EpicQuestBio/MR1/renders/nanopore_scale_showcase.gif

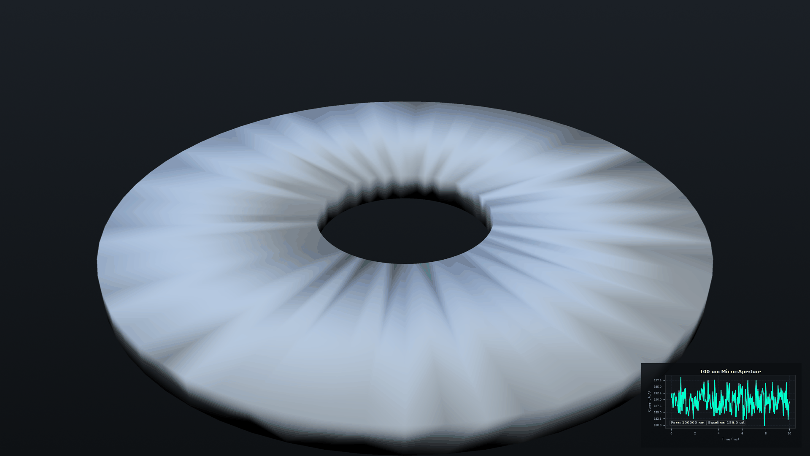
renders/nanopore_scale_showcase.gif
