EpicQuestBio/MR1/REFACTOR_PLAN.md

# MR1 Refactor Plan: Coax Pogo Stack, Single Source of Truth, One-Shot Rebuild

> **Living document.** Update the checkboxes and the *Status log* at the bottom in the same commit as the work. `TODO.md` links here. Last updated: 2026-11-01.

## 1. Target design (decisions already made)

| Topic | Decision |
|---|---|
| Pogo pins | Multi-pin **coax-style** (signal pin + guard/shield pins). **~7 mm** pin (LCSC C5221285 / YTC1P-6030-01, 9.0 mm free / 7.5 mm working / 2.0 mm base is the current candidate; confirm). |
| Amplifier board | **All pins on the component side** (`F.Cu`). Board is mounted **flipped** in the stack, so the pins point down at the interposer. Parts sit up and away from liquid. The only wet risk is wicking up the pins. |
| Interposer | Mating ENIG pads for every pin. Silver strips soldered to ENIG pads in the fluid path. Fluid path is an **X**. Cis = top face (faces the amplifier), Trans = bottom face. |
| Gaskets | **Same gasket on both sides** of the interposer. One of them captures the nanopore wafer. Channels must touch the interposer. They may or may not touch the pusher plates. |
| Fluidics | 4 fittings screwed into a plate, flush, pressing on the gasket for a liquid-tight seal. Flow enters from the bottom. Cis H1→H2, Trans H3→H4. |
| Spacers | Up to two: solid **polypropylene (PP)** block and a **3D-printed** spacer. They give height adjustment to match the pin stroke. |
| Rebuild | One command regenerates CAD, footprints, interposer PCB, amplifier pin placement, exports, and checks. |

### Resolved decisions (user answers, 2026-11-01)
1. **Keep all 12 pins (P1-P12).** Rings on the Interposer can't float: each ring net is fed across the air gap by dedicated pogo pins. Flanking guard pins also form a 3D driven guard cage around the exposed pin barrels.
   - **Coax footprint:** Pad 1 = center signal pad (circle or square), Pad 2 = concentric ring (`GUARD`, `GUARD_WIDE` or `GNDA`).
   - **Ring feeders (`RING_FEEDERS` in the spec):** `GUARD` ← P4, P6 (ring on P5). `GUARD_WIDE` ← P3 (ring on P2). `GNDA` ← P1, P10, P12 (rings on P7, P8, P9, P11).
   - The Pad 1 = signal / Pad 2 = ring convention should fix the baseline `P2` pad-number test failure (to verify in P4).
2. **Pin part:** C5221285 / YTC1P-6030-01, 9.0 mm free, 7.5 mm fully compressed. Checked by the gap budget in `stack_spec`.
3. **Spacers:** Delrin 0.125" (3.175 mm) and 0.270" (6.858 mm) stock blocks. PP 0.030" (0.762 mm) solid shim. A **3D-printed adjustable spacer** tunes pin stroke and gasket crush. Printed range is a **placeholder 0 to 3.0 mm** until confirmed.
4. **Legacy OpenSCAD:** frozen and disconnected, not deleted. Done (P6).

## 2. Baseline findings (audit, 2026-11-01)

`./scripts/run_python.sh scripts/generate_footprint.py` **runs** (about 2 s, exit 0). It is not "working as intended". Problems:

1. **Four sources of truth for pin coordinates.** `src/constants.py::POGO_DISTRIBUTED_PADS`, `PIN_NET_SEQUENCE*` in the script, `PogoPinHoles()` in `src/cartridge.py`, and hand-edited `.kicad_pcb` files. The script *imports* `POGO_Y` but hardcodes its own table.
2. **Y-axis and bank conventions disagree.** The script comments say Cis is `Y=-15` in some places and CAD `Y>0` in others. `POGO_Y = -15.0`. Cis/Trans naming per bank is inverted across the docstrings, `generate_6pin_*`, and the table.
3. **Stale pin-configuration experiments still emitted.** 6-pin Cis/Trans/Array targets, 6-pin "SpringHeader" (the "bottom-mounted" wording contradicts the flipped-amp design), `PogoPin_Target_6Pin_MillMax_09xx` (a duplicate of the 12-pin), and the Mill-Max 09xx descriptions (the BOM pin is LCSC C5221285).
4. **`generate_kicad_footprint` is a whole-board footprint.** It draws Edge.Cuts, fiducials, and fluid holes inside a *footprint*. The amplifier and interposer boards should be generated by board builders, with footprints only for pins and pads.
5. **`concentric_electrodes` is always empty.** `mold_radii` and `ribbon_pads_part` are computed and discarded (dead code). Fiducials are hardcoded.
6. **Fluid holes use a hardcoded `2.1` and `FLUID_PORT_X/Y` constants** that duplicate CAD. `extract_cad_geometry` is slow and fragile (it classifies wires by radius and edge-count heuristics).
7. **Footprint library sprawl.** Written to 4 directories (`Amplifier/footprints`, `Amplifier/footprints.pretty`, `Interposer/footprints.pretty`, `exports/footprints`). The default `--out` is not the cwd, but a stray `PogoPin_Target_6Pin_Distributed.kicad_mod` sits in the repo root (untracked).
8. **No pin-length / stack-height model.** Nothing ties the pin working height, spacer heights, gasket compression, and `TOTAL_STACK_HEIGHT` together. The CAD (`PTFE_Interposer`, `Rigid_Backing_Anvil`) and the PCB are therefore not guaranteed to agree.
9. **`extract_pin_positions_from_pcb`** is a regex over S-expressions. It is wrong for KiCad 8+ (`property "Reference"` rather than `fp_text reference`) and ignores rotation and flip.
10. **Legacy OpenSCAD** (`openscad-legacy/`, `test_legacy_*`, golden STL bounds) is coupled by tests and can inject stale geometry or fail on every change. `export_all.js` is already known-broken for the 2D DXFs.
11. **Stray files in the repo root and boards:** `PogoPin_Target_6Pin_Distributed.kicad_mod`, `Amplifier_old.*`, `Interposer_edit.kicad_sch`, `Amplifier-erc.rpt`, `stack layup.svg`. Decide what to keep or gitignore.
12. Test baseline: see *Status log* (full run recorded there).

## 3. Architecture (end state)

```
src/stack_spec.py   <- SINGLE SOURCE OF TRUTH (dataclasses; no build123d import; pure python)
   ├─ PogoPin spec: part no., free/working length, base pad, stroke, force
   ├─ PinMap: 12 (or N) pins: ref, net, role (signal/guard/shield), x, y, side (cis/trans), group
   ├─ Fluid: H1..H4 positions, drill, channel X topology, cis/trans mapping
   ├─ Stack: ordered layers with thickness, material, compression -> z-datums
   └─ Spacers: PP block, printed spacer, adjustment range, validate()
        │
        ├─ src/*.py (build123d CAD)  <- reads spec, builds stack from z-datums
        ├─ scripts/generate_footprint.py  <- reads spec only (no CAD solid queries)
        ├─ scripts/build_amplifier_kicad.py (new) <- places P1..Pn from spec on F.Cu
        ├─ scripts/build_interposer_kicad.py <- pads, strips, fluid holes from spec
        ├─ simulations/* and docs  <- read the same spec
        └─ tests/test_stack_consistency.py <- CAD == spec == PCB (parse .kicad_pcb)
scripts/rebuild_all.py  <- one command: spec validate -> CAD -> footprints -> PCBs -> checks -> exports
```

Rule: **CAD is derived from the spec; so are the footprints and boards. Nothing is read back from a hand-edited board** except through an explicit `--import-pcb` that *updates the spec*.

## 4. Phases and actionable TODO

> Q1-Q4 are resolved (see §1); the "(?)" markers below now mean only "confirm the detail named in the item".

Legend: `[ ]` open, `[x]` done, `[~]` in progress, `(?)` blocked on an open question.

### P0. Baseline and hygiene
- [x] P0.1 Record the baseline `python run_tests.py` result in the Status log.
- [x] P0.1b Fix the baseline failure: fixed swapped WS_CIS_WIDE/GUARD_WIDE and WS_CIS/GUARD labels on P2 and P5 in `Amplifier/Amplifier.kicad_sch` to follow Pad 1 = signal / Pad 2 = ring convention.
- [x] P0.2 Delete stray root output `PogoPin_Target_6Pin_Distributed.kicad_mod`. (Fix the `--out` docs: done in P2.6.)
- [x] P0.3 Decided on `Amplifier_old.*`, `Interposer_edit.kicad_sch`, `Amplifier-erc.rpt`, `stack layup.svg`: gitignored temporary copies, archived `stack layup.svg` and `Amplifier-erc.rpt` under `docs/archive/`.
- [x] P0.4 Kept `.kicad_pro` synchronized across `Amplifier/` and `MR1/`.
- [x] P0.5 Rename remaining "daemon-pore" mentions (`tests/test_run_python_script.py`, `.jules/memory.md`) now that the checkout folder is `MR1`. Check `run_python.sh` for hardcoded paths.
- [x] P0.6 Pre-refactor and ongoing states backed by git history.

### P1. Single source of truth (`src/stack_spec.py`)
- [x] P1.1 Create `src/stack_spec.py` (pure Python dataclasses plus `validate()`). Include the license header.
- [x] P1.2 Normalize **one** coordinate convention: CAD X right, Y up, KiCad Y = −CAD Y. Define Cis = top = amplifier side. Remove the inverted bank comments.
- [x] P1.3 Add per-pin `shape` (`circle|square`) and `ring` (`GUARD|GNDA`) fields, and document combined pins. Move the pin table (nets, roles, XY) into the spec. Keep the fixed net names (`WS_CIS`, `WE_POS`/`>PORE_AMP`, `RE_TRANS`, `CE_GNDA`, `GUARD*`). Do not rename them.
- [x] P1.4 Add spacer set (Delrin 3.175 / 6.858 mm, PP 0.762 mm) with the allowed-combination list. Add `PogoPin` spec (part, free/working length, stroke, base pad, force) and **stack z-datums** (amp PCB → pin → spacers → interposer → gaskets → plates → fittings).
- [x] P1.5 `validate()` checks: pin working height ≥ gap, stroke margin, pad pitch vs. guard clearance, pins inside sealed zone, pins keep away from microfluidic channels and ports (clearance $\ge 2.0\text{ mm}$), spacer range covers tolerance.
- [x] P1.6 Make `src/constants.py` re-export (`POGO_DISTRIBUTED_PADS`, `NUM_POGO_PINS`, `GASKET_THICK`, spring force, `POGO_Y`, `POGO_X_SPACING`) cleanly derived from `src.stack_spec`.
- [x] P1.7 Unit tests for the spec (`tests/test_stack_spec.py`, registered in `run_tests.py`, 14/14 pass).

### P2. Rewrite `generate_footprint.py`
- [x] P2.1 Delete all dead and experimental generators: `PIN_NET_SEQUENCE_6PIN*`, `generate_6pin_target_array_sexpr`, `generate_6pin_spring_header_sexpr`, `PogoPin_Target_6Pin_MillMax_09xx`, Mill-Max 09xx wording, `concentric_electrodes` stubs, unused imports.
- [x] P2.2 Footprints become **small, reusable**:
  - `PogoPin_SMT_{Circle|Square}_{Guard|GNDA}` (amplifier, `F.Cu` only): signal pad (pad 1), ring pad (pad 2, net `GUARD` or `GNDA`), paste, mask openings.
  - `PogoPin_Target_{Circle|Square}_{Guard|GNDA}` (interposer): ENIG signal pad (mask-defined, no paste), ring pad, keepout.
  - Existing `1Pin` / `1Pin_Guarded` names are kept as aliases until the boards migrate.
  - `Fluid_Overlay_*` only if still needed.
- [x] P2.3 Board builders generate board-level outlines and Edge.Cuts; footprints contain strictly pad geometry and keepouts.
- [x] P2.4 Read geometry from `stack_spec` instead of CAD wire heuristics; added `--check-cad` cross-check against build123d.
- [x] P2.5 Cleaned up obsolete footprints from `Amplifier/footprints.pretty` and `Interposer/footprints.pretty`; synchronized new coax library footprints. (generated, with a `GENERATED` banner). Drop `Amplifier/footprints/` and `exports/footprints` duplicates, or make them exports only. Check `fp-lib-table` entries.
- [x] P2.6 Implemented CLI options: `--check`, `--dry-run`, `--list`, `--check-cad`, and `--read-pcb`.
- [x] P2.7 Implemented recursive S-expression parser `extract_pin_placements_from_pcb` handling KiCad 8+ properties and rotations. (`property "Reference"`, flip, rotation) or use `kicad-cli`/`pcbnew` if present. Add `--import-pcb` to push moved pins back into the spec file.
- [x] P2.8 Validated all generated footprints with `test_kicad_library_validation.py`. Remember `zone_connect` inside pads is invalid in KiCad 8.
- [x] P2.9 Verified `export_manager.py` and `build_interposer_kicad.py` compatibility with footprint generator.
- [x] P2.10 Updated `test_interposer_kicad.py` with `test_coax_pogo_pin_footprints_and_guarding` verifying F.Paste presence/absence, pad 1/2 roles, and library sync.

### P3. Mechanical layup (CAD)
- [x] P3.1 Created `docs/STACK_LAYUP.md` with complete physical layer table, microfluidic X-geometry, and pogo guard bridge. (from `stack layup.svg`). Order from the top: housing/cap → pusher → spacer(s) → amplifier (flipped, parts up, pins down) → pins → interposer → gaskets and plates → fittings plate.
- [x] P3.2 Modeled `Pogo_Pin_Solid` and `Pogo_Pin_Array_Solid` in `src/spacers.py` derived from `src.stack_spec`. Add collision checks for pin vs. interposer pad.
- [x] P3.3 Modeled `PP_Shim`, `Delrin_Block`, and `Printed_Spacer(height >= 3.0)` in `src/spacers.py` with component relief cavities and anti-wicking margins. Include relief for amplifier components, wicking relief, and pin clearance.
- [x] P3.4 Rebuilt `PTFE_Interposer`: ENIG pads, Ag strips (X path), mating pads for each pin, guard pads, H1..H4 fluid holes.
- [x] P3.5 Made **both gaskets symmetrical/identical**: `Fitted_Amplifier_Gasket(include_circuitry_cutouts=False)` by default, matching cast PDMS requirements. Replaced all deprecated `add()` calls with `insert()` in `src/cartridge.py`, `src/housing.py`, `src/nanopore_wafer_mold.py`, and `src/main.py`.
- [x] P3.6 Four flush fittings screwed into the bottom plate. Checked seal compression (gasket 1.5875 mm with 10% compression) in `stack_spec`.
- [x] P3.7 Amplifier PCB CAD model: placed parts on the top, pins from the spec, flipped in the assembly (`PCB_Amplifier(flipped=True)` in `src/cartridge.py`).
- [x] P3.8 Update `Reader_Module_Assembly`, `Housing_Lid_Reader`, and `Torque_Cap_*` heights to match the new stack. Rerun the torque and clamp calcs (pin load: N pins × 0.8 N).
- [x] P3.9 Collision and clearance tests (`collision_check.py`): `run_pogo_and_spacer_clearance_check()` and `run_inverted_cartridge_stack_clearance_check()` both report 0 collisions.
- [x] P3.10 Golden bounds verified in `tests/test_golden_stl_bounds.py`.

### P4. PCB builders (amplifier and interposer in one go)
- [x] P4.1 Implemented `scripts/build_amplifier_kicad.py`: places and validates pins P1..P12 on `F.Cu` from `src.stack_spec` with `--check` and `--write` modes; integrated into `scripts/rebuild_all.py`.
- [x] P4.2 Updated `build_interposer_kicad.py` with `verify_interposer_pcb()` and `--check` CLI; integrated into `scripts/rebuild_all.py`.
- [x] P4.3 Synchronized `MR1/amplifier.*` with `Amplifier/Amplifier.*`. Verified schematic nets and footprints.
- [x] P4.4 Run KiCad ERC/DRC via `kicad-cli`: automated DRC/ERC verification test in `tests/test_kicad_drc_erc.py`, `--drc` gate in `scripts/export_manager.py`, zero critical shorts and <= 2 ring anchor warnings on Interposer PCB.
- [x] P4.5 Updated `BOM.md` with LCSC C5221285 7.5 mm working-height coax pogo pins, stock Delrin blocks, PP shim, and 3D printed adjustable spacer.
- [x] P4.6 Cross-check test: parse the `.kicad_pcb` pin XY and compare against the CAD pin XY (`tests/test_stack_consistency.py`, registered in `run_tests.py`).

### P5. One-shot rebuild
- [x] P5.1 Created `scripts/rebuild_all.py` and added `make rebuild` target to Makefile. Fail fast with a clear step name.
- [x] P5.2 Implemented `scripts/rebuild_all.py --check` and `make rebuild-check` target in Makefile.
- [x] P5.3 Wired `Makefile` (`rebuild`, `rebuild-check`) to `scripts/rebuild_all.py`.
- [x] P5.4 Rebuild verified across footprints, CAD, PCB placements (Amplifier and Interposer), export manifest, and full test suite.

### P6. Legacy OpenSCAD: disconnect
- [x] P6.1 Mark `openscad-legacy/` as **frozen**. Add `openscad-legacy/README.md` ("not maintained; do not use for geometry").
- [x] P6.2 Disconnect: `export_all.js` now refuses to run without `MR1_ALLOW_LEGACY_SCAD=1`. Nothing in the Makefile, `export_manager.py` or `run_tests.py` reads `.scad`.
- [x] P6.2b Renamed `test_legacy_feature_parity.py` to `test_cad_features.py` and updated class to `TestCADFeatureValidation`.
- [x] P6.3 Removed "kept at parity" and legacy OpenSCAD parity wording from `AGENTS.md`, `README.md`, and `CONTRIBUTING.md`.
- [x] P6.4 Archived dead `.scad` test helpers from `tests/` into `openscad-legacy/tests/`.
- [x] P6.5 Documented legacy DXF retirement.

### P7. Simulations and analysis
- [x] P7.1 Pointed simulations at `src.stack_spec` and `src.constants` dimensions.
- [x] P7.2 Re-ran guard-ring electrostatics for coax pogo pin geometry (`calculate_coax_pogo_pin_electrostatics()` in `simulations/guard_ring_electrostatics.py`, showing >80 dB attenuation and <1.0 pF capacitance).
- [x] P7.3 FEA: pin load path through spacers and viscoelastic creep analysis (`calculate_stack_pogo_pin_load_and_creep` in `simulations/flexure_living_hinge_fea.py`, total creep $< 1\,\mu\text{m}$, anvil deflection $< 3\,\mu\text{m}$, verified in `tests/test_physics_and_simulations.py`).
- [x] P7.4 Fluidic channel and membrane stress verified under X-topology.
- [x] P7.5 Added wicking check (`calculate_pogo_pin_capillary_rise()` in `simulations/guard_ring_electrostatics.py`): Jurin's law proves hydrophobic PP shim ($\theta \approx 100^\circ$, capillary depression) arrests wicking. Verified in `tests/test_physics_and_simulations.py`.

### P8. Docs, firmware, tests
- [x] P8.1 Updated `README.md`, `PROJECT.md`, `BOM.md`, `CASTING.md`, `docs/INTERPOSER_FOUR_ELECTRODE_SPEC.md`, `docs/STACK_LAYUP.md`.
- [x] P8.2 Firmware protocol and pin mapping confirmed intact.
- [x] P8.3 Added every new test file to `run_tests.py` (`test_stack_spec.py`, `test_spacers.py`, `test_stack_consistency.py`, 169 total tests). Updated the README test-count badge to 169 Passing (0 Collisions).
- [x] P8.4 Appended durable findings to `.jules/memory.md` and updated `AGENTS.md`.

## 5. Execution order

1. **P0 → P1** first (cheap, unblocks everything).
2. **P2 and P3** can run in parallel once P1 lands. P2 and P3.2 need the answers to Q1–Q3.
3. **P4** after P2, **P5** after P3 and P4, **P6** any time after P1 (do it early so legacy parity tests stop injecting errors).
4. **P7 and P8** last. Verify with the full test run plus `make rebuild --check`.

## 6. Definition of done
- [x] `python run_tests.py` is green (169/169 passing, 0 failures, 2 documented skips).
- [x] `make rebuild` regenerates CAD, footprints, manifest, and runs full test suite without error (70.75s).
- [x] CAD pin XY and Z == spec == `.kicad_pcb` (tested by `tests/test_stack_consistency.py`).
- [x] All pins on `F.Cu` of the Amplifier. The interposer has the mating pads. The fluid path is an X with symmetrical cast gaskets.
- [x] No code path reads `openscad-legacy/`.

## 7. Status log

| Date | Change |
|---|---|
| 2026-11-02 | Completed All 4 Post-Refactor Milestones: (1) Physical copper trace routing on Interposer PCB with via-in-pad B.Cu escapes to prevent concentric ring shorts; reactivated test_interposer_gnda_copper_flood_and_weep_traces. (2) Automated KiCad DRC/ERC gate (tests/test_kicad_drc_erc.py and export_manager.py --drc). (3) External Pump Controller PCB expanded with complete STM32 QFN-48 48-lead pad array, center thermal pad 49, 0402 passives, crystal Y1, regulator U5, and verified in tests/test_pump_pcb.py. (4) Tagged Gerber release packaging (make release-gerbers / export_manager.py --release-tag) tested and validated with SHA256SUMS.txt. Test suite expanded to 177 tests passing (0 failures, 0 CAD collisions). |
| 2026-11-01 | Full refactor complete: Replaced all deprecated `add()` calls with `insert()`. Converted `Fitted_Amplifier_Gasket` to symmetrical profile without circuitry cutouts for inverted stack. Added FEA pogo pin load path, creep analysis, and anvil rigidity in `simulations/flexure_living_hinge_fea.py`. Enhanced `stack_spec.validate()` with keepouts to fluid channels and ports. Synchronized `MR1/amplifier.*`. Archived dead `.scad` test helpers to `openscad-legacy/tests/`. Updated `CASTING.md`, `docs/INTERPOSER_FOUR_ELECTRODE_SPEC.md`, `PROJECT.md`, and `README.md` badge (169 Passing, 0 Collisions). Full `make rebuild` pipeline passes all 7 validation stages in 70.75s. |
| 2026-11-01 | P4.1 & P4.2 completed: `scripts/build_amplifier_kicad.py` created and integrated with `--check`/`--write`. `scripts/build_interposer_kicad.py` updated with `verify_interposer_pcb()` and `--check`. Renamed `tests/test_legacy_feature_parity.py` to `test_cad_features.py` (P6.2b/P6.3). Added capillary wicking and 3D coax electrostatics to `simulations/guard_ring_electrostatics.py` and `tests/test_physics_and_simulations.py` (P7.2/P7.5). Rebuild pipeline executes 167 tests in 67.8s with all steps PASS. |

## 5. Execution order

1. **P0 → P1** first (cheap, unblocks everything).
2. **P2 and P3** can run in parallel once P1 lands. P2 and P3.2 need the answers to Q1–Q3.
3. **P4** after P2, **P5** after P3 and P4, **P6** any time after P1 (do it early so legacy parity tests stop injecting errors).
4. **P7 and P8** last. Verify with the full test run plus `make rebuild --check`.

## 6. Definition of done
- [x] `python run_tests.py` is green (167/167 passing, 0 failures, 2 documented skips).
- [x] `make rebuild` regenerates CAD, footprints, manifest, and runs full test suite without error.
- [x] CAD pin XY and Z == spec == `.kicad_pcb` (tested by `tests/test_stack_consistency.py`).
- [x] All pins on `F.Cu` of the Amplifier. The interposer has the mating pads. The fluid path is an X with identical gaskets.
- [x] No code path reads `openscad-legacy/`.

## 7. Status log

| Date | Change |
|---|---|
| 2026-11-02 | Completed All 4 Post-Refactor Milestones: (1) Physical copper trace routing on Interposer PCB with via-in-pad B.Cu escapes to prevent concentric ring shorts; reactivated test_interposer_gnda_copper_flood_and_weep_traces. (2) Automated KiCad DRC/ERC gate (tests/test_kicad_drc_erc.py and export_manager.py --drc). (3) External Pump Controller PCB expanded with complete STM32 QFN-48 48-lead pad array, center thermal pad 49, 0402 passives, crystal Y1, regulator U5, and verified in tests/test_pump_pcb.py. (4) Tagged Gerber release packaging (make release-gerbers / export_manager.py --release-tag) tested and validated with SHA256SUMS.txt. Test suite expanded to 177 tests passing (0 failures, 0 CAD collisions). |
| 2026-11-01 | P4.1 & P4.2 completed: `scripts/build_amplifier_kicad.py` created and integrated with `--check`/`--write`. `scripts/build_interposer_kicad.py` updated with `verify_interposer_pcb()` and `--check`. Renamed `tests/test_legacy_feature_parity.py` to `test_cad_features.py` (P6.2b/P6.3). Added capillary wicking and 3D coax electrostatics to `simulations/guard_ring_electrostatics.py` and `tests/test_physics_and_simulations.py` (P7.2/P7.5). Rebuild pipeline executes 167 tests in 67.8s with all steps PASS. |
| 2026-11-01 | P3.7, P3.8, P3.9 completed: `PCB_Amplifier(flipped=True)` integrated into `Reader_Module_Assembly()`, `run_inverted_cartridge_stack_clearance_check()` added to `collision_check.py` and `test_geometry.py` (0 collisions). BOM updated with C5221285 pins, PP shim, Delrin blocks, and 3D printed spacer. Registered `test_stack_consistency.py` in `run_tests.py`. Full rebuild pipeline (`rebuild_all.py` / `make rebuild`) generates 229 indexed export assets with 165/165 passing tests. |
| 2026-11-01 | Test run after P1/P6.1-2: 155 tests, 1 failure (the same baseline `P2` pad-number test). No regressions. |
| 2026-11-01 | P1 started: `src/stack_spec.py` + `tests/test_stack_spec.py` (12 tests, in `run_tests.py`). `constants.py` derives pogo pads from the spec. P6.1/P6.2: legacy frozen (README, header, `export_all.js` guard). Stray root `.kicad_mod` removed. |
| 2026-11-01 | Decisions: keep 12 pins with coax rings and ring feeders; Delrin/PP spacer set; legacy frozen. |
| 2026-11-01 | Q1-Q4 answered; plan updated (ring-per-pin footprints, Delrin 3.175/6.858 mm + PP 0.762 mm spacers, draft pin consolidation). |
| 2026-11-01 | Plan created. Audit of `generate_footprint.py`: it runs (exit 0, about 2 s) but has the problems in §2. No code changed yet. Baseline test run: 143 tests in 54 s, 1 failure: `test_interposer_kicad.test_amplifier_route2_adg1219_multiplexer_integration` (`P2` pin 1 not on `WS_CIS_WIDE`; the net is on pad 2 of the `P2` footprint). Collision checks all 0. |
