EpicQuestBio/MR1/renders/nanopore_reverse_explosion.gif

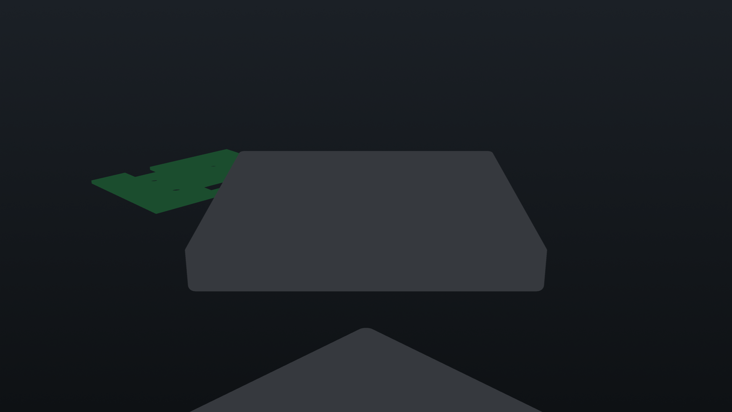
renders/nanopore_reverse_explosion.gif
