EpicQuestBio/MR1/renders/nanopore_wafer_zoom.gif

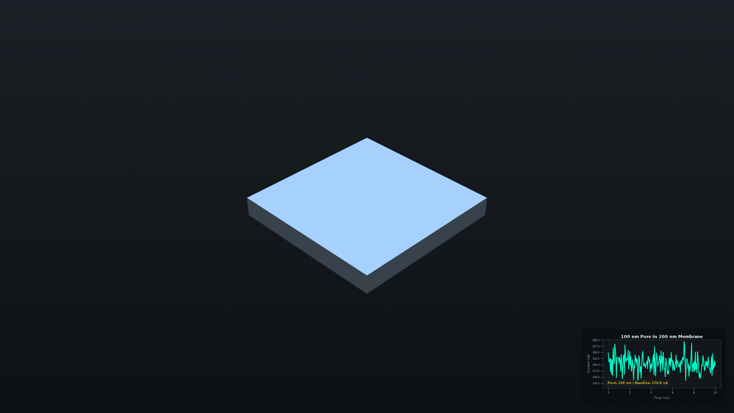
renders/nanopore_wafer_zoom.gif
