EpicQuestBio/MR1/datasheets/LJX39-PP0.stp

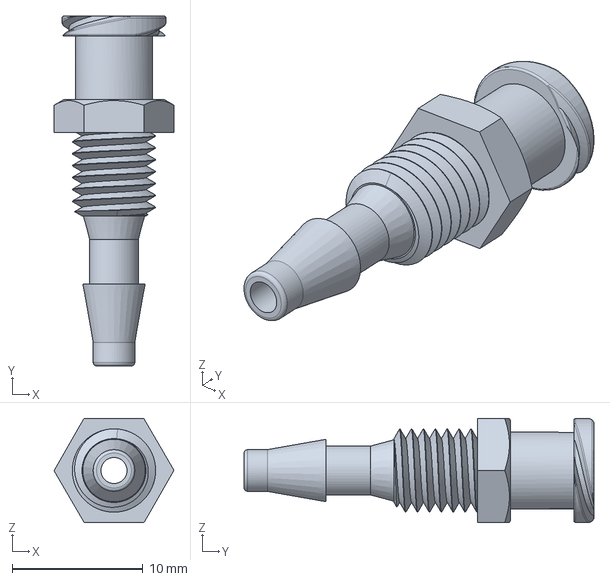
[picture p4: CAD file, 2026-03-28]
datasheets/LJX39-PP0.stp
9.19 x 26.8 x 7.98 mm
