EpicQuestBio/MR1/sentinel_nanopore_reader.scad

// ==============================================================================
// SENTINEL NANOPORE READER - REV 12 (Modular Split)
// Features: Torque-Lock Cap + Round Stack + Bottom Integration + Internal Layout
// ==============================================================================

include <constants.scad>
include <modules/common.scad>
include <modules/cartridge.scad>
include <modules/housing_pump.scad>
include <modules/torque_cap.scad>
include <modules/housing_reader.scad>
include <nanopore_wafer_mold.scad>
include <modules/elbow_adapter.scad>
include <modules/threaded_adapter.scad>


// ==============================================================================
// MAIN RENDER LOGIC
// ==============================================================================

if (Output_Mode == "Assembly") {

    difference() {
        union() {
            // Bottom Unit: Pump Module
            Pump_Module_Assembly();

            // Top Unit: Reader Module
            // Sits on top of Pump Module (Height pump_h + pump_lid_thick)
            translate([0,0, pump_h + pump_lid_thick + Explode_Factor]) {
                Reader_Module_Assembly();
            }

            // Optional 2-Part Silicone Mold Assemblies and Gaskets
            if (Show_Mold) {
                translate([-130, 0, 0]) {
                    Multi_Mold_Visualizer();
                }
            }

            // External Tubing Loops (Visual)
            // Connecting Pump Module Side Ports -> Reader Module Side Ports
            if(!Cross_Section) {
                color("DeepSkyBlue") {
                    // Pump Out (Right Side) -> Reader In (Right Side)
                    // Visual loop on the side

                    // Coordinates
                    p0 = [base_w/2 + 10, 20, pump_h/2]; // Pump Out (Right)
                    p1 = [base_w/2 + 30, 20, pump_h/2]; // Out Clearance
                    p2 = [base_w/2 + 30, 20, pump_h + wall + reader_h - 5]; // Up Z
                    p3 = [base_w/2 + 10, 20, pump_h + wall + reader_h - 5]; // Reader In (Right)

                    hull() { translate(p0) sphere(d=4); translate(p1) sphere(d=4); }
                    hull() { translate(p1) sphere(d=4); translate(p2) sphere(d=4); }
                    hull() { translate(p2) sphere(d=4); translate(p3) sphere(d=4); }
                }
            }
        }

        if(Cross_Section) {
            translate([0, -100, -10]) cube([200, 200, 300]);
        }
    }

    // Labels
    if (Explode_Factor > 0) {
        color("Black") {
            translate([0, -base_l/2 - 20, 0]) text("Rev 12: Modular Split", halign="center");
            translate([150, 0, pump_h + reader_h + neck_h + Explode_Factor*3.5 + 30]) text("Torque-Lock Cap", halign="center");
        }
    }

// --- DXF / STL EXPORTS ---
} else if (Output_Mode == "Plate_1_Base_DXF") {
    Plate_1_Base_Hex();
} else if (Output_Mode == "Plate_2_Channel_DXF") {
    // Legacy name for Carrier Frame
    Carrier_Frame_Hex();
} else if (Output_Mode == "Plate_3_Top_DXF") {
    Plate_3_Top_Hex_2D();
} else if (Output_Mode == "Gasket_Main_DXF") {
    Gasket_Low_Dead_Volume(type="top");
} else if (Output_Mode == "Gasket_Top_DXF") {
    Gasket_Low_Dead_Volume(type="top");
} else if (Output_Mode == "Gasket_Bottom_DXF") {
    Gasket_Low_Dead_Volume(type="bottom");
} else if (Output_Mode == "Gasket_Mold_Top_STL") {
    if (Use_Nanopore_Wafer_Gasket) {
        translate([0, 0, mold_t/2]) rotate([0, 90, 0])
        Nanopore_Wafer_Mold_Right(type="top", is_nanopore=true);
    } else {
        Gasket_Mold_3D(type="top");
    }
} else if (Output_Mode == "Gasket_Mold_Bottom_STL") {
    if (Use_Nanopore_Wafer_Gasket) {
        translate([0, 0, mold_t/2]) rotate([0, -90, 0])
        Nanopore_Wafer_Mold_Left(type="top", is_nanopore=true);
    } else {
        Gasket_Mold_3D(type="bottom");
    }
} else if (Output_Mode == "Amplifier_Gasket_Mold_Left_STL") {
    translate([0, 0, mold_t/2]) rotate([0, -90, 0])
    Nanopore_Wafer_Mold_Left(type="bottom", is_nanopore=false);
} else if (Output_Mode == "Amplifier_Gasket_Mold_Right_STL") {
    translate([0, 0, mold_t/2]) rotate([0, 90, 0])
    Nanopore_Wafer_Mold_Right(type="bottom", is_nanopore=false);
} else if (Output_Mode == "Housing_Pump_Case_STL") {
    Housing_Pump_Case();
} else if (Output_Mode == "Housing_Pump_Lid_STL") {
    Housing_Pump_Lid();
} else if (Output_Mode == "Housing_Reader_Case_STL") {
    Housing_Case_Reader();
} else if (Output_Mode == "Housing_Reader_Lid_STL") {
    Housing_Lid_Reader();
} else if (Output_Mode == "Torque_Cap_Outer_STL") {
    Torque_Cap_Outer();
} else if (Output_Mode == "Torque_Cap_Inner_STL") {
    Torque_Cap_Inner();
} else if (Output_Mode == "Pressure_Puck_STL") {
    Pressure_Puck_3D();
} else if (Output_Mode == "Bottom_Pusher_Plate_STL") {
    Bottom_Pusher_Plate(show_orings=false);
} else if (Output_Mode == "PCB_DXF") {
    // Mapped to Main Reader PCB as per instruction
    PCB_Main_Reader_2D();
} else if (Output_Mode == "PCB_Main_Reader_DXF") {
    PCB_Main_Reader_2D();
} else if (Output_Mode == "PCB_Amplifier_DXF") {
    PCB_Amplifier_2D();
} else if (Output_Mode == "PCB_Nanopore_Carrier_DXF") {
    PCB_Nanopore_Carrier_2D();
}
