EpicQuestBio/MR1/tests/repro_colors.scad

include <../constants.scad>
include <../modules/cartridge.scad>

Cartridge_Stack_3D();
