EpicQuestBio/MR1/(list of files, cad)

Other CAD files:
test_handle.scad
test_render.scad
test_verify.scad
datasheets/LJX39-PP0.stl
openscad-legacy/constants.scad
openscad-legacy/modules/cartridge.scad
openscad-legacy/modules/common.scad
openscad-legacy/modules/housing_pump.scad
openscad-legacy/modules/housing_reader.scad
openscad-legacy/mr1_nanopore_reader.scad
openscad-legacy/nanopore_wafer_mold.scad
openscad-legacy/test_handle.scad
openscad-legacy/test_render.scad
openscad-legacy/test_verify.scad
