EpicQuestBio/MR1/MR1/PDF/MR1.pdf

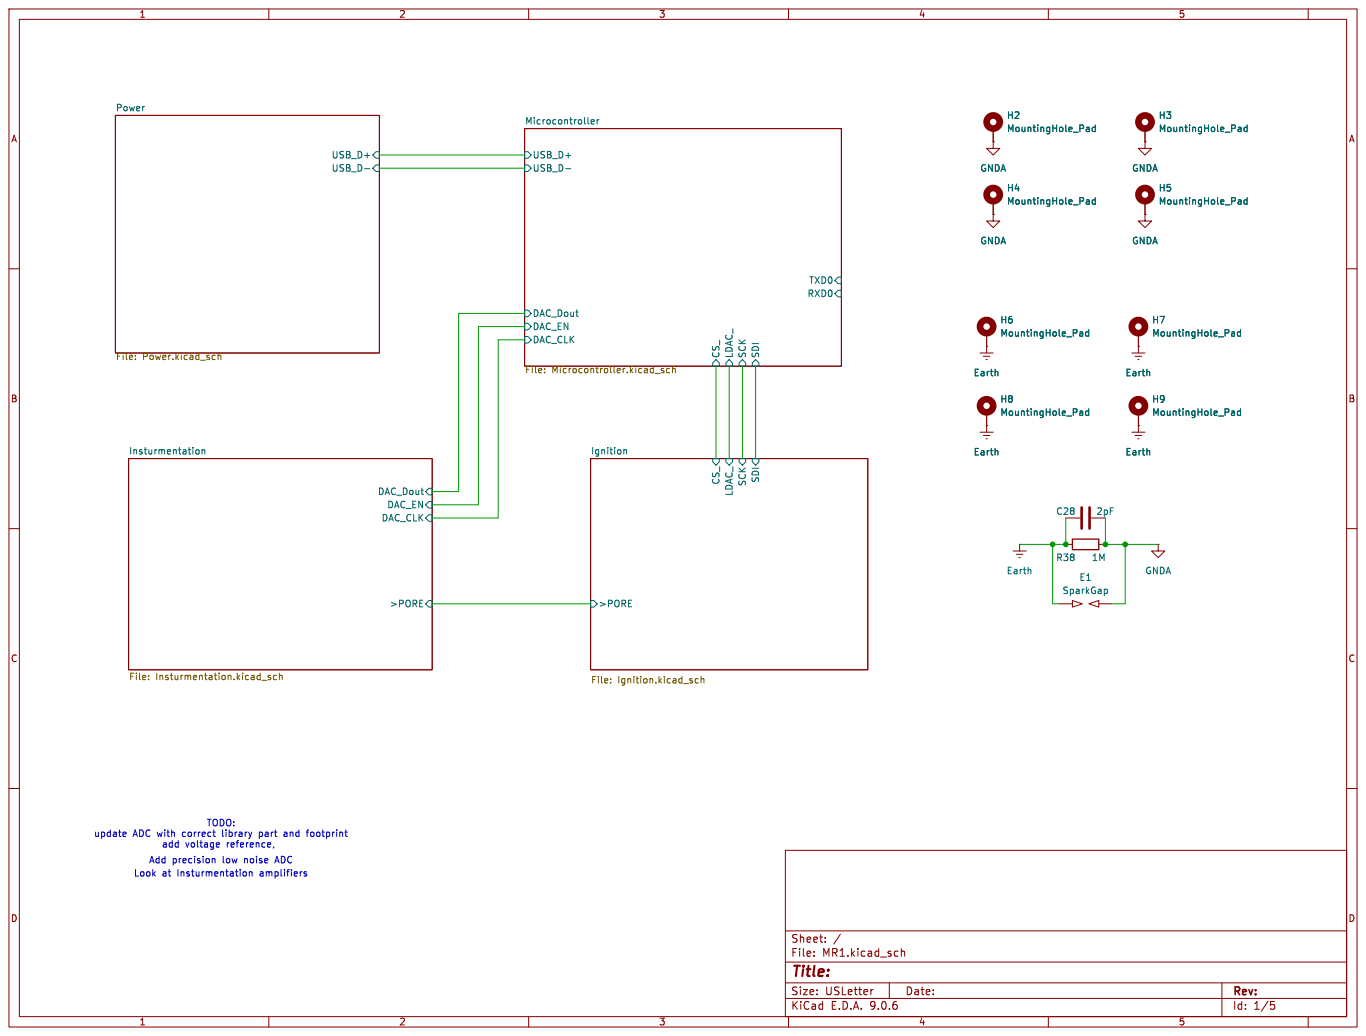
[picture p5: page 1]

Id: 1/5 Title: File: MR1.kicad_sch Sheet: /

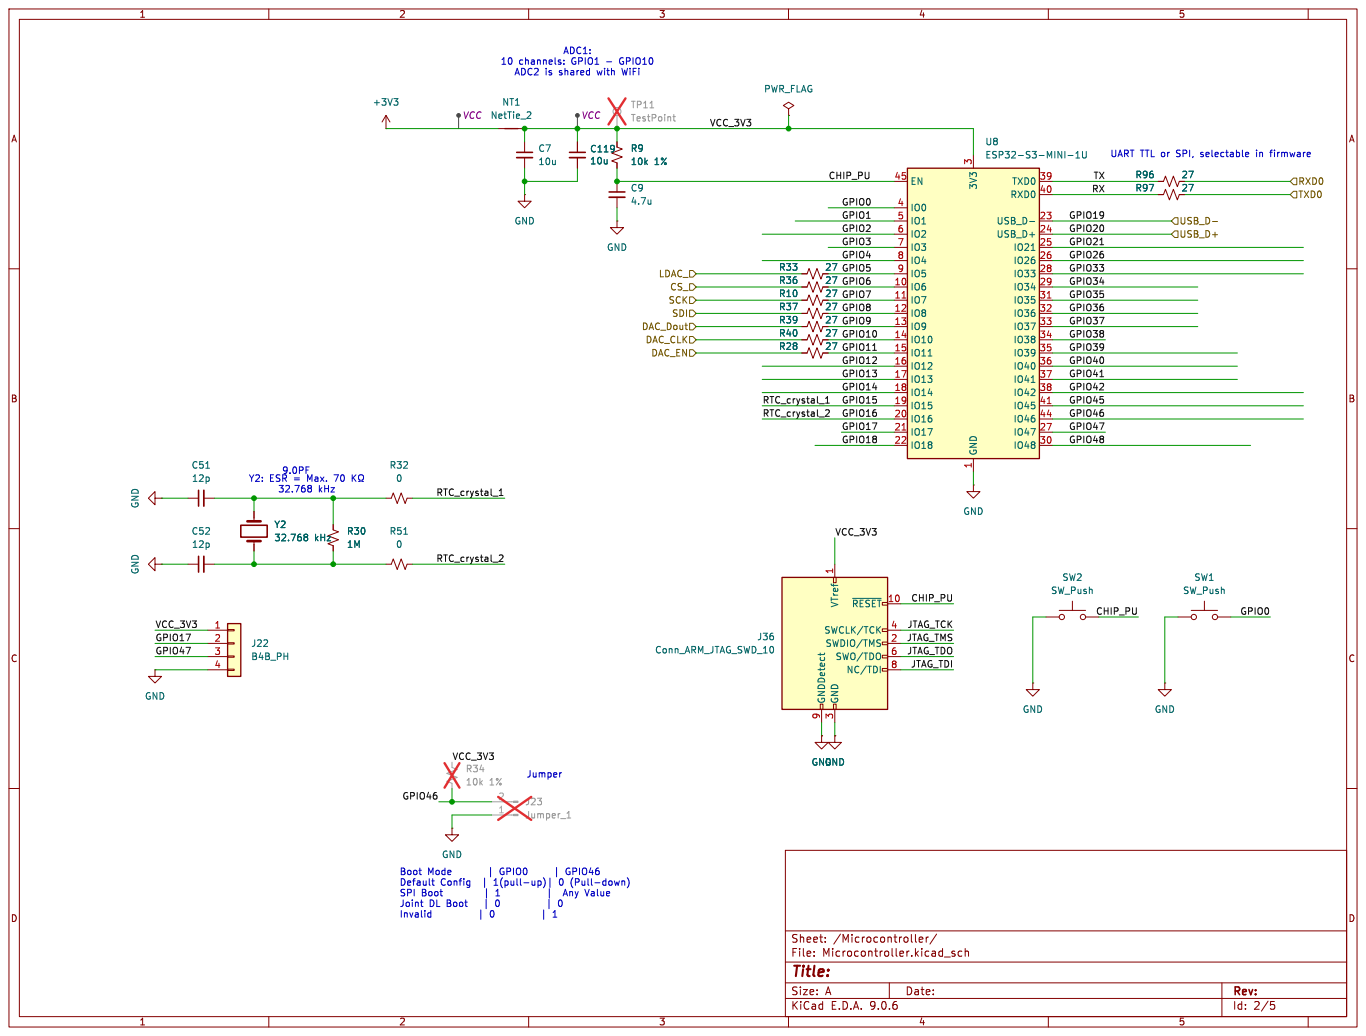
[picture p6: page 2]

Id: 2/5 Title: File: Microcontroller.kicad_sch Sheet: /Microcontroller/ Y2

3 ~{RESET}10 SWCLK/TCK 4 SWDIO/TMS 2 SWO/TDO 6 NC/TDI 8

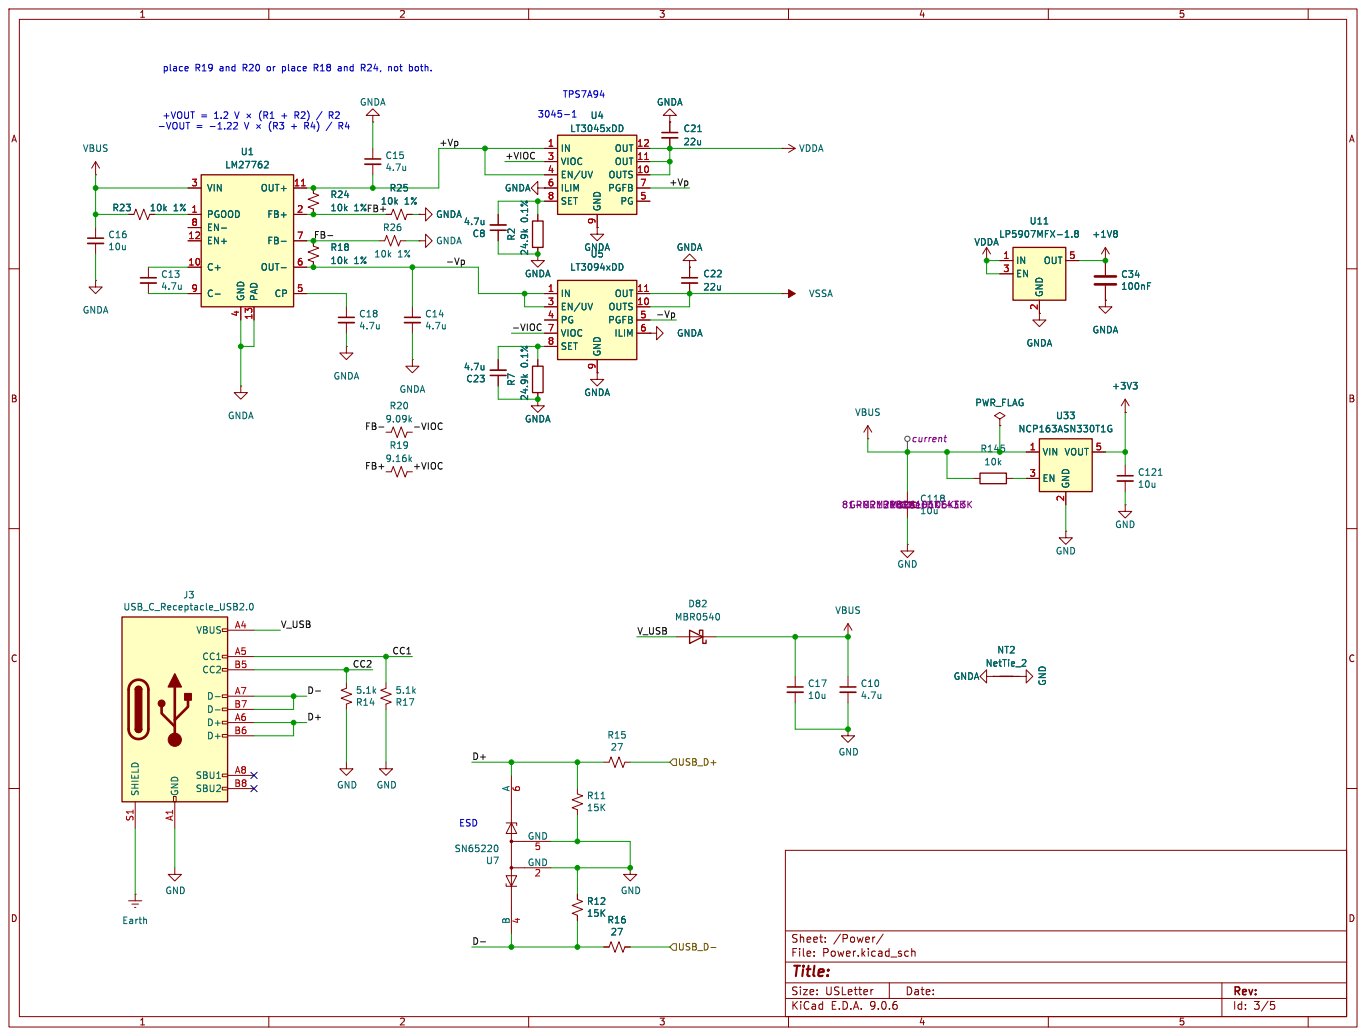
[picture p7: page 3]

9 OUT 12 OUT 11 OUTS 10 PGFB 7 PG 5 U4
LT3045xDD

9 OUT 12 OUT 11 OUTS 10 PGFB 7 PG 5 GNDA GNDA U5
+VIOC

4 PAD 13 OUT+ 11 FB+ 2 FB- 7 OUT- 6 CP 5 U1

4 PAD 13 OUT+ 11 FB+ 2 FB- 7 OUT- 6 CP 5 GNDA GNDA

Id: 3/5 Title: File: Power.kicad_sch Sheet: /Power/

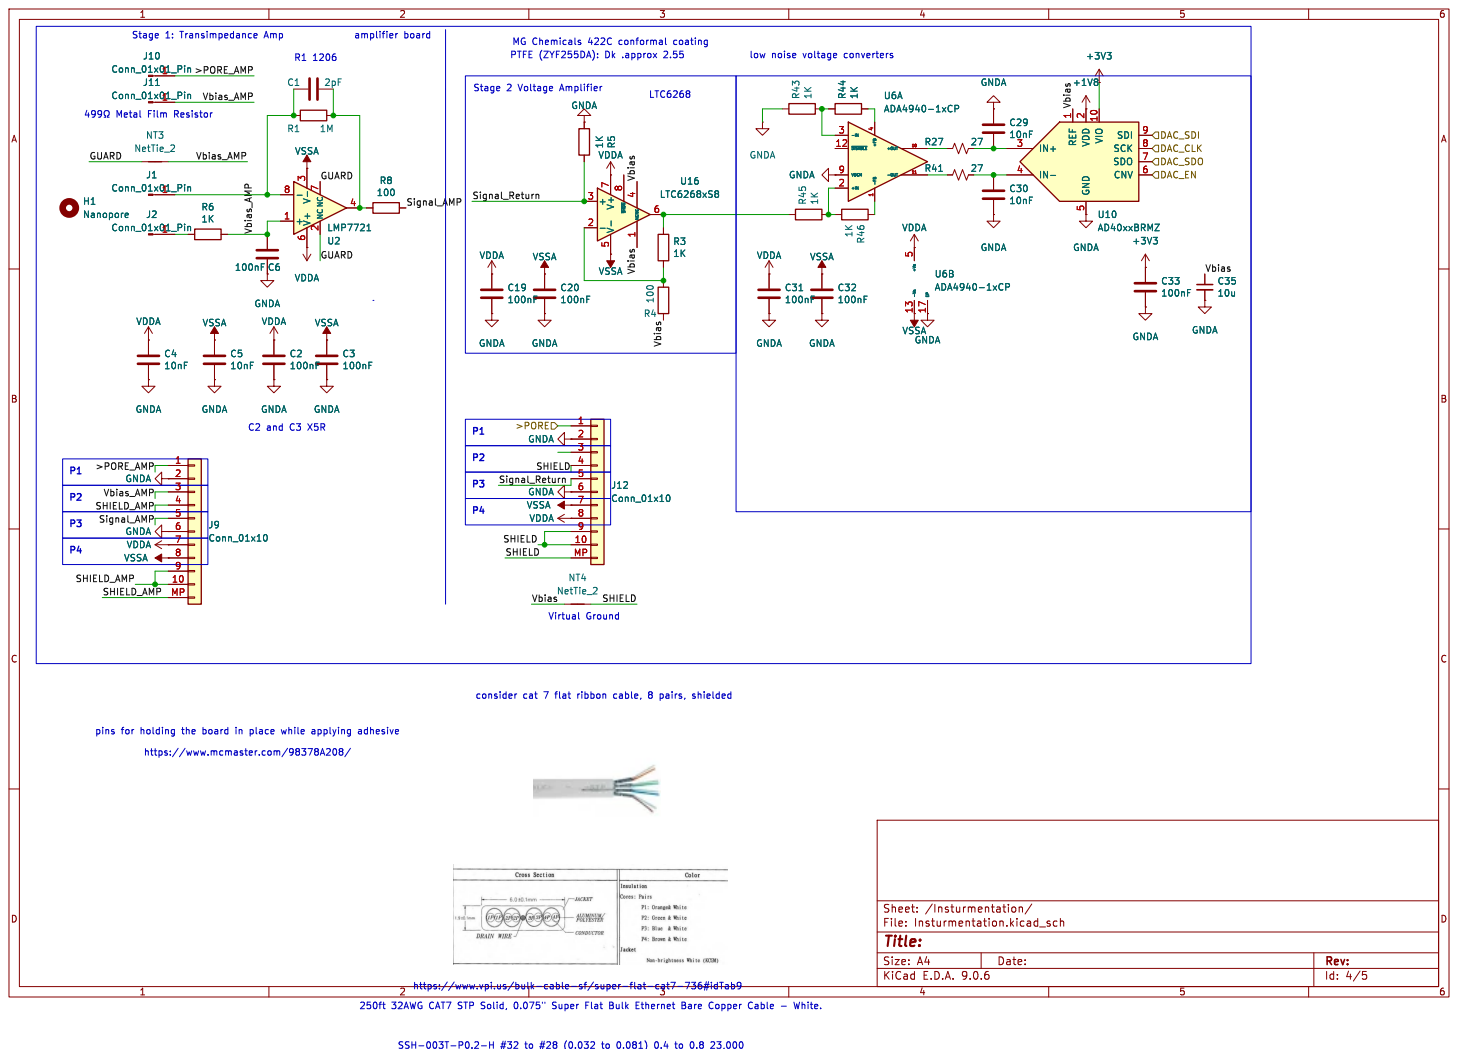
[picture p8: page 4]

low noise voltage converters P1

5 VIO 10 SDI 9 SCK 8 SDO 7 CNV 6 U10 AD40xxBRMZ GNDA C1 2pF C29

5 VIO 10 SDI 9 SCK 8 SDO 7 CNV 6 C30

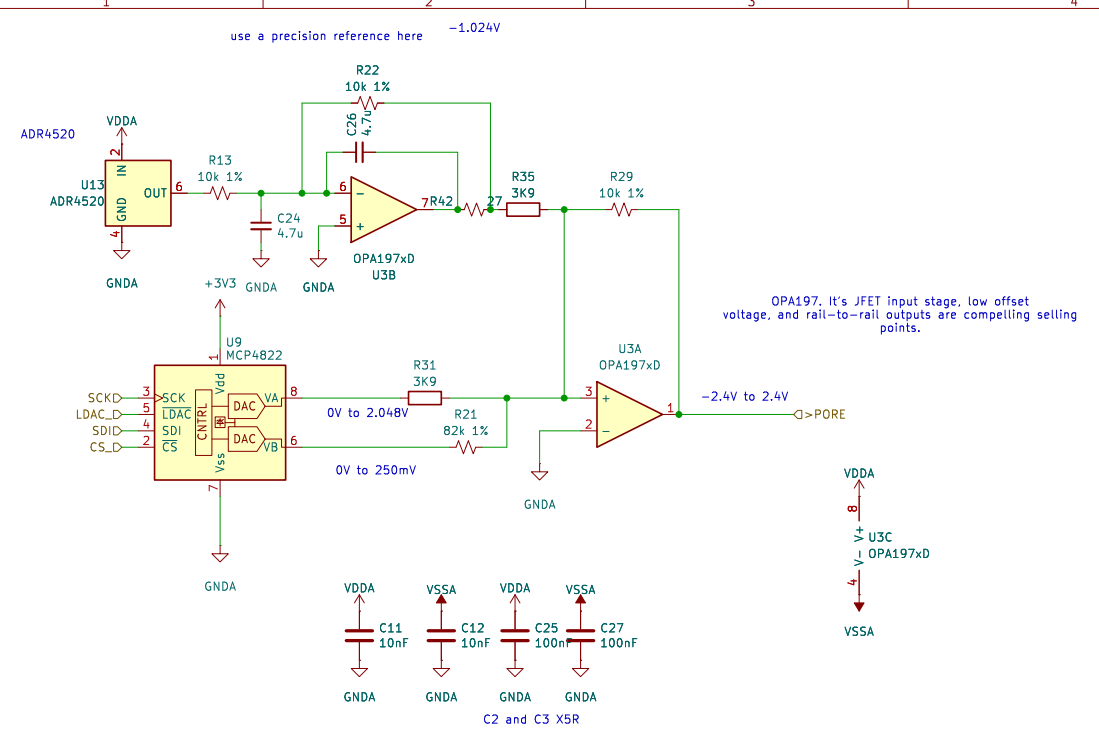
[picture p9: page 5]

1 Vss 7 VA 8 VB 6 U9 MCP4822 GNDA

Id: 5/5 Title: File: Ignition.kicad_sch Sheet: /Ignition/ VSSA
