EpicQuestBio/MR1/Amplifier/Amplifier.kicad_pcb

## KiCad design Amplifier/Amplifier.kicad_pcb (2026-11-03)

Schematic: Amplifier.kicad_sch

Parts:
C1: 2pF; C_0402_1005Metric; LCSC C161316
C3: 15pF; C_0402_1005Metric; LCSC C33148
C6, C9, C14, C20: 100nF; C_0402_1005Metric; LCSC C49678
C7, C8: 10nF; C_0402_1005Metric; LCSC C1525
C10, C12, C19, C31, C32, C33, C34, C39: 100nF; C_0402_1005Metric; LCSC C15255
C11: 4.7u; C_0402_1005Metric; Manufacturer_Part_Number JMK107C6475KA-T; LCSC C19702
C29, C30: 10pF; C_0402_1005Metric; LCSC C1548
C35: 10u; C_0402_1005Metric; MPN GRM21BR61H106KE43K; LCSC C1713
C40, C42: 100nF; C_0402_1005Metric; Mouser PN 710-885012205037; LCSC C15255
C41: 1nF; C_0402_1005Metric; LCSC C1523
D82: MBR0540; D_SOD-123; MPN MBR0540L-TP; LCSC C5204747
FB1, FB2: HZ0402A152R-10; L_0402_1005Metric; LCSC C442654
J7: Conn_01x14_MountingPin; Amphenol_F32R-1A7x1-11014_1x14-1MP_P0.5mm_Horizontal; LCSC C2856818
NT3, NT4, NT5, NT6, NT7, NT8: NetTie_2; NetTie-2_SMD_Pad0.5mm
P1, P3, P4, P6, P7, P8, P9, P10, P11, P12: PogoPin_MillMax_SMT_1Pin
P2, P5: PogoPin_MillMax_SMT_1Pin_Guarded; PogoPin_SMT_Circle_Guard_Notched
Q3: 2N7002; SOT-23; LCSC C8545
R1: 1G; R_0402_1005Metric; LCSC HVC0805T1007JET
R3, R5: 1K; R_0402_1005Metric; LCSC C17513
R4: 100; R_0402_1005Metric; LCSC C25097
R6, R9: 1K; R_0402_1005Metric; LCSC C25149
R8: 100; R_0402_1005Metric; LCSC C17408
R10, R14, R15: 100k; R_0402_1005Metric; LCSC C60491
R16: 1M; R_0402_1005Metric; LCSC C25488
R27, R41: 27; R_0402_1005Metric; MPN RC0402JR-0727RL; LCSC C25078
R28, R29, R30, R31, R32, R33: 49.9; R_0402_1005Metric; MPN RC0402JR-0727RL; LCSC C4074199
R43, R44, R45, R46: 499 (0.1%); R_0402_1005Metric; LCSC C25132
SYM1: SYM_Arrow45_Large; Fluid_Overlay_SILKSCREEN_ONLY
U2: LMP7721; SOIC-8_3.9x4.9mm_P1.27mm; Mouser PN 926-LMP7721MA/NOPB
U5: OPA2192IDR; SOIC-8_3.9x4.9mm_P1.27mm; MPN OPA2192IDR; LCSC C110074
U6: ADA4940-1xCP; LFCSP-16-1EP_3x3mm_P0.5mm_EP1.3x1.3mm_ThermalVias; MPN ADA4940-1ACPZ-RL; LCSC C529241
U13: AD40xxBRMZ; MSOP-10_3x3mm_P0.5mm; MPN AD4011BCPZ-RL7; LCSC C539308
U14: LP5907MFX-1.8; SOT-23-5; MPN LP5907MFX-1.8/NOPB; LCSC C92498
U16: LTC6268xS8; SO-8_3.9x4.9mm_P1.27mm; MPN LTC6268IS8#TRPBF; LCSC C689169
U17: ADG1219BRMZ; MSOP-8_3x3mm_P0.65mm; MPN ADG1219BRMZ; LCSC C206796

Connections:
+1V8: C11.1, U13.2 (VDD), U14.5 (OUT)
+3.3VA: C33.1, FB1.2, FB2.1, R14.1, U13.10 (VIO)
+3V3: FB1.1, J7.1, U17.1 (EN)
/>PORE_AMP: J7.14, P9.1 (PIN_1)
/CE_GNDA: NT8.1, P7.1 (PIN_1)
/GDAC_CLK: R31.1, U13.8 (SCK)
/GDAC_EN: R29.1, U13.6 (CNV)
/GDAC_SDI: R30.1, U13.9 (SDI)
/GDAC_SDO: R28.1, U13.7 (SDO)
/GNDA_SHLD: P1.1 (PIN_1)
/GUARD: NT3.1, NT5.2, P4.1 (PIN_1), P5.2 (GUARD), P6.1 (PIN_1), U2.2 (NC), U2.7 (NC)
/GUARD_WIDE: NT5.1, P2.2 (GUARD), P3.1 (PIN_1), U5.6 (-), U5.7
/RE_TRANS: P8.1 (PIN_1), R6.2, R9.2
/ROUTE_SEL: R33.1, U17.8 (IN)
/R_WEEP_GATE: D82.1 (K), R15.2, R16.1
/R_WEEP_LIM: P11.1 (PIN_1), R15.1
/R_WEEP_PULL: Q3.3 (D), R14.2, U14.3 (EN)
/Route1_OUT: C9.1, R3.1, U16.6, U17.7 (SA)
/Route2_OUT: R32.2, U17.5 (SB)
/SHIELD: NT7.2
/SHIELD_AMP: J7.MP (MountPin), NT4.2
/Signal_Return: R45.1, U17.6 (D)
/Vbias: C6.1, C14.1, C35.1, NT3.2, R4.1, R6.1, R9.1, U2.1 (+), U5.3 (+), U5.5 (+), U13.1 (REF), U16.1 (NC), U16.4 (NC)
/Virtual_Ground: C9.2, R3.2, R4.2, U16.2 (-)
/WS_CIS: C1.2, P5.1 (SIG), R1.2, U2.8 (-)
/WS_CIS_WIDE: C3.2, P2.1 (SIG), R10.2, U5.2 (-)
GND: J7.2, J7.8
unnamed: C1.1, R1.1, R8.2, U2.4
unnamed: C39.1, NT7.1
unnamed: J7.3, R31.2
unnamed: J7.4, R33.2
unnamed: J7.5, R28.2
unnamed: J7.6, R29.2
unnamed: J7.7, R30.2
unnamed: Q3.1 (G), R16.2
unnamed: C3.1, R10.1, R32.1, U5.1
unnamed: R44.2, U6.4 (+FB)
unnamed: R45.2, R46.2, U6.2 (+IN)
unnamed: R27.1, U6.10 (+OUT)
unnamed: R46.1, U6.1 (-FB)
unnamed: R43.2, R44.1, U6.3 (-IN)
unnamed: R41.1, U6.11 (-OUT)
unnamed: C29.2, C41.1, R27.2, U13.3 (IN+)
unnamed: C30.1, C41.2, R41.2, U13.4 (IN-)
unnamed: C34.1, FB2.2, U14.1 (IN)
unnamed: R5.1, R8.1, U16.3 (+)
VDDA: C7.1, C10.1, C19.1, C31.1, C40.1, J7.10, U2.6 (V+), U5.8 (V+), U6.5 (+Vs), U6.6 (+Vs), U6.7 (+Vs), U6.8 (+Vs), U16.7 (V+), U17.2 (VDD)
VSSA: C8.1, C12.1, C20.1, C32.1, C42.1, J7.12, U2.3 (V-), U5.4 (V-), U6.13 (-Vs), U6.14 (-Vs), U6.15 (-Vs), U6.16 (-Vs), U16.5 (V-), U17.4 (VSS)

Notes on the sheet:
SM10B-SRSS-TB
3. Selecting the Precision ADC To capture <1µV signals, you need a 24-bit or 32-bit Delta-Sigma ADC. The standard 12-bit or 16-bit SAR ADCs used in microcontrollers will not see the signal floor you have created. Top Recommendations: TI ADS1261 (24-bit / 32-bit mode): Why: It has a built-in PGA (Pr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
Ceramic capacitors are piezoelectric – mechanical vibrations and noises will create charge across the capacitor. Be careful when using ceramic caps in the input, integration, feedback or biasing networks.
LTC6268
consider cat 7 flat ribbon cable, 8 pairs, shielded
low noise voltage converters
Stage 2 Voltage Amplifier
R1 1206
Stage 1: Transimpedance Amp
Stability in ultra-low noise regulators is dictated by the **Output Capacitance ()** and the **Noise Reduction Capacitance ()**. If these ratios are wrong, the LDO will oscillate, turning your "clean" power supply into a radio transmitter. ### 1. The LDO Component Values (The Critical Stage) These 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
https://www.vpi.us/bulk-cable-sf/super-flat-cat7-736#idTab9
R_DAMP
MG Chemicals 422C conformal coating
amplifier board
RF-damping capacitor
For high-speed nanopore sensing, the answer is definitive: **Do NOT tie them together.** You should use **Separate Voltage References** (or at least strictly buffered separate paths) for your ADC and your Bias Driver. Here is the engineering reality of why sharing a "Reference Rail" will introduce 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
No, the schematic recipe I provided above is **Fixed Gain (10x)**. It uses a standard resistor, so the zoom level is locked. Since you are removing the MAX9939 (which *was* a variable gain amplifier), you likely want to keep that functionality—especially since Nanopores vary wildly in current. A 1 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
PTFE (ZYF255DA): Dk .approx 2.55
499Ω Metal Film Resistor
we need to play back a waveform
250ft 32AWG CAT7 STP Solid, 0.075" Super Flat Bulk Ethernet Bare Copper Cable - White.
Using an **Optically Isolated Current Source (LED + Photodiode)** is the "Ferrari" of dummy loads for nanopore amplifiers. While the resistor method (like in the EarlGrey PDF) is great for checking baseline noise, the LED/Photodiode method is superior for checking **bandwidth** and **step response*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
pins for holding the board in place while applying adhesive https://www.mcmaster.com/98378A208/
SSH-003T-P0.2-H #32 to #28 (0.032 to 0.081) 0.4 to 0.8 23,000
SHR-10V-S
C2 and C3 X5R

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
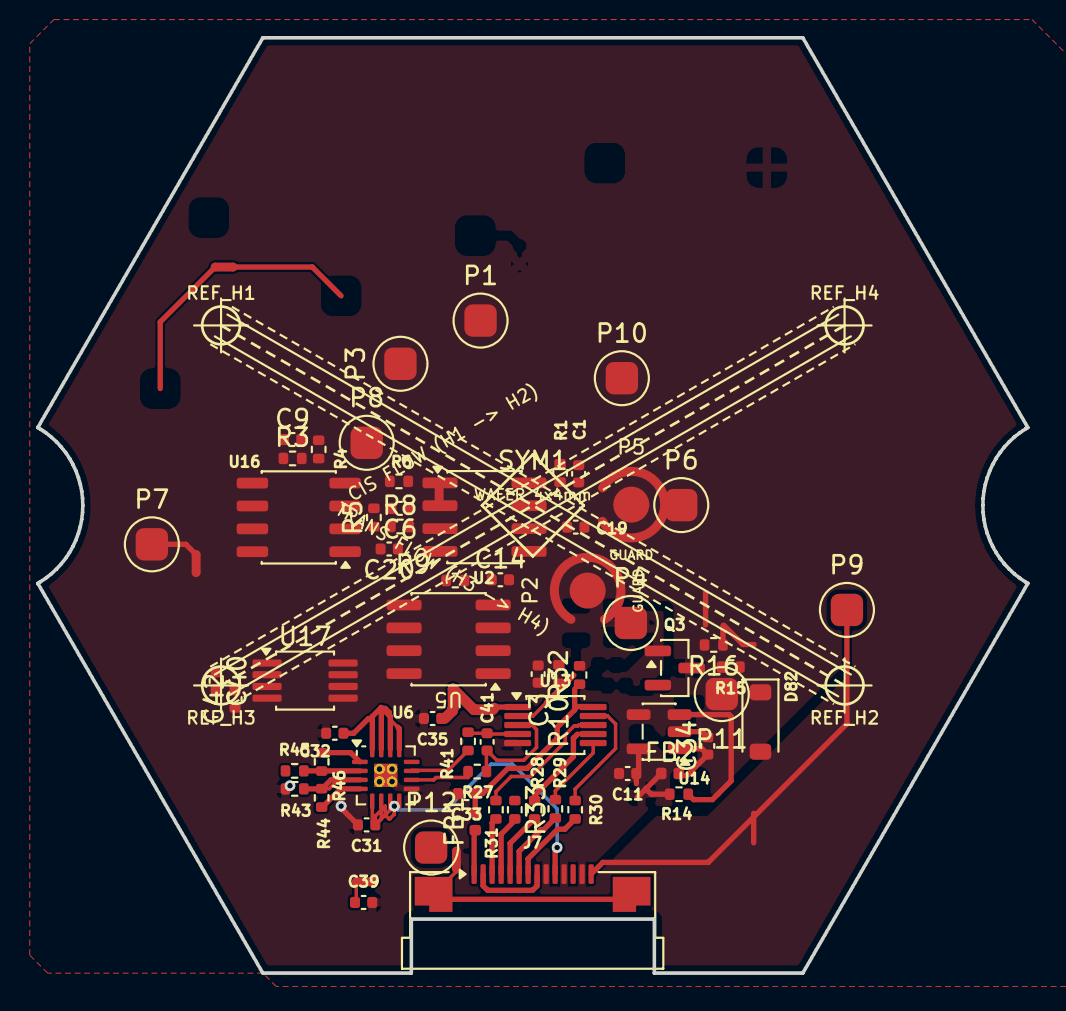
[picture p10: board Amplifier.kicad_pcb from above]

Board: 2 copper layers, 55.0 x 52.0 mm, 70 parts (0 on the bottom side), 47 nets.
