EpicQuestBio/MR1/MR1/MR1.kicad_pcb

## KiCad design MR1/MR1.kicad_pcb (2026-11-03)

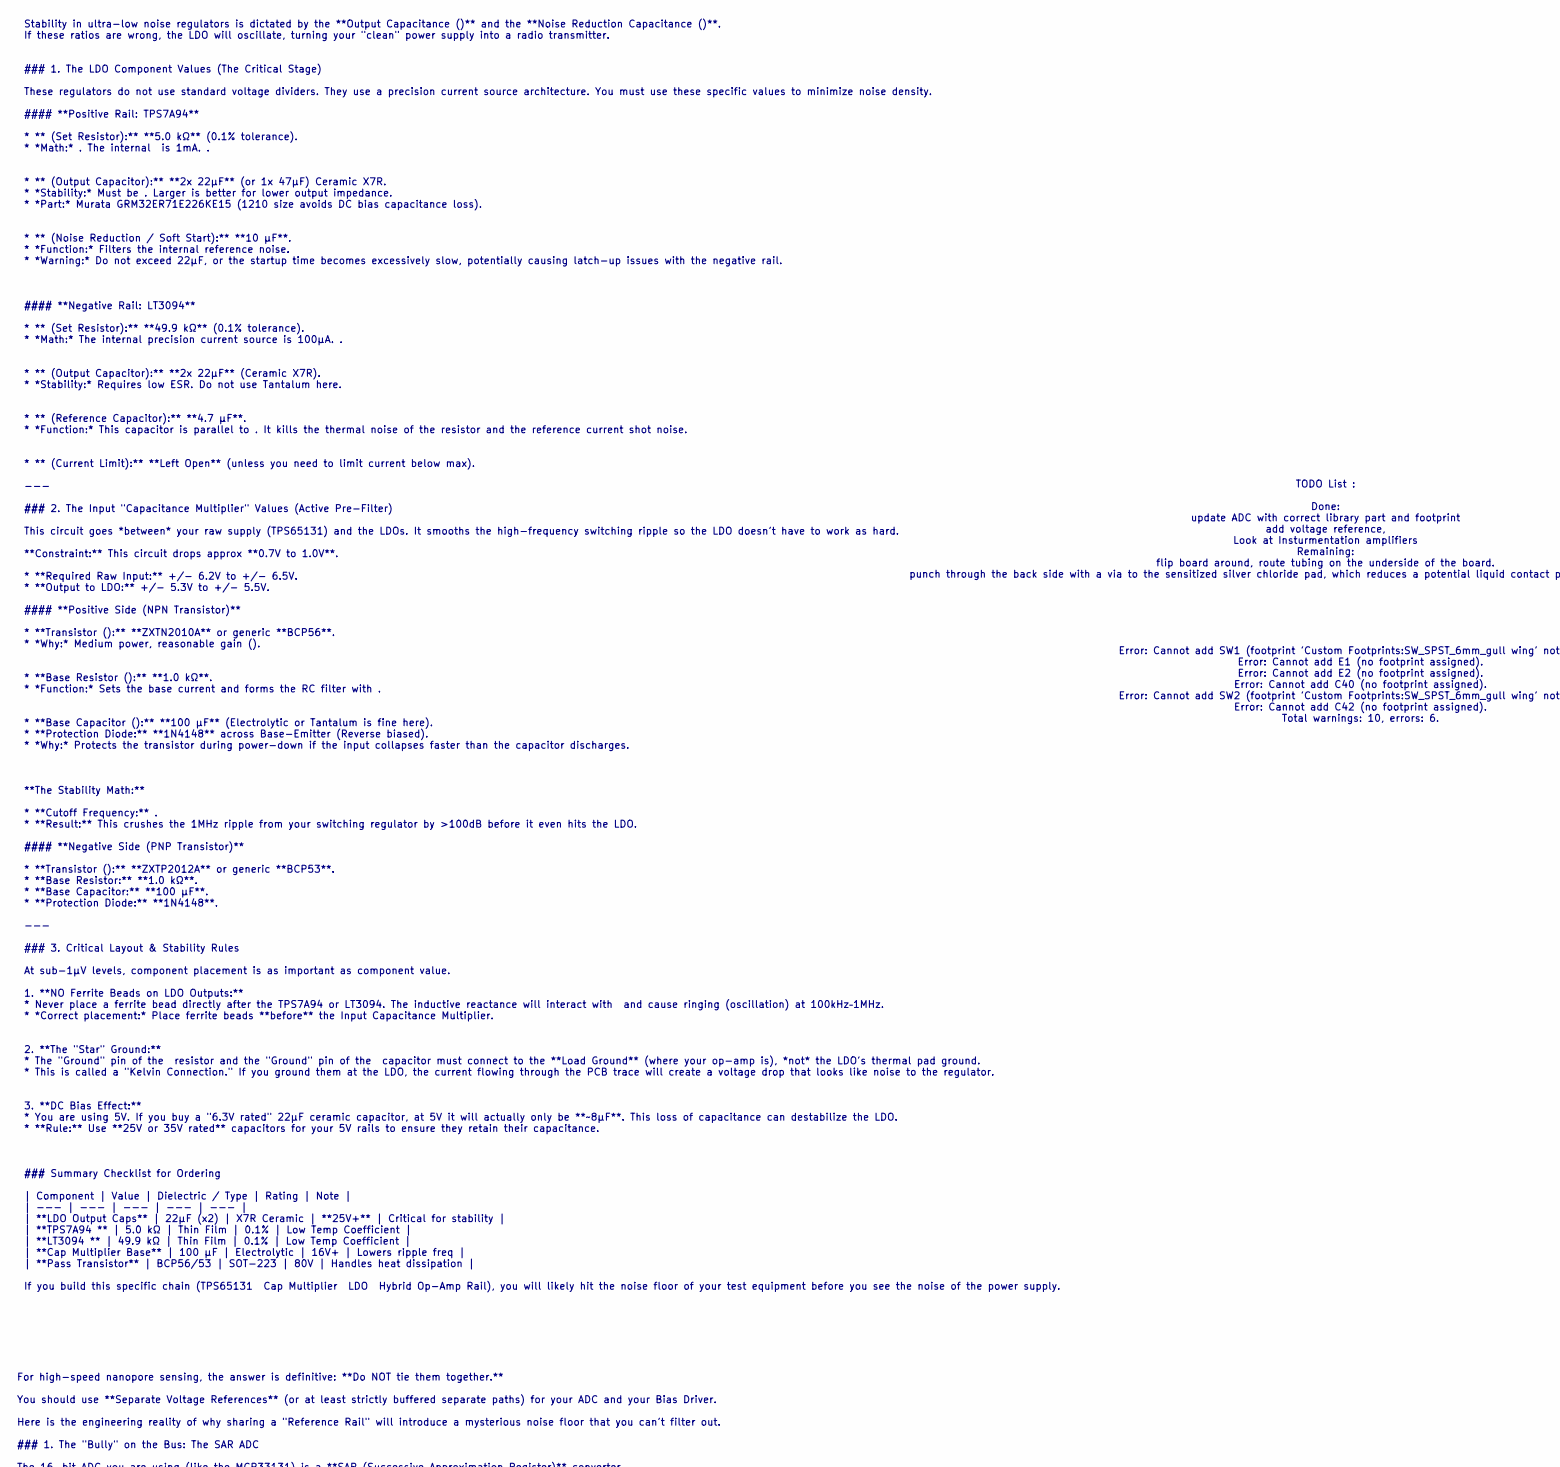
[picture p11: schematic MR1.kicad_sch, part in row 1, column 1]

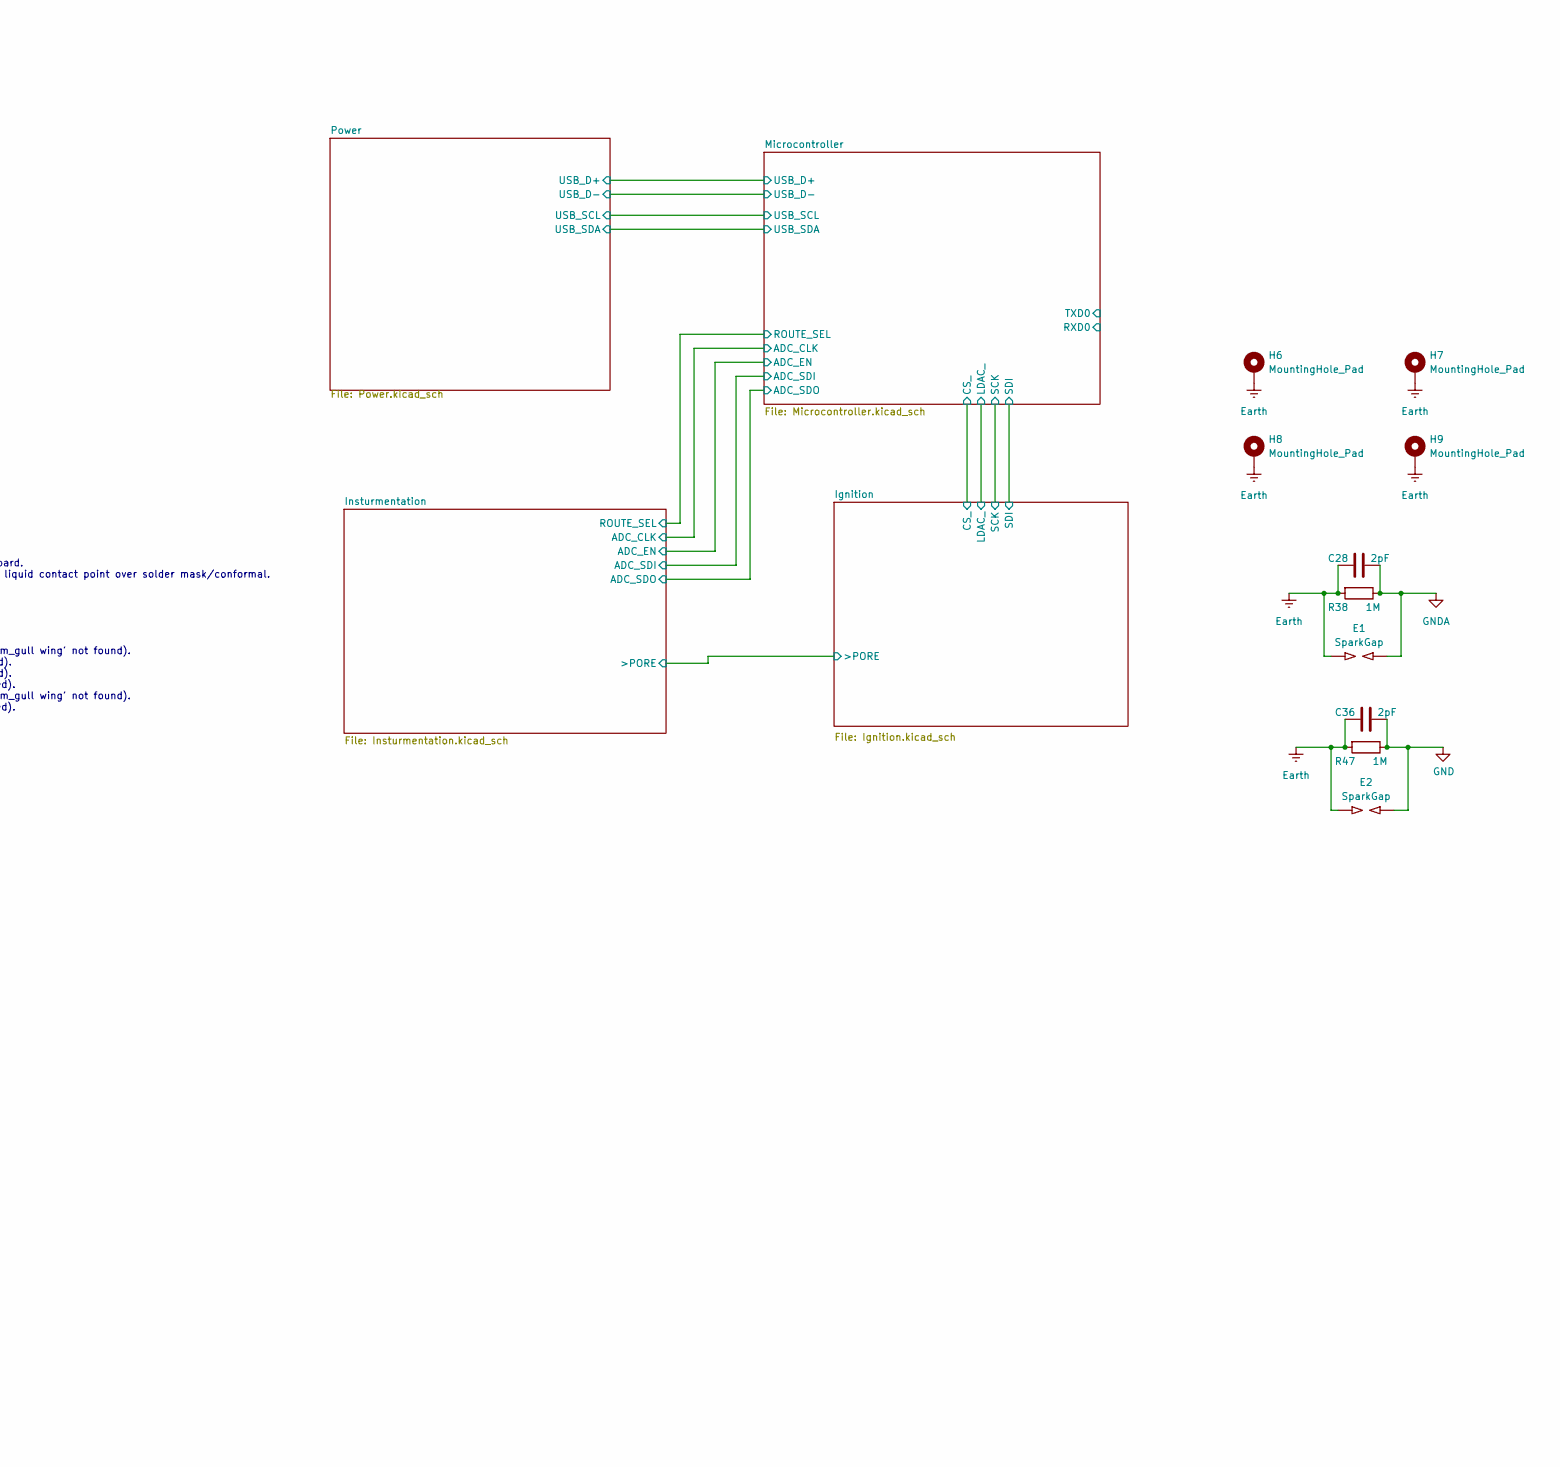
[picture p12: schematic MR1.kicad_sch, part in row 1, column 2]

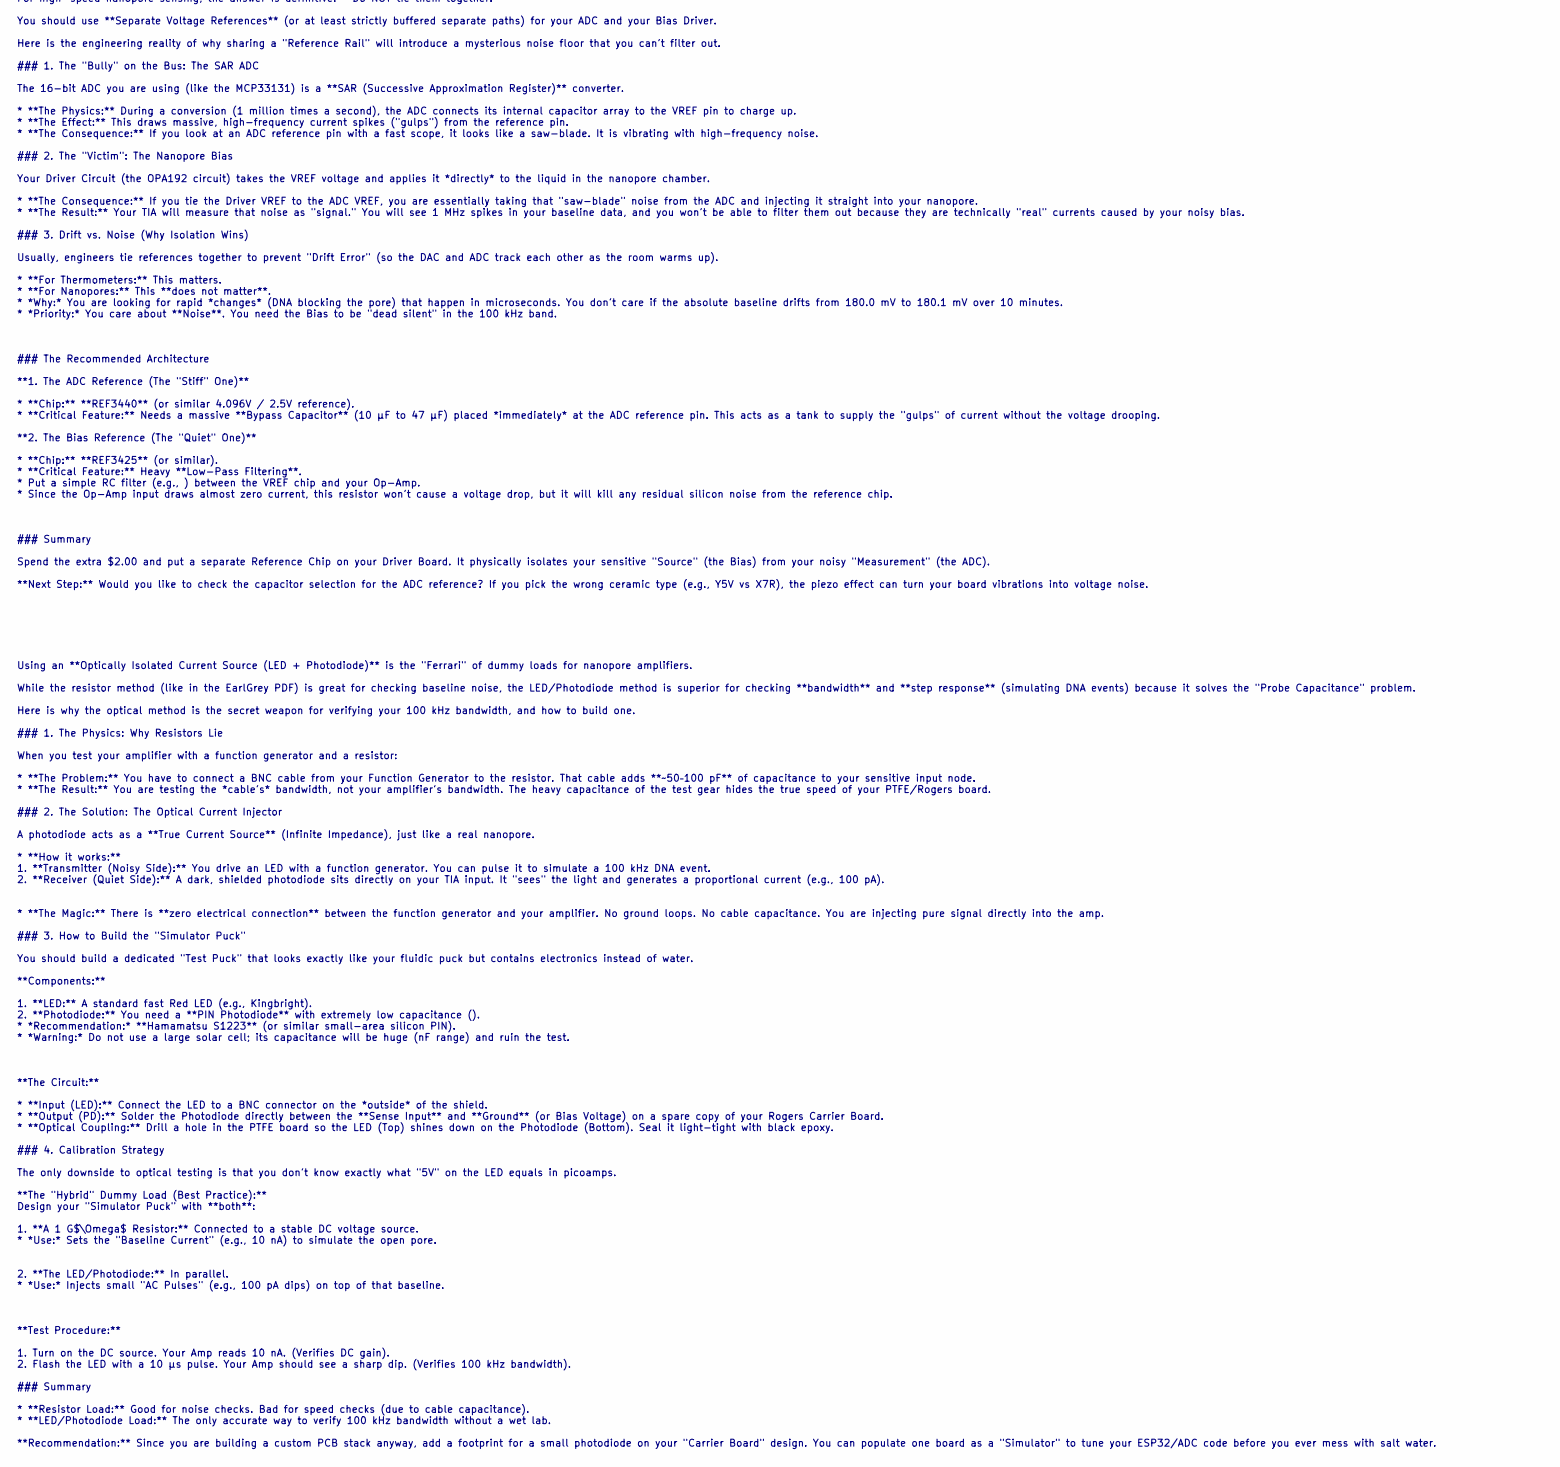
[picture p13: schematic MR1.kicad_sch, part in row 2, column 1]

Parts:
C28, C36: 2pF; C_0402_1005Metric; LCSC C161316
E1, E2: SparkGap; SolderJumper-2_P1.3mm_Open_TrianglePad1.0x1.5mm
H6, H7, H8, H9: MountingHole_Pad; MountingHole_3.2mm_M3_Pad_Via
R38, R47: 1M; R_0402_1005Metric; LCSC C25488

Connections:
Earth: C28.2, C36.2, E1.1, E2.1, H6.1 (1_1), H7.1 (1_1), H8.1 (1_1), H9.1 (1_1), R38.2, R47.2; also elsewhere on the board
GND: C36.1, E2.2, R47.1; also elsewhere on the board
GNDA: C28.1, E1.2, R38.1; also elsewhere on the board

Notes on the sheet:
Stability in ultra-low noise regulators is dictated by the **Output Capacitance ()** and the **Noise Reduction Capacitance ()**. If these ratios are wrong, the LDO will oscillate, turning your "clean" power supply into a radio transmitter. ### 1. The LDO Component Values (The Critical Stage) These 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
For high-speed nanopore sensing, the answer is definitive: **Do NOT tie them together.** You should use **Separate Voltage References** (or at least strictly buffered separate paths) for your ADC and your Bias Driver. Here is the engineering reality of why sharing a "Reference Rail" will introduce 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
TODO List : Done: update ADC with correct library part and footprint add voltage reference, Look at Insturmentation amplifiers Remaining: flip board around, route tubing on the underside of the board. punch through the back side with a via to the sensitized silver chloride pad, which reduces a pote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
Using an **Optically Isolated Current Source (LED + Photodiode)** is the "Ferrari" of dummy loads for nanopore amplifiers. While the resistor method (like in the EarlGrey PDF) is great for checking baseline noise, the LED/Photodiode method is superior for checking **bandwidth** and **step response*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
Error: Cannot add SW1 (footprint 'Custom Footprints:SW_SPST_6mm_gull wing' not found). Error: Cannot add E1 (no footprint assigned). Error: Cannot add E2 (no footprint assigned). Error: Cannot add C40 (no footprint assigned). Error: Cannot add SW2 (footprint 'Custom Footprints:SW_SPST_6mm_gull wing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

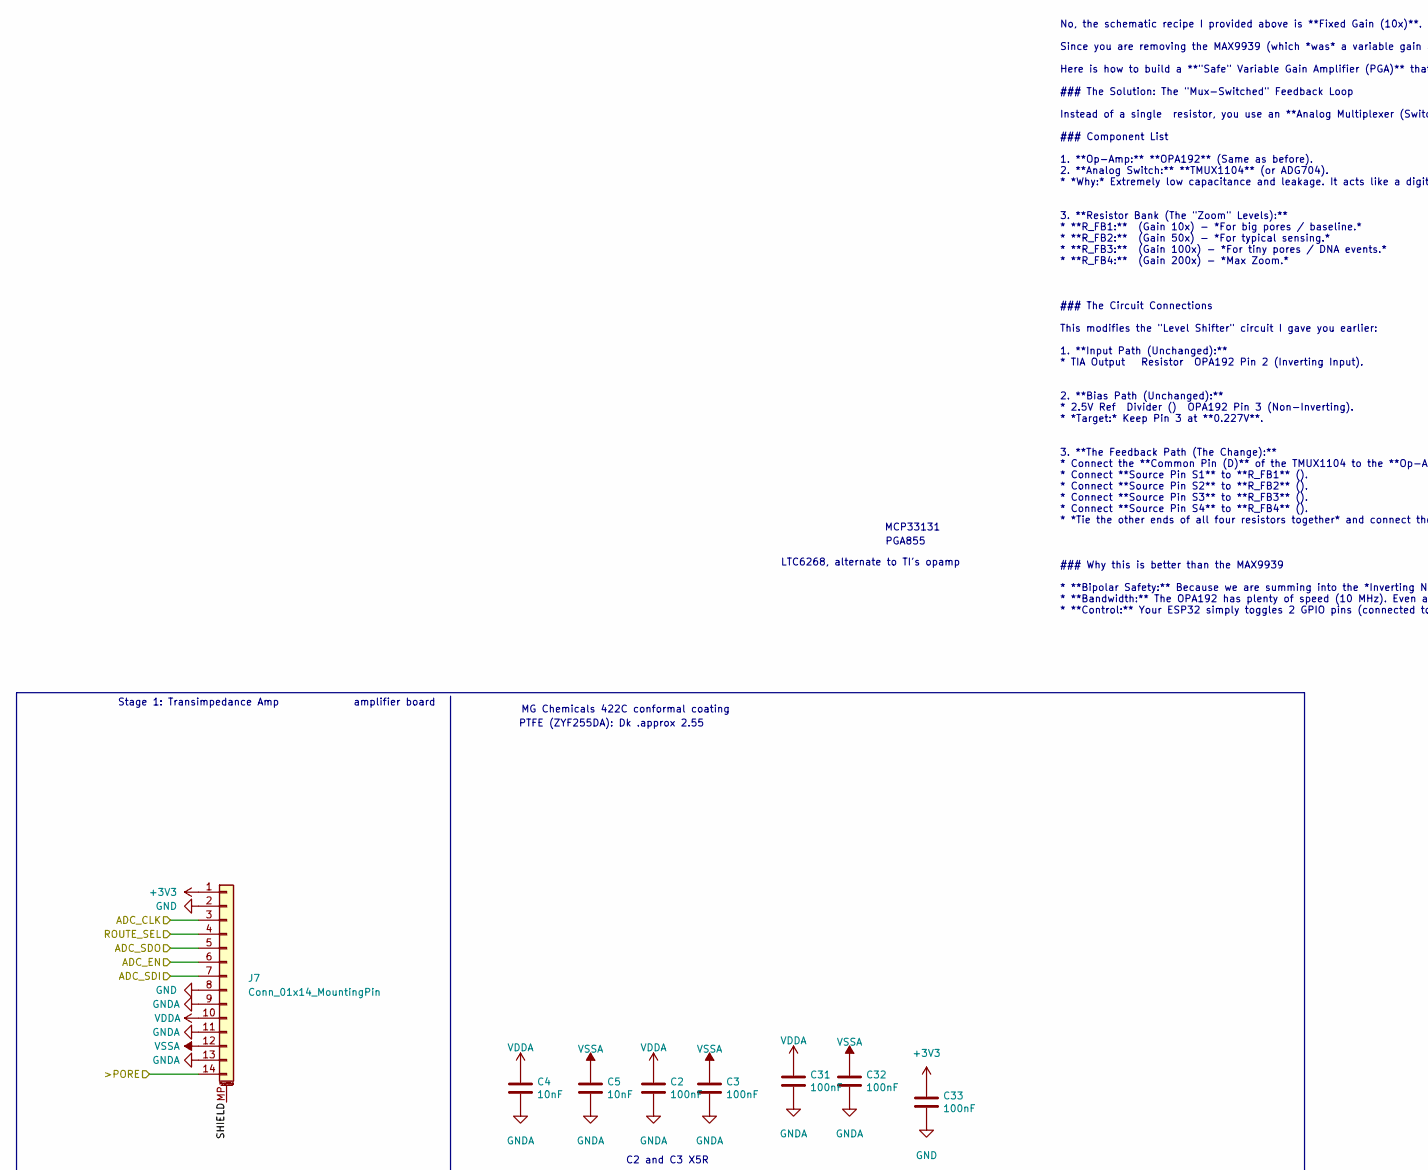
[picture p14: schematic Insturmentation.kicad_sch, part in row 1, column 1]

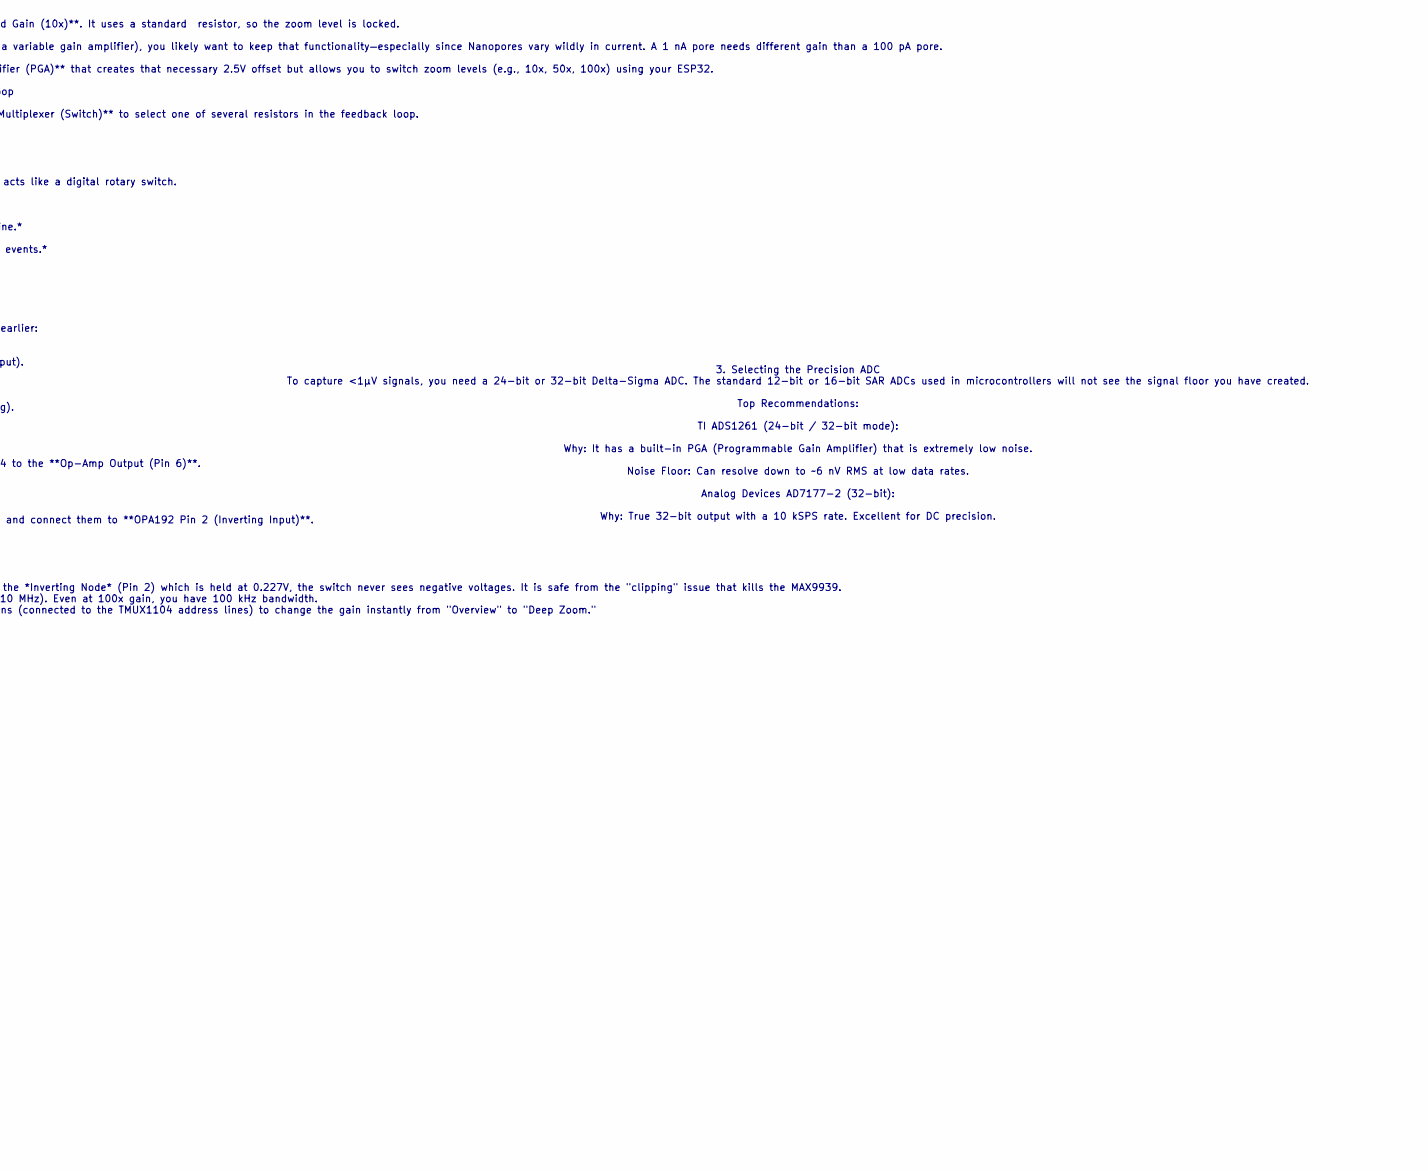
[picture p15: schematic Insturmentation.kicad_sch, part in row 1, column 2]

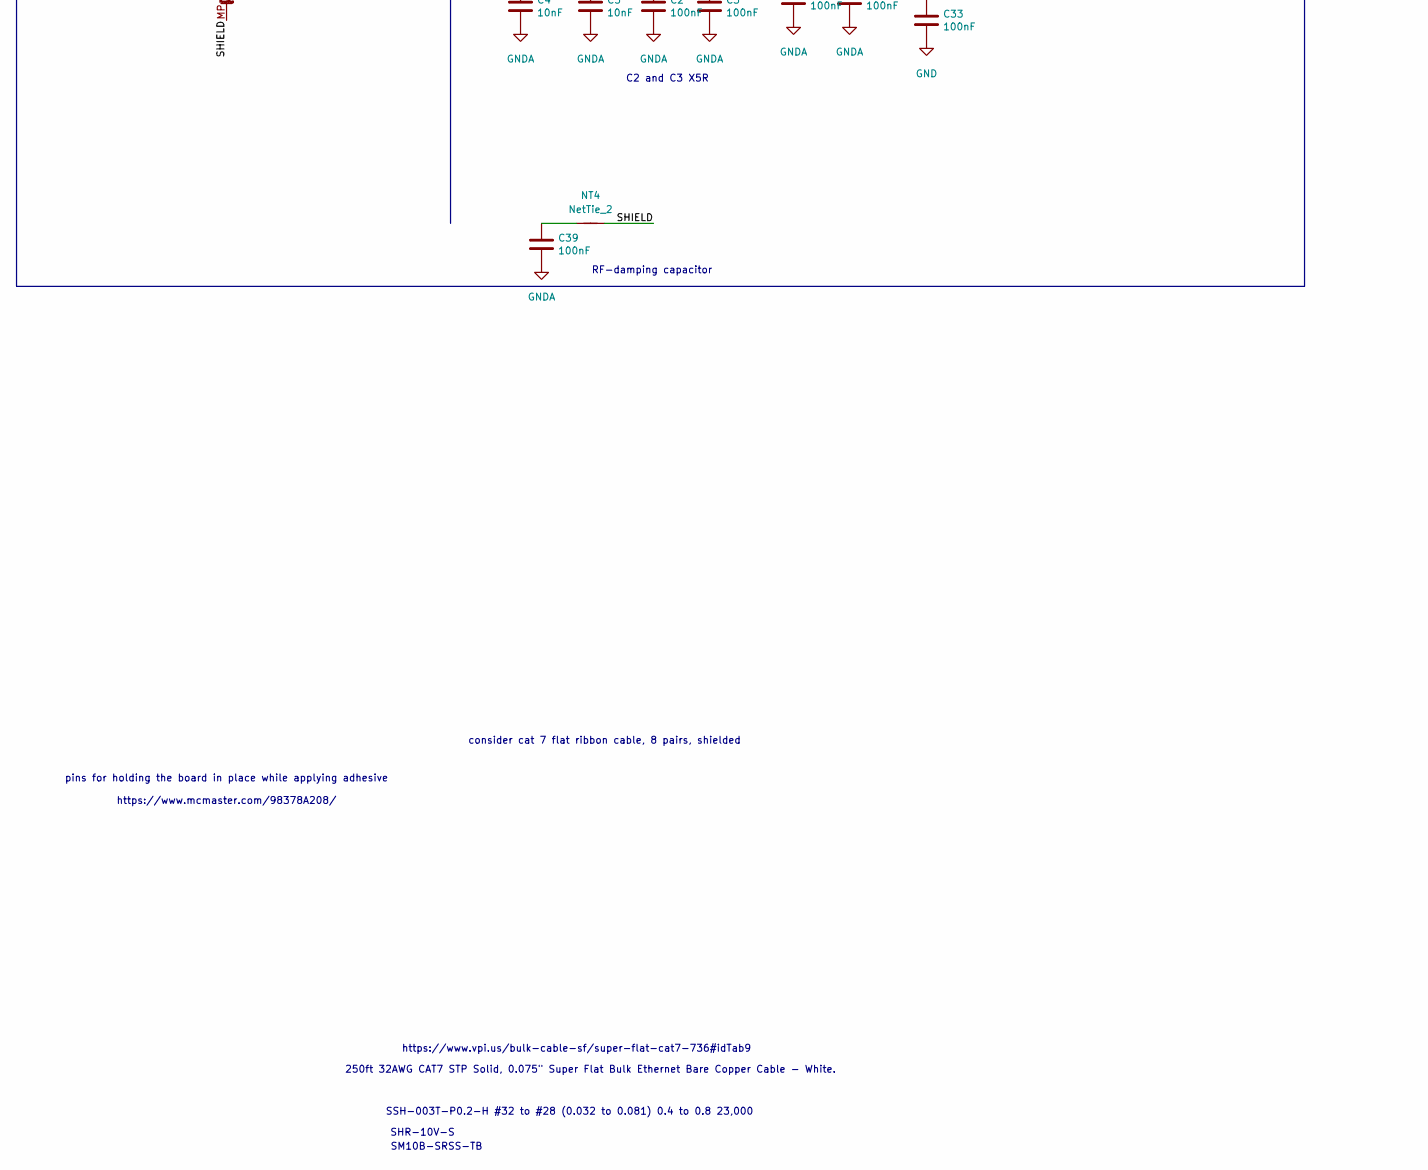
[picture p16: schematic Insturmentation.kicad_sch, part in row 2, column 1]

Parts:
C2, C3, C31, C32, C33, C39: 100nF; C_0402_1005Metric; LCSC C15255
C4, C5: 10nF; C_0402_1005Metric; LCSC C1525
J7: Conn_01x14_MountingPin; Amphenol_F32R-1A7x1-11014_1x14-1MP_P0.5mm_Horizontal; LCSC C2856818
NT4: NetTie_2; NetTie-2_SMD_Pad0.5mm

Connections:
+3V3: C33.1, J7.1; also elsewhere on the board
/Ignition/>PORE: J7.14; also elsewhere on the board
/Insturmentation/ADC_CLK: J7.3; also elsewhere on the board
/Insturmentation/ADC_EN: J7.6; also elsewhere on the board
/Insturmentation/ADC_SDI: J7.7; also elsewhere on the board
/Insturmentation/ADC_SDO: J7.5; also elsewhere on the board
/Insturmentation/ROUTE_SEL: J7.4; also elsewhere on the board
/Insturmentation/SHIELD: J7.MP (MountPin), NT4.2
GND: C33.2, J7.2, J7.8; also elsewhere on the board
GNDA: C2.2, C3.2, C4.2, C5.2, C31.2, C32.2, C39.2, J7.9, J7.11, J7.13; also elsewhere on the board
unnamed: C39.1, NT4.1
VDDA: C2.1, C4.1, C31.1, J7.10; also elsewhere on the board
VSSA: C3.1, C5.1, C32.1, J7.12; also elsewhere on the board

Notes on the sheet:
consider cat 7 flat ribbon cable, 8 pairs, shielded
pins for holding the board in place while applying adhesive https://www.mcmaster.com/98378A208/
C2 and C3 X5R
PGA855
https://www.vpi.us/bulk-cable-sf/super-flat-cat7-736#idTab9
SM10B-SRSS-TB
PTFE (ZYF255DA): Dk .approx 2.55
amplifier board
No, the schematic recipe I provided above is **Fixed Gain (10x)**. It uses a standard resistor, so the zoom level is locked. Since you are removing the MAX9939 (which *was* a variable gain amplifier), you likely want to keep that functionality—especially since Nanopores vary wildly in current. A 1 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
Stage 1: Transimpedance Amp
MCP33131
MG Chemicals 422C conformal coating
250ft 32AWG CAT7 STP Solid, 0.075" Super Flat Bulk Ethernet Bare Copper Cable - White.
SHR-10V-S
LTC6268, alternate to TI's opamp
RF-damping capacitor
SSH-003T-P0.2-H #32 to #28 (0.032 to 0.081) 0.4 to 0.8 23,000
3. Selecting the Precision ADC To capture <1µV signals, you need a 24-bit or 32-bit Delta-Sigma ADC. The standard 12-bit or 16-bit SAR ADCs used in microcontrollers will not see the signal floor you have created. Top Recommendations: TI ADS1261 (24-bit / 32-bit mode): Why: It has a built-in PGA (Pr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
