EpicQuestBio/MR1/MR1/MR1.kicad_pcb

## KiCad design MR1/MR1.kicad_pcb (continued)

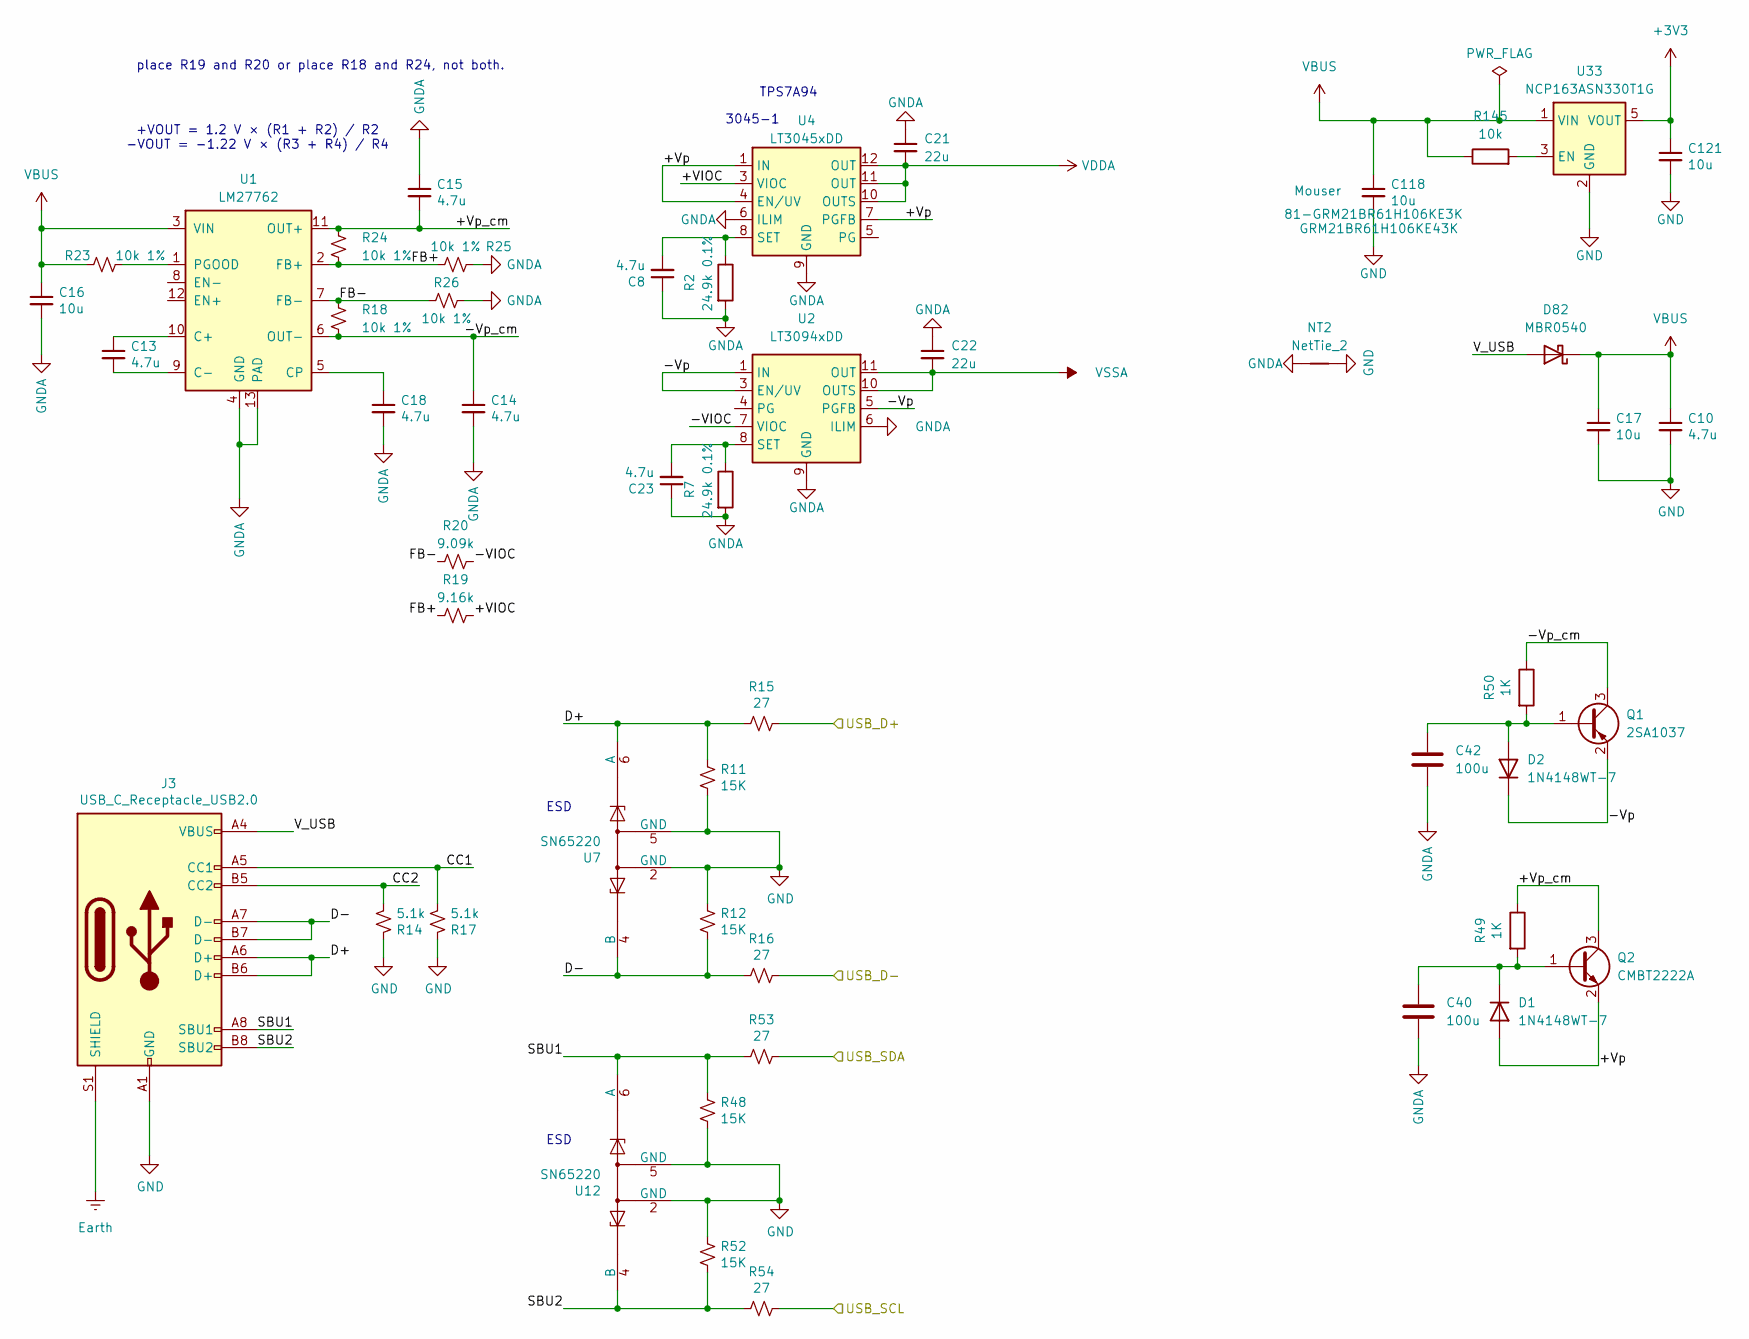
[picture p17: schematic Power.kicad_sch]

Parts:
C8, C10, C13, C14, C15, C18, C23: 4.7u; C_0402_1005Metric; Manufacturer_Part_Number JMK107C6475KA-T; LCSC C19702
C16, C17: 10u; C_0402_1005Metric; Manufacturer_Part_Number LMK212ABJ106MG-T; LCSC C1713
C21, C22: 22u; C_0402_1005Metric; MPN GRM21BR61H106KE43K; LCSC C23737
C40, C42: 100u; C_1206_3216Metric; LCSC C15008
C118, C121: 10u; C_0402_1005Metric; MPN GRM21BR61H106KE43K; LCSC C1713
D1, D2: 1N4148WT-7; D_SOD-523; LCSC C107849
D82: MBR0540; D_SOD-123; MPN MBR0540L-TP; LCSC C5204747
J3: USB_C_Receptacle_USB2.0; USB_C_Receptacle_HRO_TYPE-C-31-M-12; Manufacturer_Part_Number USB4105-GF-A; LCSC C165948
NT2: NetTie_2; NetTie-2_SMD_Pad0.5mm
Q1: 2SA1037; SOT-23; LCSC C14902
Q2: CMBT2222A; SOT-23; LCSC C2152
R2, R7: 24.9k 0.1%; R_0402_1005Metric; LCSC C25327
R11, R12, R48, R52: 15K; R_0402_1005Metric; Manufacturer_Part_Number RC0603FR-1315KL; LCSC C25275
R14, R17: 5.1k; R_0402_1005Metric; Manufacturer_Part_Number CR0603-FX-5101ELF; LCSC C25212
R15, R16, R53, R54: 27; R_0402_1005Metric; Manufacturer_Part_Number RK73B1JTTDD270J; LCSC C25078
R18, R23, R24, R25, R26: 10k 1%; R_0402_1005Metric; MPN RK73H1ETTPB1002F; LCSC C60490
R19: 9.16k; R_0402_1005Metric; MPN RK73H1ETTPB1002F; LCSC C25991
R20: 9.09k; R_0402_1005Metric; MPN RK73H1ETTPB1002F; LCSC C25879
R49, R50: 1K; R_0402_1005Metric; LCSC C25149
R145: 10k; R_0402_1005Metric; MPN RK73H1ETTPB1002F; LCSC C60490
U1: LM27762; WSON-12-1EP_3x2mm_P0.5mm_EP1x2.65_ThermalVias; MPN LM27762DSSR; LCSC C473398
U2: LT3094xDD; DFN-12-1EP_3x3mm_P0.45mm_EP1.65x2.38mm_ThermalVias; LCSC C670493
U4: LT3045xDD; DFN-12-1EP_3x3mm_P0.5mm_EP1.6x2.5mm; MPN LT3045EDD-1#TRPBF; LCSC C514420
U7, U12: SN65220; SOT-23-6; Manufacturer_Part_Number SN65220DBVT; LCSC C21787
U33: NCP163ASN330T1G; SOT-23-5; MPN NCP114ASN330T1G; LCSC C156285

Connections:
+3V3: C121.1, U33.5 (VOUT); also elsewhere on the board
/Microcontroller/GPIO19: R16.2; also elsewhere on the board
/Microcontroller/GPIO20: R15.2; also elsewhere on the board
/Microcontroller/GPIO21: R53.2; also elsewhere on the board
/Microcontroller/GPIO26: R54.2; also elsewhere on the board
/Power/+VIOC: R19.1, U4.3 (VIOC)
/Power/+Vp: D1.2 (A), Q2.2 (E), U4.1 (IN), U4.2 (IN), U4.4 (EN/UV), U4.7 (PGFB)
/Power/+Vp_cm: C15.2, Q2.3 (C), R24.2, R49.1, U1.11 (OUT+)
/Power/-VIOC: R20.1, U2.7 (VIOC)
/Power/-Vp: D2.1 (K), Q1.2 (E), U2.1 (IN), U2.2 (IN), U2.3 (EN/UV), U2.5 (PGFB), U2.13 (IN)
/Power/-Vp_cm: C14.1, Q1.3 (C), R18.1, R50.1, U1.6 (OUT-)
/Power/CC1: J3.A5 (CC1), R17.2
/Power/CC2: J3.B5 (CC2), R14.2
/Power/D+: J3.A6 (D+), J3.B6 (D+), R11.1, R15.1, U7.1, U7.6 (A)
/Power/D-: J3.A7 (D-), J3.B7 (D-), R12.2, R16.1, U7.3, U7.4 (B)
/Power/FB+: R19.2, R24.1, R25.2, U1.2 (FB+)
/Power/FB-: R18.2, R20.2, R26.1, U1.7 (FB-)
/Power/SBU1: J3.A8 (SBU1), R48.1, R53.1, U12.1, U12.6 (A)
/Power/SBU2: J3.B8 (SBU2), R52.2, R54.1, U12.3, U12.4 (B)
/Power/V_USB: D82.2 (A), J3.A4 (VBUS), J3.A9 (VBUS), J3.B4 (VBUS), J3.B9 (VBUS)
Earth: J3.S1 (SHIELD); also elsewhere on the board
GND: C10.2, C17.2, C118.2, C121.2, J3.A1 (GND), J3.A12 (GND), J3.B1 (GND), J3.B12 (GND), NT2.2, R11.2, R12.1, R14.1, R17.1, R48.2, R52.1, U7.2 (GND), U7.5 (GND), U12.2 (GND), U12.5 (GND), U33.2 (GND); also elsewhere on the board
GNDA: C8.1, C14.2, C15.1, C16.2, C18.2, C21.1, C22.1, C23.1, C40.2, C42.1, NT2.1, R2.2, R7.2, R25.1, R26.2, U1.4 (GND), U1.13 (PAD), U2.6 (ILIM), U2.9 (GND), U4.6 (ILIM), U4.9 (GND), U4.13 (GND); also elsewhere on the board
unnamed: C40.1, D1.1 (K), Q2.1 (B), R49.2
unnamed: C42.2, D2.2 (A), Q1.1 (B), R50.2
unnamed: C13.1, U1.10 (C+)
unnamed: C13.2, U1.9 (C-)
unnamed: C18.1, U1.5 (CP)
unnamed: R23.2, U1.1 (PGOOD)
unnamed: C23.2, R7.1, U2.8 (SET)
unnamed: C8.2, R2.1, U4.8 (SET)
unnamed: R145.2, U33.3 (EN)
VBUS: C10.1, C16.1, C17.1, C118.1, D82.1 (K), R23.1, R145.1, U1.3 (VIN), U33.1 (VIN)
VDDA: C21.2, U4.10 (OUTS), U4.11 (OUT), U4.12 (OUT); also elsewhere on the board
VSSA: C22.2, U2.10 (OUTS), U2.11 (OUT), U2.12 (OUT); also elsewhere on the board

Notes on the sheet:
ESD
+VOUT = 1.2 V × (R1 + R2) / R2 -VOUT = -1.22 V × (R3 + R4) / R4
3045-1
TPS7A94
place R19 and R20 or place R18 and R24, not both.

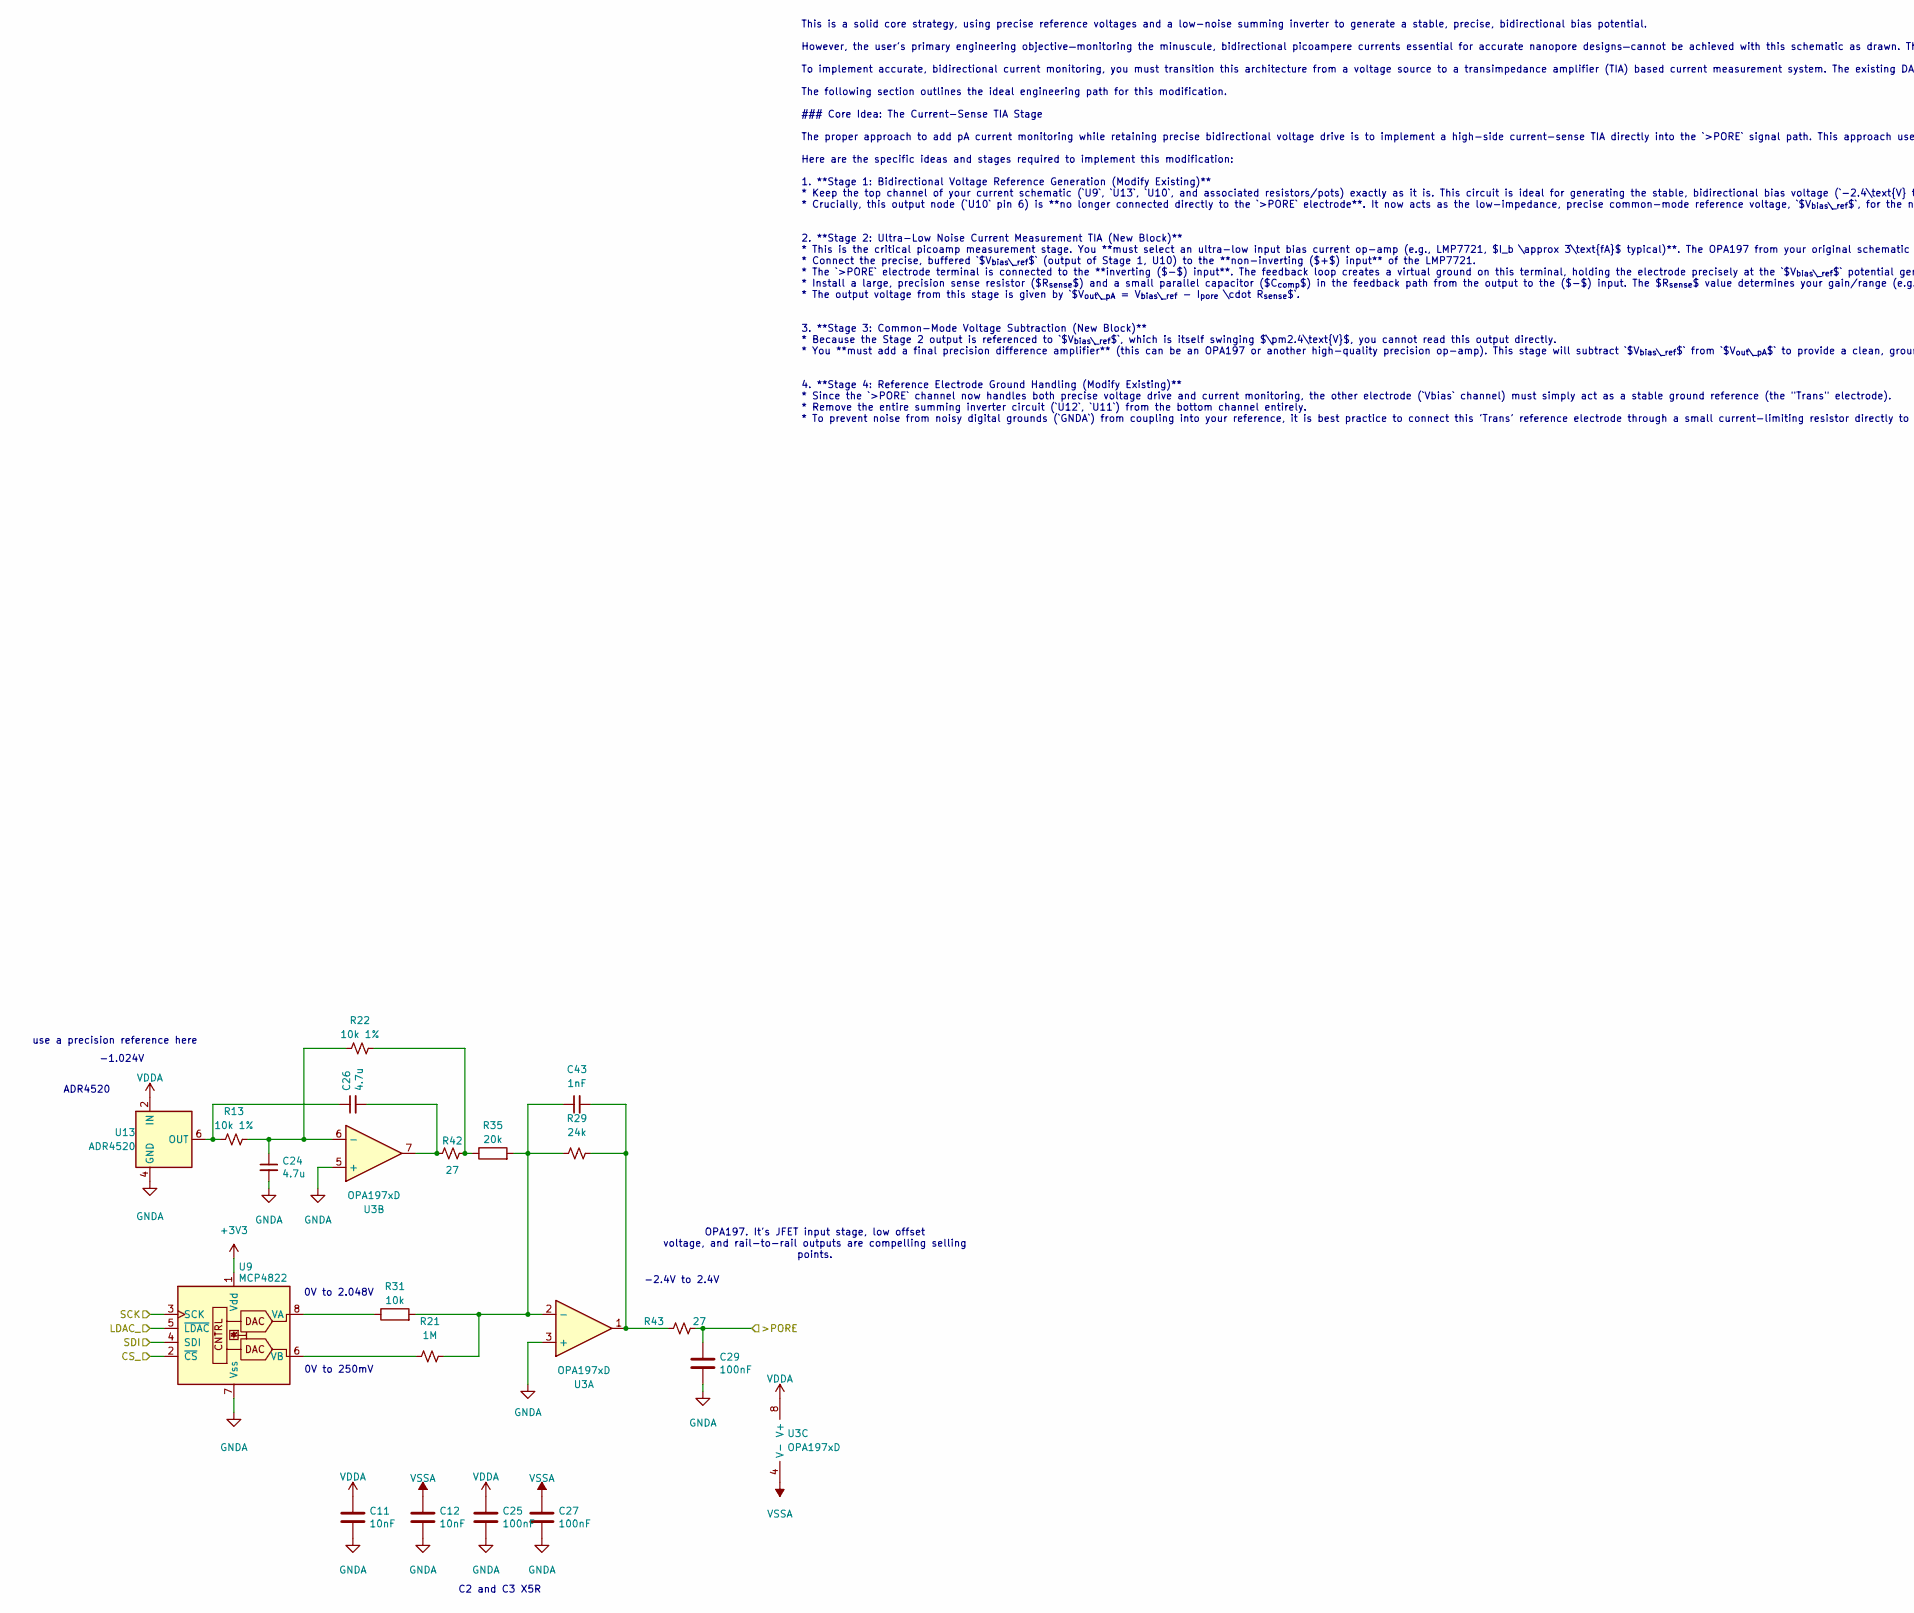
[picture p18: schematic Ignition.kicad_sch, part in row 1, column 1]

Parts:
C11, C12: 10nF; C_0402_1005Metric; LCSC C1525
C24, C26: 4.7u; C_0402_1005Metric; Manufacturer_Part_Number JMK107C6475KA-T; LCSC C19702
C25, C27, C29: 100nF; C_0402_1005Metric; LCSC C15255
C43: 1nF; C_0402_1005Metric; LCSC C1523
R13, R22: 10k 1%; R_0402_1005Metric; MPN RK73H1ETTPB1002F; LCSC C60490
R21: 1M; R_0402_1005Metric; MPN RK73H1ETTPB1002F; LCSC C25488
R29: 24k; R_0402_1005Metric; MPN RK73H1ETTPB1002F; LCSC C25324
R31: 10k; R_0402_1005Metric; LCSC C60490
R35: 20k; R_0402_1005Metric; LCSC C25310
R42, R43: 27; R_0402_1005Metric; MPN RC0402JR-0727RL; LCSC C25078
U3: OPA197xD; VSSOP-8_3x3mm_P0.65mm; MPN OPA197IDGKT; LCSC C133554
U9: MCP4822; SOIC-8-1EP_3.9x4.9mm_P1.27mm_EP2.29x3mm; MPN MCP4822T-E/SN; LCSC C16040
U13: ADR4520; SOIC-8_3.9x4.9mm_P1.27mm; MPN ADR4520ARZ-R7; LCSC C659578

Connections:
+3V3: U9.1 (Vdd); also elsewhere on the board
/Ignition/>PORE: C29.1, R43.2; also elsewhere on the board
/Ignition/CS_: U9.2 (~CS); also elsewhere on the board
/Ignition/LDAC_: U9.5 (~LDAC); also elsewhere on the board
/Ignition/SCK: U9.3 (SCK); also elsewhere on the board
/Ignition/SDI: U9.4 (SDI); also elsewhere on the board
GNDA: C11.2, C12.2, C24.2, C25.2, C27.2, C29.2, U3.3 (+), U3.5 (+), U9.7 (Vss), U13.4 (GND); also elsewhere on the board
unnamed: C26.2, R42.1, U3.7
unnamed: C43.2, R29.1, R43.1, U3.1
unnamed: R22.1, R35.1, R42.2
unnamed: C43.1, R21.1, R29.2, R31.2, R35.2, U3.2 (-)
unnamed: C24.1, R13.1, R22.2, U3.6 (-)
unnamed: R31.1, U9.8 (VA)
unnamed: R21.2, U9.6 (VB)
unnamed: C26.1, R13.2, U13.6 (OUT)
VDDA: C11.1, C25.1, U3.8 (V+), U13.2 (IN); also elsewhere on the board
VSSA: C12.1, C27.1, U3.4 (V-); also elsewhere on the board

Notes on the sheet:
use a precision reference here
This is a solid core strategy, using precise reference voltages and a low-noise summing inverter to generate a stable, precise, bidirectional bias potential. However, the user's primary engineering objective—monitoring the minuscule, bidirectional picoampere currents essential for accurate nanopore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
0V to 250mV
C2 and C3 X5R
-2.4V to 2.4V
OPA197. It's JFET input stage, low offset voltage, and rail-to-rail outputs are compelling selling points.
ADR4520
0V to 2.048V
-1.024V

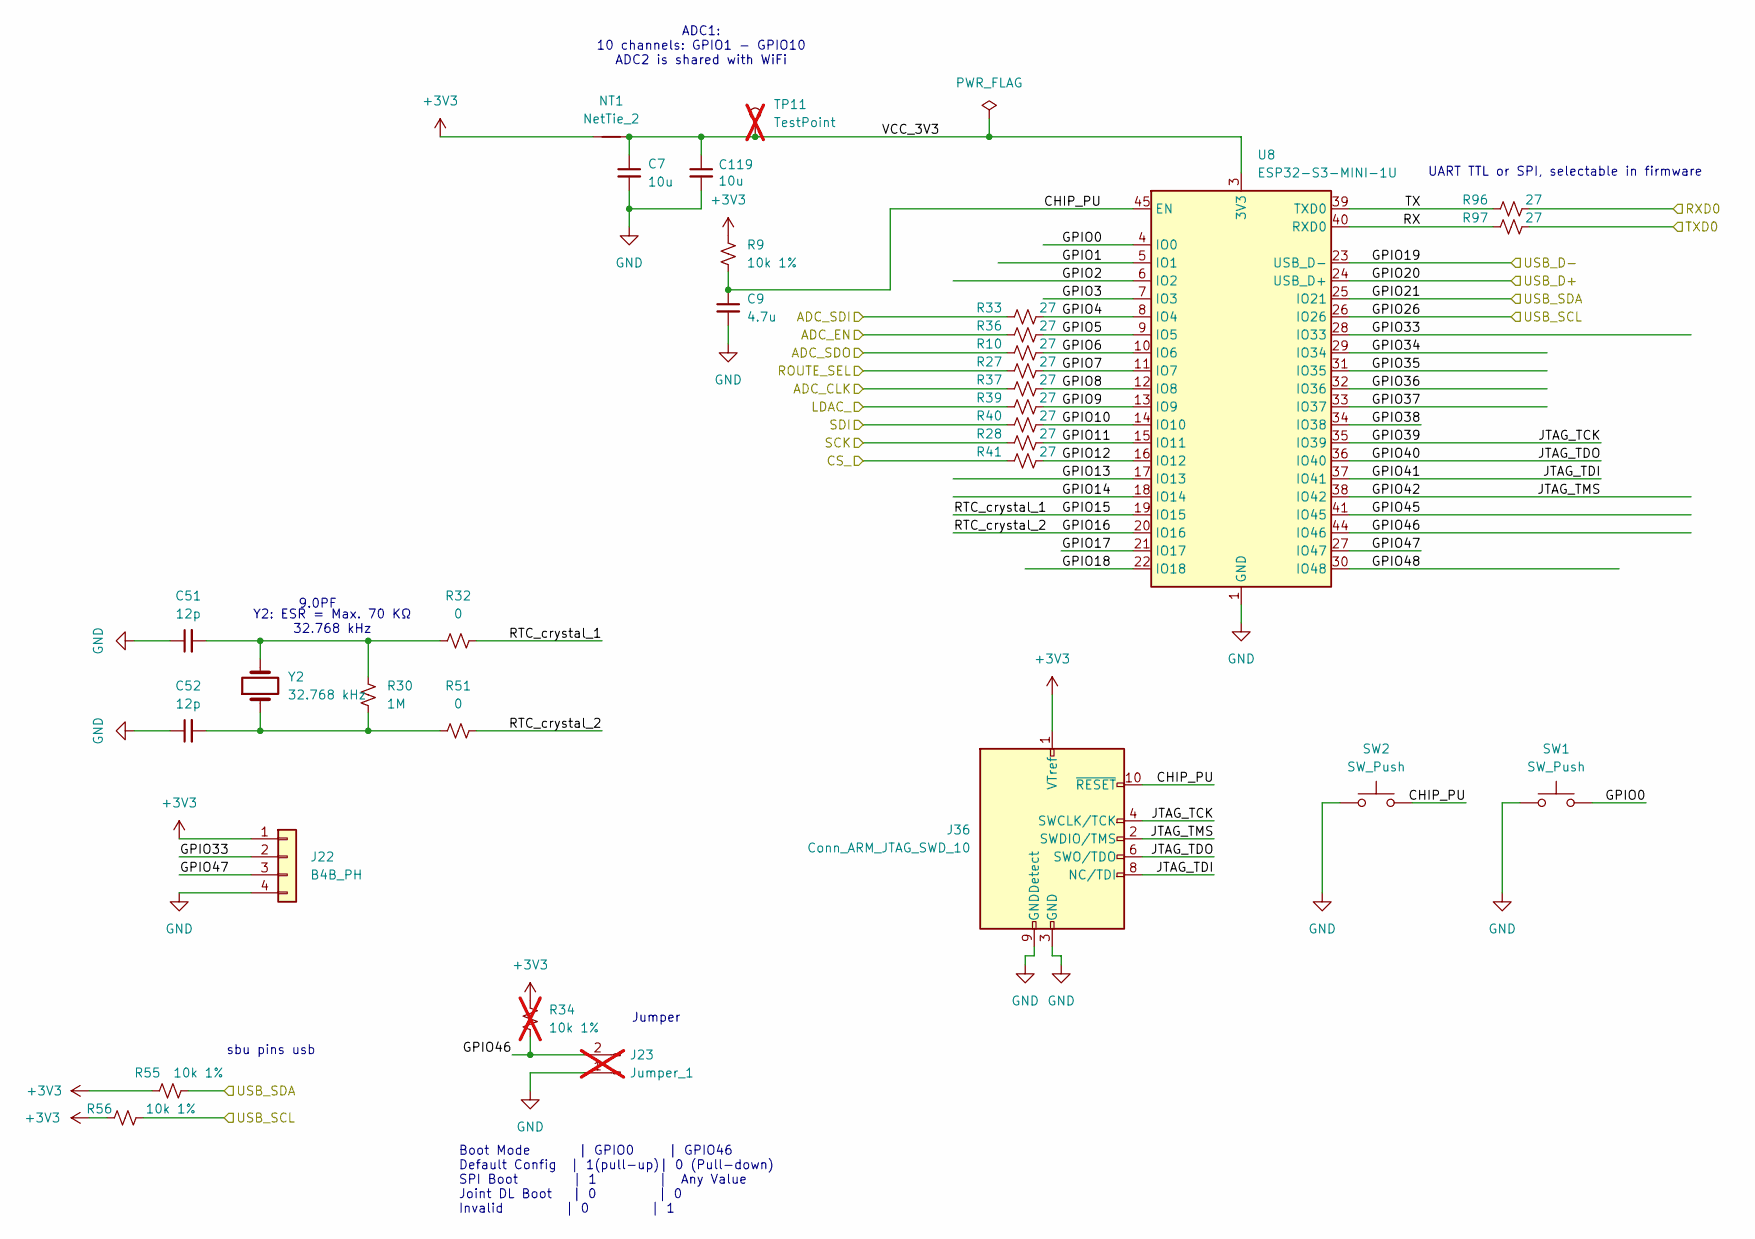
[picture p19: schematic Microcontroller.kicad_sch]

Parts:
C7, C119: 10u; C_0402_1005Metric; MPN GRM21BR61H106KE43K; LCSC C1713
C9: 4.7u; C_0402_1005Metric; MPN LMK107BJ475KA-T; LCSC C19702
C51, C52: 12p; C_0402_1005Metric; MPN 0402YA120JAT2A; LCSC C1550
J22: B4B_PH; JST_PH_B4B-PH-K_1x04_P2.00mm_Vertical; MPN B4B-PH-K-S; LCSC C131334
J23: Jumper_1; PinHeader_1x02_P2.54mm_Vertical; LCSC C492401; not fitted
J36: Conn_ARM_JTAG_SWD_10; PinHeader_2x05_P1.27mm_Vertical_SMD; MPN FTSH-105-01-F-DV-007-P-TR; LCSC C521634
NT1: NetTie_2; NetTie-2_SMD_Pad0.5mm
R9, R55, R56: 10k 1%; R_0402_1005Metric; MPN RK73H1ETTPB1002F; LCSC C60490
R10, R27, R28, R33, R36, R37, R39, R40, R41, R96, R97: 27; R_0402_1005Metric; MPN RC0402JR-0727RL; LCSC C25078
R30: 1M; R_0402_1005Metric; MPN CRCW04021M00DHEDP; LCSC C25488
R32, R51: 0; R_0402_1005Metric; MPN CRCW04020000Z0EDC; LCSC C25740
R34: 10k 1%; R_0402_1005Metric; MPN RK73H1ETTPB1002F; LCSC C60490; not fitted
SW1, SW2: SW_Push; SW_SPST_6mm_gull wing; MPN TS04-66-43-BK-160-SMT; LCSC C481177
TP11: TestPoint; TestPoint_Pad_D1.0mm; not fitted
U8: ESP32-S3-MINI-1U; ESP32-S2-MINI-1U; MPN ESP32-S3-MINI-1U-N8; LCSC C2980299
Y2: 32.768 kHz; Crystal_SMD_3215-2Pin_3.2x1.5mm; MPN FC3215AN 32.768K-90NN60KC5; LCSC C91275

Connections:
+3V3: J22.1, J36.1 (VTref), NT1.1, R9.1, R34.1, R55.1, R56.2; also elsewhere on the board
/Ignition/CS_: R41.1; also elsewhere on the board
/Ignition/LDAC_: R39.1; also elsewhere on the board
/Ignition/SCK: R28.1; also elsewhere on the board
/Ignition/SDI: R40.1; also elsewhere on the board
/Insturmentation/ADC_CLK: R37.1; also elsewhere on the board
/Insturmentation/ADC_EN: R36.1; also elsewhere on the board
/Insturmentation/ADC_SDI: R33.1; also elsewhere on the board
/Insturmentation/ADC_SDO: R10.1; also elsewhere on the board
/Insturmentation/ROUTE_SEL: R27.1; also elsewhere on the board
/Microcontroller/CHIP_PU: C9.1, J36.10 (~RESET), R9.2, SW2.2, U8.45 (EN)
/Microcontroller/GPIO0: SW1.2, U8.4 (IO0)
/Microcontroller/GPIO1: U8.5 (IO1)
/Microcontroller/GPIO2: U8.6 (IO2)
/Microcontroller/GPIO3: U8.7 (IO3)
/Microcontroller/GPIO4: R33.2, U8.8 (IO4)
/Microcontroller/GPIO5: R36.2, U8.9 (IO5)
/Microcontroller/GPIO6: R10.2, U8.10 (IO6)
/Microcontroller/GPIO7: R27.2, U8.11 (IO7)
/Microcontroller/GPIO8: R37.2, U8.12 (IO8)
/Microcontroller/GPIO9: R39.2, U8.13 (IO9)
/Microcontroller/GPIO10: R40.2, U8.14 (IO10)
/Microcontroller/GPIO11: R28.2, U8.15 (IO11)
/Microcontroller/GPIO12: R41.2, U8.16 (IO12)
/Microcontroller/GPIO13: U8.17 (IO13)
/Microcontroller/GPIO14: U8.18 (IO14)
/Microcontroller/GPIO15: R32.2, U8.19 (IO15)
/Microcontroller/GPIO16: R51.1, U8.20 (IO16)
/Microcontroller/GPIO17: U8.21 (IO17)
/Microcontroller/GPIO18: U8.22 (IO18)
/Microcontroller/GPIO19: U8.23 (USB_D-); also elsewhere on the board
/Microcontroller/GPIO20: U8.24 (USB_D+); also elsewhere on the board
/Microcontroller/GPIO21: R55.2, U8.25 (IO21); also elsewhere on the board
/Microcontroller/GPIO26: R56.1, U8.26 (IO26); also elsewhere on the board
/Microcontroller/GPIO33: J22.2, U8.28 (IO33)
/Microcontroller/GPIO34: U8.29 (IO34)
/Microcontroller/GPIO35: U8.31 (IO35)
/Microcontroller/GPIO36: U8.32 (IO36)
/Microcontroller/GPIO37: U8.33 (IO37)
/Microcontroller/GPIO38: U8.34 (IO38)
/Microcontroller/GPIO39: J36.4 (SWCLK/TCK), U8.35 (IO39)
/Microcontroller/GPIO40: J36.6 (SWO/TDO), U8.36 (IO40)
/Microcontroller/GPIO41: J36.8 (NC/TDI), U8.37 (IO41)
/Microcontroller/GPIO42: J36.2 (SWDIO/TMS), U8.38 (IO42)
/Microcontroller/GPIO45: U8.41 (IO45)
/Microcontroller/GPIO46: J23.2, R34.2, U8.44 (IO46)
/Microcontroller/GPIO47: J22.3, U8.27 (IO47)
/Microcontroller/GPIO48: U8.30 (IO48)
/Microcontroller/RX: R97.1, U8.40 (RXD0)
/Microcontroller/RXD0: R96.2
/Microcontroller/TX: R96.1, U8.39 (TXD0)
/Microcontroller/TXD0: R97.2
/Microcontroller/VCC_3V3: C7.1, C119.1, NT1.2, TP11.1 (1_1), U8.3 (3V3)
GND: C7.2, C9.2, C51.1, C52.1, C119.2, J22.4, J23.1, J36.3 (GND), J36.5 (GND), J36.9 (GNDDetect), SW1.1, SW2.1, U8.1 (GND), U8.2 (GND), U8.42 (GND), U8.43 (GND), U8.46 (GND), U8.47 (GND), U8.48 (GND), U8.49 (GND), U8.50 (GND), U8.51 (GND), U8.52 (GND), U8.53 (GND), U8.54 (GND), U8.55 (GND), U8.56 (GND), U8.57 (GND), U8.58 (GND), U8.59 (GND), U8.60 (GND), U8.61 (GND), U8.62 (GND), U8.63 (GND), U8.64 (GND), U8.65 (GND); also elsewhere on the board
unnamed: C51.2, R30.1, R32.1, Y2.2
unnamed: C52.2, R30.2, R51.2, Y2.1

Notes on the sheet:
Jumper
9.0PF
UART TTL or SPI, selectable in firmware
Boot Mode | GPIO0 | GPIO46 Default Config | 1(pull-up)| 0 (Pull-down) SPI Boot | 1 | Any Value Joint DL Boot | 0 | 0 Invalid | 0 | 1
Y2: ESR = Max. 70 KΩ 32.768 kHz
sbu pins usb
ADC1: 10 channels: GPIO1 - GPIO10 ADC2 is shared with WiFi

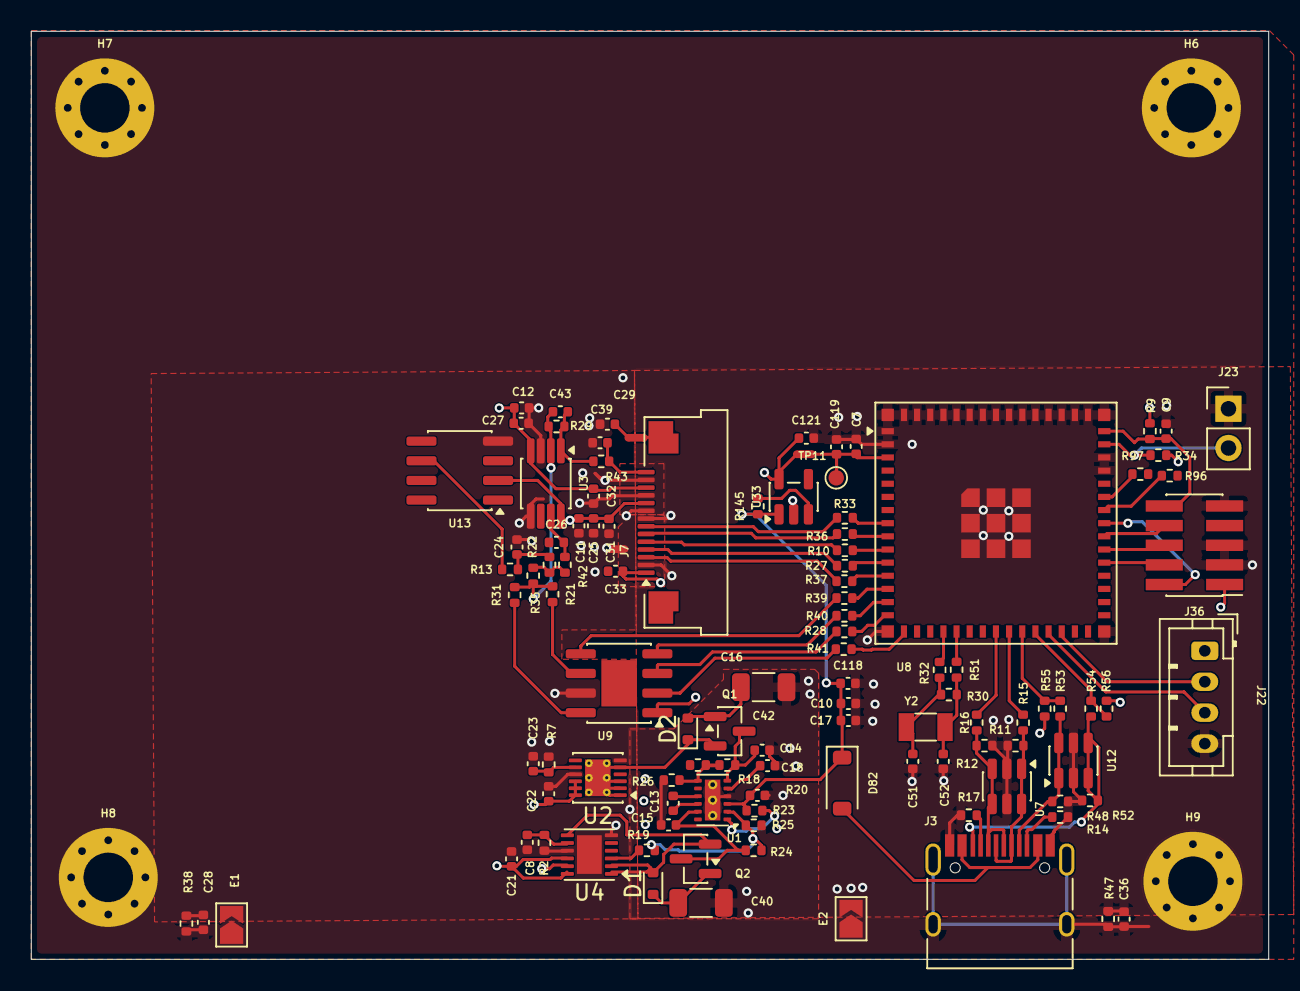
[picture p20: board MR1.kicad_pcb from above]

Board: 4 copper layers, 80.0 x 60.0 mm, 113 parts (0 on the bottom side), 79 nets.
