EpicQuestBio/MR1/Pump/Pump.kicad_pcb

## KiCad design Pump/Pump.kicad_pcb (2026-11-02)

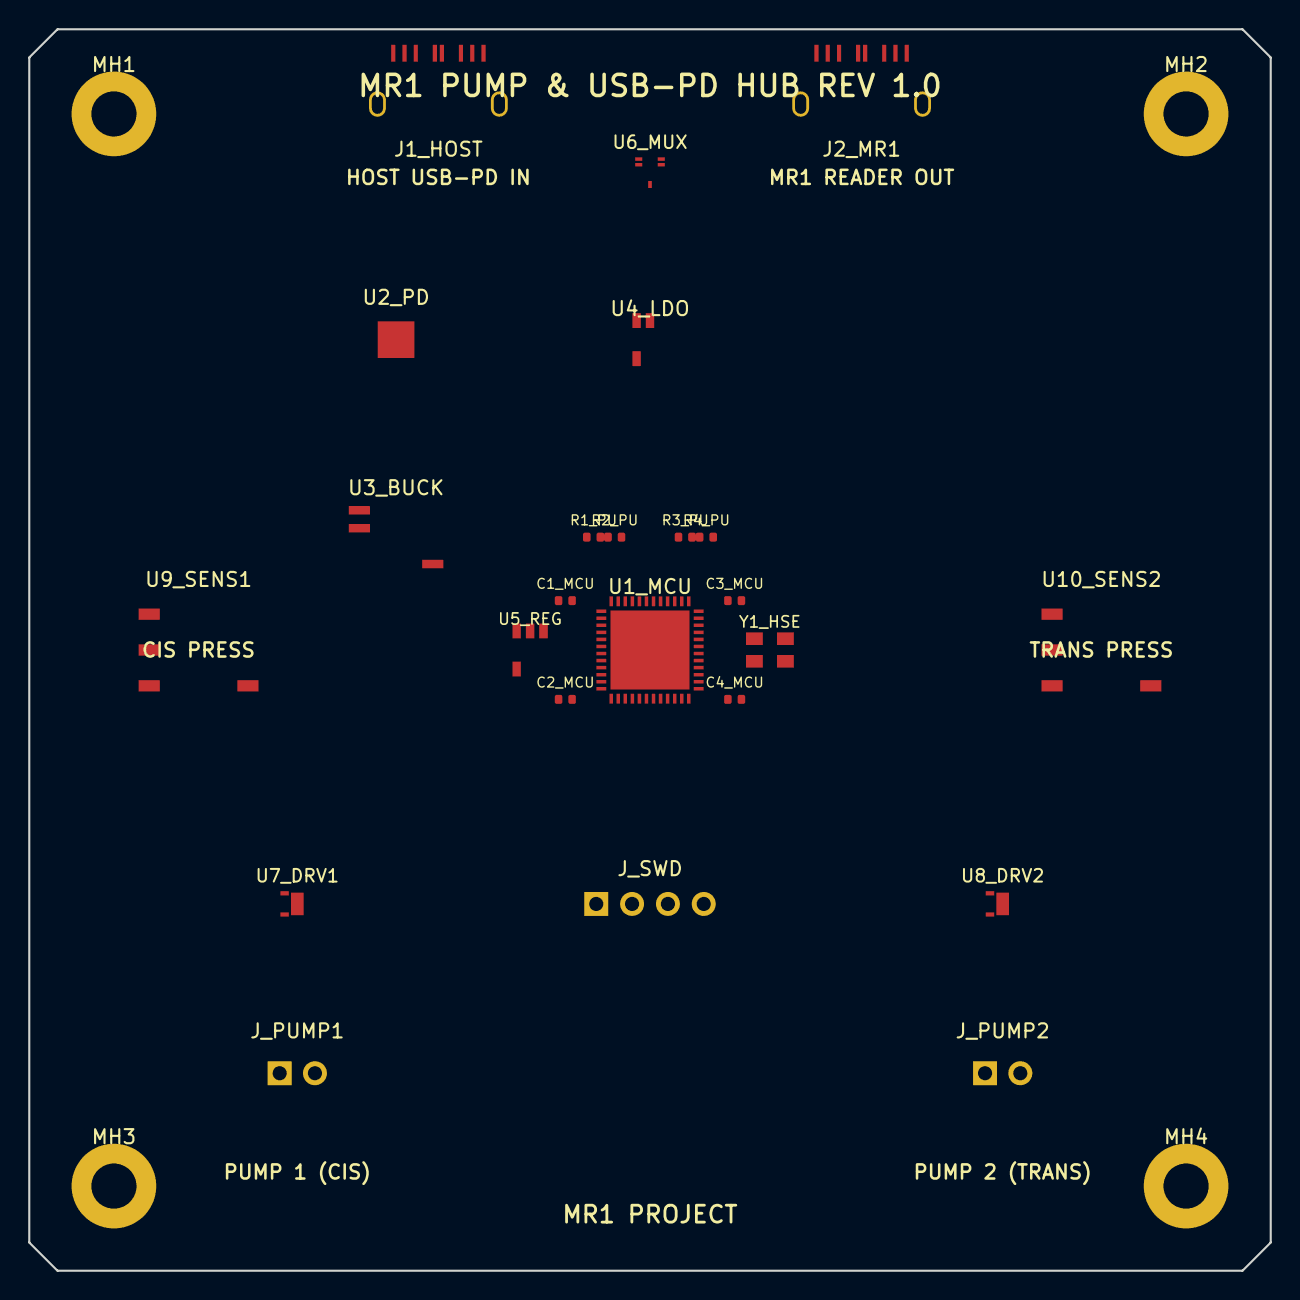
[picture p21: board Pump.kicad_pcb from above]

Board: 4 copper layers, 88.0 x 88.0 mm, 28 parts (0 on the bottom side), 13 nets, no tracks yet.

Parts:
C1_MCU, C2_MCU, C3_MCU, C4_MCU: 100nF; C_0402_1005Metric
J1_HOST: USB_C_HOST; USB_C_Receptacle_GCT_USB4085
J2_MR1: USB_C_MR1_OUT; USB_C_Receptacle_GCT_USB4085
J_PUMP1, J_PUMP2: PUMP_MOTOR; JST_XH_B2B-XH-A_1x02_P2.50mm_Vertical
J_SWD: PinHeader_1x04_P2.54mm_Vertical
MH1, MH2, MH3, MH4: MountingHole_3.2mm_M3_Pad
R1_PU, R2_PU, R3_PU, R4_PU: 4.7k; R_0402_1005Metric
U1_MCU: STM32G431CBU6; QFN-48-1EP_7x7mm_P0.5mm_EP5.6x5.6mm
U2_PD: STUSB4500; QFN-24-1EP_4x4mm_P0.5mm_EP2.6x2.6mm
U3_BUCK: TPS54302; SOIC-8_3.9x4.9mm_P1.27mm
U4_LDO: LD39050_3V3; SOT-23-5
U5_REG: TLV70233_3V3_ANA; SOT-23-5
U6_MUX: TS3USB221; QFN-10_1.5x2mm_P0.4mm
U7_DRV1, U8_DRV2: DRV8837C; WSON-8-1EP_2x2mm_P0.5mm_EP0.9x1.6mm
U9_SENS1: ABP2_015PG_CIS; Honeywell_ABP_SMD
U10_SENS2: ABP2_005PG_TRANS; Honeywell_ABP_SMD
Y1_HSE: 8.000MHz; Crystal_SMD_3225-4Pin_3.2x2.5mm

Connections:
+3V3: C1_MCU.1, C2_MCU.1, C3_MCU.1, C4_MCU.1, J_SWD.1, R1_PU.1, R2_PU.1, R3_PU.1, R4_PU.1, U1_MCU.9, U1_MCU.24, U1_MCU.36, U1_MCU.48, U4_LDO.5, U5_REG.5, U9_SENS1.2, U10_SENS2.2
+5V_MR1_CLEAN: J2_MR1.A4, J2_MR1.A9, U3_BUCK.5, U4_LDO.1, U5_REG.1, U5_REG.3
+VBUS_PD: J1_HOST.A4, J1_HOST.A9, U3_BUCK.2
GND: C1_MCU.2, C2_MCU.2, C3_MCU.2, C4_MCU.2, J1_HOST.A1, J1_HOST.A12, J1_HOST.SH1, J1_HOST.SH2, J2_MR1.A1, J2_MR1.A12, J2_MR1.SH1, J2_MR1.SH2, J_SWD.4, MH1.1, MH2.1, MH3.1, MH4.1, U1_MCU.8, U1_MCU.23, U1_MCU.35, U1_MCU.47, U1_MCU.49, U2_PD.25, U3_BUCK.1, U4_LDO.2, U5_REG.2, U6_MUX.10, U7_DRV1.4, U7_DRV1.9, U8_DRV2.4, U8_DRV2.9, U9_SENS1.1, U10_SENS2.1, Y1_HSE.2, Y1_HSE.4
HOST_D+: J1_HOST.A6, U6_MUX.1
HOST_D-: J1_HOST.A7, U6_MUX.2
MR1_D+: J2_MR1.A6, U6_MUX.5
MR1_D-: J2_MR1.A7, U6_MUX.6
PRESS_I2C_SCL: R1_PU.2, U9_SENS1.4, U10_SENS2.4
PRESS_I2C_SDA: R2_PU.2, U9_SENS1.3, U10_SENS2.3
SBU1_HOST: J1_HOST.A8, R3_PU.2
SBU2_HOST: J1_HOST.B8, R4_PU.2
VMOTOR: U7_DRV1.1, U8_DRV2.1
