EpicQuestBio/MR1/wiring/reader_wiring.yaml

metadata:
  title: MR1 Reader - Electrical Wiring Harness
  description: Internal DC power, digital USB-C, peristaltic motor, and shielded analog pogo-pin interconnect
  author: OpenAuto-CFD / MR1 Team
  version: 1.0.0

options:
  fontname: Arial
  bgcolor: "#0b0f1a"
  bgcolor_connector: "#1e293b"
  bgcolor_cable: "#0f172a"
  color_mode: SHORT

connectors:
  J_USBC:
    type: USB-C Receptacle (24-Pin)
    subtype: female
    manufacturer: Molex
    mpn: 105450-0101
    notes: Enclosure rear panel power and data input
    pinlabels: [GND, VBUS, CC1, DP, DN, SBU1, CC2, SBU2]

  J_MR1_PWR:
    type: JST-GH (1.25mm Pitch)
    subtype: female
    manufacturer: JST
    mpn: GHR-04V-S
    notes: MR1 Motherboard Power Input
    pinlabels: [GND, VBUS, CC_SENSE, 3V3_DIGITAL]

  J_MR1_MOTOR:
    type: Molex PicoBlade (1.25mm Pitch)
    subtype: female
    manufacturer: Molex
    mpn: 51021-0200
    notes: MR1 Motherboard H-Bridge Motor Driver Output
    pinlabels: [MOT_A, MOT_B]

  M_PUMP:
    type: DC Geared Coreless Motor
    subtype: male
    manufacturer: Pololu
    mpn: 2364
    notes: Peristaltic Pump Drive Motor (3V-6V DC, 600mA stall)
    pinlabels: [M_PLUS, M_MINUS]

  J_POGO_ARRAY:
    type: Spring Loaded Pogo Pin Block (4-Pin)
    subtype: male
    manufacturer: Mill-Max
    mpn: 824-22-004-00-001000
    notes: Reader Lid to Amplifier PCB interface (Gold-plated, 0.8N contact force)
    pinlabels: [VCC_3V3_A, AGND, TIA_VOUT, V_BIAS_REF]

  TP_AMP_PCB:
    type: Gold Target Test Pads (1.5mm Dia)
    subtype: female
    notes: Amplifier PCB Analog Front-End Interface (LMP7721)
    pinlabels: [PAD_3V3, PAD_AGND, PAD_SIG_OUT, PAD_BIAS_REF]

  J_AMP_POGO_12PIN:
    type: Coaxial Pogo Pin Array (12 discrete SMT pins on F.Cu)
    subtype: male
    manufacturer: LCSC
    mpn: C5221285 / YTC1P-6030-01
    notes: Inverted Amplifier PCB to PTFE Interposer (7.5mm working height, 0.8N/pin)
    pinlabels: [P1_GNDA, P2_WS_CIS_WIDE, P3_GUARD_WIDE, P4_GUARD, P5_WS_CIS, P6_GUARD, P7_CE_GNDA, P8_RE_TRANS, P9_PORE_AMP, P10_GNDA, P11_WEEP_SENSE, P12_GNDA]

  J_INTERPOSER_PADS:
    type: ENIG Target Landing Array (12 Coax Sites with Driven Guard Rings)
    subtype: female
    notes: PTFE Interposer top landing pads (Pad 1 = signal pad, Pad 2 = outer guard/ground ring)
    pinlabels: [PAD1_GNDA, PAD2_WS_WIDE, PAD3_GRD_WIDE, PAD4_GRD_A, PAD5_WS_CIS, PAD6_GRD_B, PAD7_CE_GNDA, PAD8_RE_TRANS, PAD9_PORE_AMP, PAD10_GNDA, PAD11_WEEP, PAD12_GNDA]

cables:
  W_USB:
    gauge: 28 AWG
    length: 0.08 m
    shield: true
    colors: [BK, RD, BU, GN, WH, YE, OG, GY]
    notes: High-speed USB-C internal routing harness

  W_MOTOR:
    gauge: 24 AWG
    length: 0.12 m
    colors: [RD, BK]
    notes: Twisted pair motor drive power (shielded against EMI)

  W_POGO_ANALOG:
    gauge: 30 AWG
    length: 0.09 m
    shield: true
    colors: [RD, BK, GN, WH]
    notes: Ultra-low-noise analog signal harness from Lid Pogo array to MR1 ADC

  W_COAX_POGO:
    gauge: 30 AWG
    length: 0.008 m
    shield: true
    colors: [BK, BU, GN, YE, RD, YE, BK, WH, OG, BK, VT, BK]
    notes: 7.5mm vertical coax pogo pin bridge across PP/printed spacer cavity

connections:
  -
    - J_USBC: [1, 2, 3, 4]
    - W_USB: [1, 2, 3, 4]
    - J_MR1_PWR: [1, 2, 3, 4]
  -
    - J_MR1_MOTOR: [1, 2]
    - W_MOTOR: [1, 2]
    - M_PUMP: [1, 2]
  -
    - J_POGO_ARRAY: [1, 2, 3, 4]
    - W_POGO_ANALOG: [1, 2, 3, 4]
    - TP_AMP_PCB: [1, 2, 3, 4]
  -
    - J_AMP_POGO_12PIN: [1, 2, 3, 4, 5, 6, 7, 8, 9, 10, 11, 12]
    - W_COAX_POGO: [1, 2, 3, 4, 5, 6, 7, 8, 9, 10, 11, 12]
    - J_INTERPOSER_PADS: [1, 2, 3, 4, 5, 6, 7, 8, 9, 10, 11, 12]
