EpicQuestBio/MR1/MR1_firmware/src/hal/adc_ad40xx.h

/*
 * Created by Lawrence R. Kincheloe III / Molecular Reality Corp (2026).
 * Dedicated to the public domain under CC0 1.0 Universal (CC0-1.0).
 * SPDX-License-Identifier: CC0-1.0
 */

/**
 * @file adc_ad40xx.h
 * @brief High-Speed AD40xx Differential SAR ADC Driver (100 kHz Sampling Engine)
 */

#pragma once

#include <Arduino.h>
#include <SPI.h>
#include "pinout.h"
#include "config.h"
#include "protocol.h"

class AdcAD40xx {
public:
    AdcAD40xx();

    /**
     * @brief Initialize SPI peripheral, GPIOs, and DMA buffers
     */
    void begin();

    /**
     * @brief Start continuous hardware-timed sampling at specified frequency
     * @param sample_rate_hz Target rate (up to 100000 Hz)
     */
    bool start_sampling(uint32_t sample_rate_hz = DEFAULT_SAMPLE_RATE_HZ);

    /**
     * @brief Stop continuous sampling
     */
    void stop_sampling();

    /**
     * @brief Single-shot software read of differential sample
     * @return 16-bit signed differential code
     */
    int16_t read_single();

    /**
     * @brief Fetch the next completed StreamFrame from the ring buffer
     * @param out_frame Destination frame pointer
     * @return true if a frame was dequeued, false if buffer empty
     */
    bool get_next_frame(StreamFrame* out_frame);

    /**
     * @brief Fetch latest decimated sample for Web Portal visualization (1 kHz)
     */
    int16_t get_latest_decimated_sample() const { return _latest_decimated; }

    /**
     * @brief Total number of frames captured since start
     */
    uint32_t get_total_frames() const { return _frame_sequence; }

    /**
     * @brief Total number of dropped frames due to ring buffer overflow
     */
    uint32_t get_dropped_frames() const { return _dropped_frames; }

    /**
     * @brief Configure active readout route (1 or 2)
     * @param route 1 = Route 1 (Sub-5nm, LMP7721, ROUTE_SEL=LOW), 2 = Route 2 (Wideband/Micropore, OPA2192, ROUTE_SEL=HIGH)
     */
    void set_route(uint8_t route);

    /**
     * @brief Fetch current readout route (1 or 2)
     */
    uint8_t get_route() const { return _active_route; }

    /**
     * @brief Core ISR handler called by hardware timer
     */
    void IRAM_ATTR on_timer_tick();

    bool is_sampling() const { return _sampling_active; }

private:
    SPIClass*   _spi;
    bool        _sampling_active;
    uint8_t     _active_route;
    uint32_t    _sample_rate_hz;
    uint32_t    _frame_sequence;
    uint32_t    _dropped_frames;

    // Ping-pong double buffers
    StreamFrame _frames[RING_BUFFER_FRAME_COUNT];
    volatile uint8_t  _write_idx;
    volatile uint8_t  _read_idx;
    volatile uint16_t _sample_in_frame;

    // Decimation tracking
    int32_t  _decimation_accumulator;
    uint16_t _decimation_count;
    int16_t  _latest_decimated;
};

extern AdcAD40xx Adc;
