EpicQuestBio/MR1/scripts/build_interposer_symbols.py

# Created by Lawrence R. Kincheloe III / Molecular Reality Corp (2026).
# Dedicated to the public domain under CC0 1.0 Universal (CC0-1.0).
# SPDX-License-Identifier: CC0-1.0

"""
build_interposer_symbols.py

Generates dedicated, high-fidelity symbols for all physical and electrical features
of the PTFE Microfluidic Interposer Board:
1. Interposer/symbols/Interposer.kicad_sym:
   - Dedicated symbols with custom graphics:
     * PogoPin_Target_12Pin_Distributed (12-pin precision gold landing target array)
     * Electrode_Guard_Shield (Ag/AgCl ribbon electrode pad with driven guard shield)
     * Nanopore_Wafer_Aperture (central silicon chip carrier well & diamond fluidic aperture)
     * Weep_Moat_Sensor (leak-detection perimeter moisture moat)
     * Fluidic_Port_PassThrough (d=2.0mm microfluidic pass-through port)
2. Updates Interposer/sym-lib-table to register the Interposer library.
3. Builds Interposer/Interposer.kicad_sch associating each feature symbol, footprint,
   pin connection, net labels, and schematic design notes.
"""

import re
import uuid
from pathlib import Path

def new_uuid():
    return str(uuid.uuid4())

def generate_symbol_library():
    symbols_dir = Path("Interposer/symbols")
    symbols_dir.mkdir(parents=True, exist_ok=True)
    sym_file = symbols_dir / "Interposer.kicad_sym"

    content = f"""(kicad_symbol_lib
\t(version 20241209)
\t(generator "kicad_symbol_editor")
\t(generator_version "10.0")

\t(symbol "PogoPin_Target_12Pin_Distributed"
\t\t(pin_names (offset 1.016))
\t\t(exclude_from_sim no)
\t\t(in_bom yes)
\t\t(on_board yes)
\t\t(property "Reference" "J_POGO1" (at 0 20.32 0) (effects (font (size 1.27 1.27))))
\t\t(property "Value" "PogoPin_Target_12Pin_Distributed" (at 0 -20.32 0) (effects (font (size 1.27 1.27))))
\t\t(property "Footprint" "footprints:PogoPin_Target_12Pin_Distributed" (at 0 0 0) (effects (font (size 1.27 1.27)) (hide yes)))
\t\t(property "Datasheet" "https://www.mill-max.com/products/new/spring-loaded-pogo-pins" (at 0 0 0) (effects (font (size 1.27 1.27)) (hide yes)))
\t\t(property "Description" "12-Position Distributed ENIG/Hard Gold Target Array (6 Bank B Cis + 6 Bank A Trans)" (at 0 0 0) (effects (font (size 1.27 1.27)) (hide yes)))
\t\t(property "ki_keywords" "pogo connector target array 12-pin mill-max 09xx enig hard-gold ptfe guard" (at 0 0 0) (effects (font (size 1.27 1.27)) (hide yes)))
\t\t(symbol "PogoPin_Target_12Pin_Distributed_0_1"
\t\t\t(rectangle (start -10.16 17.78) (end 10.16 -17.78) (stroke (width 0.254) (type default)) (fill (type background)))
\t\t)
\t\t(symbol "PogoPin_Target_12Pin_Distributed_1_1"
\t\t\t(pin passive line (at -15.24 13.97 0) (length 5.08)
\t\t\t\t(name "GNDA_SHLD" (effects (font (size 1.0 1.0))))
\t\t\t\t(number "1" (effects (font (size 1.0 1.0))))
\t\t\t)
\t\t\t(pin passive line (at -15.24 11.43 0) (length 5.08)
\t\t\t\t(name "WS_CIS_WIDE" (effects (font (size 1.0 1.0))))
\t\t\t\t(number "2" (effects (font (size 1.0 1.0))))
\t\t\t)
\t\t\t(pin passive line (at -15.24 8.89 0) (length 5.08)
\t\t\t\t(name "GUARD_WIDE" (effects (font (size 1.0 1.0))))
\t\t\t\t(number "3" (effects (font (size 1.0 1.0))))
\t\t\t)
\t\t\t(pin passive line (at -15.24 6.35 0) (length 5.08)
\t\t\t\t(name "GUARD_CIS_A" (effects (font (size 1.0 1.0))))
\t\t\t\t(number "4" (effects (font (size 1.0 1.0))))
\t\t\t)
\t\t\t(pin passive line (at -15.24 3.81 0) (length 5.08)
\t\t\t\t(name "WS_CIS" (effects (font (size 1.0 1.0))))
\t\t\t\t(number "5" (effects (font (size 1.0 1.0))))
\t\t\t)
\t\t\t(pin passive line (at -15.24 1.27 0) (length 5.08)
\t\t\t\t(name "GUARD_CIS_B" (effects (font (size 1.0 1.0))))
\t\t\t\t(number "6" (effects (font (size 1.0 1.0))))
\t\t\t)
\t\t\t(pin passive line (at -15.24 -1.27 0) (length 5.08)
\t\t\t\t(name "CE_GNDA" (effects (font (size 1.0 1.0))))
\t\t\t\t(number "7" (effects (font (size 1.0 1.0))))
\t\t\t)
\t\t\t(pin passive line (at -15.24 -3.81 0) (length 5.08)
\t\t\t\t(name "RE_TRANS" (effects (font (size 1.0 1.0))))
\t\t\t\t(number "8" (effects (font (size 1.0 1.0))))
\t\t\t)
\t\t\t(pin passive line (at -15.24 -6.35 0) (length 5.08)
\t\t\t\t(name ">PORE_AMP" (effects (font (size 1.0 1.0))))
\t\t\t\t(number "9" (effects (font (size 1.0 1.0))))
\t\t\t)
\t\t\t(pin passive line (at -15.24 -8.89 0) (length 5.08)
\t\t\t\t(name "GNDA" (effects (font (size 1.0 1.0))))
\t\t\t\t(number "10" (effects (font (size 1.0 1.0))))
\t\t\t)
\t\t\t(pin passive line (at -15.24 -11.43 0) (length 5.08)
\t\t\t\t(name "WEEP_SENSE" (effects (font (size 1.0 1.0))))
\t\t\t\t(number "11" (effects (font (size 1.0 1.0))))
\t\t\t)
\t\t\t(pin passive line (at -15.24 -13.97 0) (length 5.08)
\t\t\t\t(name "GNDA_WEEP" (effects (font (size 1.0 1.0))))
\t\t\t\t(number "12" (effects (font (size 1.0 1.0))))
\t\t\t)
\t\t)
\t)

\t(symbol "Concentric_Electrode_Cell"
\t\t(pin_names (offset 1.016))
\t\t(exclude_from_sim no)
\t\t(in_bom yes)
\t\t(on_board yes)
\t\t(property "Reference" "E" (at 0 11.43 0) (effects (font (size 1.27 1.27))))
\t\t(property "Value" "Concentric_Electrode_Cell" (at 0 -11.43 0) (effects (font (size 1.27 1.27))))
\t\t(property "Footprint" "footprints:Concentric_Electrode_Cell" (at 0 0 0) (effects (font (size 1.27 1.27)) (hide yes)))
\t\t(property "Datasheet" "~" (at 0 0 0) (effects (font (size 1.27 1.27)) (hide yes)))
\t\t(property "Description" "Concentric Electrochemical Cell Electrodes (WE, WS, Guard, RE, CE)" (at 0 0 0) (effects (font (size 1.27 1.27)) (hide yes)))
\t\t(symbol "Concentric_Electrode_Cell_0_1"
\t\t\t(rectangle (start -10.16 10.16) (end 10.16 -10.16) (stroke (width 0.254) (type default)) (fill (type background)))
\t\t)
\t\t(symbol "Concentric_Electrode_Cell_1_1"
\t\t\t(pin passive line (at -15.24 5.08 0) (length 5.08)
\t\t\t\t(name "WE_POS" (effects (font (size 1.0 1.0))))
\t\t\t\t(number "1" (effects (font (size 1.0 1.0))))
\t\t\t)
\t\t\t(pin passive line (at -15.24 2.54 0) (length 5.08)
\t\t\t\t(name "WS_CIS" (effects (font (size 1.0 1.0))))
\t\t\t\t(number "2" (effects (font (size 1.0 1.0))))
\t\t\t)
\t\t\t(pin passive line (at -15.24 0 0) (length 5.08)
\t\t\t\t(name "GUARD" (effects (font (size 1.0 1.0))))
\t\t\t\t(number "3" (effects (font (size 1.0 1.0))))
\t\t\t)
\t\t\t(pin passive line (at -15.24 -2.54 0) (length 5.08)
\t\t\t\t(name "RE_TRANS" (effects (font (size 1.0 1.0))))
\t\t\t\t(number "4" (effects (font (size 1.0 1.0))))
\t\t\t)
\t\t\t(pin passive line (at -15.24 -5.08 0) (length 5.08)
\t\t\t\t(name "CE_GNDA" (effects (font (size 1.0 1.0))))
\t\t\t\t(number "5" (effects (font (size 1.0 1.0))))
\t\t\t)
\t\t)
\t)

\t(symbol "PogoPin_Target_6Pin_Cis"
\t\t(pin_names (offset 1.016))
\t\t(exclude_from_sim no)
\t\t(in_bom yes)
\t\t(on_board yes)
\t\t(property "Reference" "J_POGO_CIS" (at 0 11.43 0) (effects (font (size 1.27 1.27))))
\t\t(property "Value" "PogoPin_Target_6Pin_Cis" (at 0 -11.43 0) (effects (font (size 1.27 1.27))))
\t\t(property "Footprint" "footprints:PogoPin_Target_6Pin_Cis" (at 0 0 0) (effects (font (size 1.27 1.27)) (hide yes)))
\t\t(property "Datasheet" "https://www.mill-max.com/products/new/spring-loaded-pogo-pins" (at 0 0 0) (effects (font (size 1.27 1.27)) (hide yes)))
\t\t(property "Description" "6-Position Bare ENIG/Hard Gold Cis Target Array (GNDA, >PORE_AMP, GNDA, GUARD, GNDA, WEEP_SENSE)" (at 0 0 0) (effects (font (size 1.27 1.27)) (hide yes)))
\t\t(property "ki_keywords" "pogo connector target array 6-pin mill-max 09xx enig hard-gold ptfe guard" (at 0 0 0) (effects (font (size 1.27 1.27)) (hide yes)))
\t\t(symbol "PogoPin_Target_6Pin_Cis_0_1"
\t\t\t(rectangle (start -10.16 10.16) (end 10.16 -10.16) (stroke (width 0.254) (type default)) (fill (type background)))
\t\t)
\t\t(symbol "PogoPin_Target_6Pin_Cis_1_1"
\t\t\t(pin passive line (at -15.24 6.35 0) (length 5.08)
\t\t\t\t(name "GNDA" (effects (font (size 1.0 1.0))))
\t\t\t\t(number "1" (effects (font (size 1.0 1.0))))
\t\t\t)
\t\t\t(pin passive line (at -15.24 3.81 0) (length 5.08)
\t\t\t\t(name ">PORE_AMP" (effects (font (size 1.0 1.0))))
\t\t\t\t(number "2" (effects (font (size 1.0 1.0))))
\t\t\t)
\t\t\t(pin passive line (at -15.24 1.27 0) (length 5.08)
\t\t\t\t(name "GNDA" (effects (font (size 1.0 1.0))))
\t\t\t\t(number "3" (effects (font (size 1.0 1.0))))
\t\t\t)
\t\t\t(pin passive line (at -15.24 -1.27 0) (length 5.08)
\t\t\t\t(name "GUARD" (effects (font (size 1.0 1.0))))
\t\t\t\t(number "4" (effects (font (size 1.0 1.0))))
\t\t\t)
\t\t\t(pin passive line (at -15.24 -3.81 0) (length 5.08)
\t\t\t\t(name "GNDA" (effects (font (size 1.0 1.0))))
\t\t\t\t(number "5" (effects (font (size 1.0 1.0))))
\t\t\t)
\t\t\t(pin passive line (at -15.24 -6.35 0) (length 5.08)
\t\t\t\t(name "WEEP_SENSE" (effects (font (size 1.0 1.0))))
\t\t\t\t(number "6" (effects (font (size 1.0 1.0))))
\t\t\t)
\t\t)
\t)

\t(symbol "PogoPin_Target_6Pin_Trans"
\t\t(pin_names (offset 1.016))
\t\t(exclude_from_sim no)
\t\t(in_bom yes)
\t\t(on_board yes)
\t\t(property "Reference" "J_POGO_TRANS" (at 0 11.43 0) (effects (font (size 1.27 1.27))))
\t\t(property "Value" "PogoPin_Target_6Pin_Trans" (at 0 -11.43 0) (effects (font (size 1.27 1.27))))
\t\t(property "Footprint" "footprints:PogoPin_Target_6Pin_Trans" (at 0 0 0) (effects (font (size 1.27 1.27)) (hide yes)))
\t\t(property "Datasheet" "https://www.mill-max.com/products/new/spring-loaded-pogo-pins" (at 0 0 0) (effects (font (size 1.27 1.27)) (hide yes)))
\t\t(property "Description" "6-Position Bare ENIG/Hard Gold Trans Target Array (CE_GNDA, RE_TRANS, GUARD_WIDE, WS_CIS_WIDE, GUARD, WS_CIS)" (at 0 0 0) (effects (font (size 1.27 1.27)) (hide yes)))
\t\t(property "ki_keywords" "pogo connector target array 6-pin mill-max 09xx enig hard-gold ptfe guard" (at 0 0 0) (effects (font (size 1.27 1.27)) (hide yes)))
\t\t(symbol "PogoPin_Target_6Pin_Trans_0_1"
\t\t\t(rectangle (start -10.16 10.16) (end 10.16 -10.16) (stroke (width 0.254) (type default)) (fill (type background)))
\t\t)
\t\t(symbol "PogoPin_Target_6Pin_Trans_1_1"
\t\t\t(pin passive line (at -15.24 6.35 0) (length 5.08)
\t\t\t\t(name "CE_GNDA" (effects (font (size 1.0 1.0))))
\t\t\t\t(number "1" (effects (font (size 1.0 1.0))))
\t\t\t)
\t\t\t(pin passive line (at -15.24 3.81 0) (length 5.08)
\t\t\t\t(name "RE_TRANS" (effects (font (size 1.0 1.0))))
\t\t\t\t(number "2" (effects (font (size 1.0 1.0))))
\t\t\t)
\t\t\t(pin passive line (at -15.24 1.27 0) (length 5.08)
\t\t\t\t(name "GUARD_WIDE" (effects (font (size 1.0 1.0))))
\t\t\t\t(number "3" (effects (font (size 1.0 1.0))))
\t\t\t)
\t\t\t(pin passive line (at -15.24 -1.27 0) (length 5.08)
\t\t\t\t(name "WS_CIS_WIDE" (effects (font (size 1.0 1.0))))
\t\t\t\t(number "4" (effects (font (size 1.0 1.0))))
\t\t\t)
\t\t\t(pin passive line (at -15.24 -3.81 0) (length 5.08)
\t\t\t\t(name "GUARD" (effects (font (size 1.0 1.0))))
\t\t\t\t(number "5" (effects (font (size 1.0 1.0))))
\t\t\t)
\t\t\t(pin passive line (at -15.24 -6.35 0) (length 5.08)
\t\t\t\t(name "WS_CIS" (effects (font (size 1.0 1.0))))
\t\t\t\t(number "6" (effects (font (size 1.0 1.0))))
\t\t\t)
\t\t)
\t)

\t(symbol "PogoPin_Target_6Pin_Array"
\t\t(pin_names (offset 1.016))
\t\t(exclude_from_sim no)
\t\t(in_bom yes)
\t\t(on_board yes)
\t\t(property "Reference" "J_POGO_TRANS" (at 0 11.43 0) (effects (font (size 1.27 1.27))))
\t\t(property "Value" "PogoPin_Target_6Pin_Array" (at 0 -11.43 0) (effects (font (size 1.27 1.27))))
\t\t(property "Footprint" "footprints:PogoPin_Target_6Pin_Array" (at 0 0 0) (effects (font (size 1.27 1.27)) (hide yes)))
\t\t(property "Datasheet" "https://www.mill-max.com/products/new/spring-loaded-pogo-pins" (at 0 0 0) (effects (font (size 1.27 1.27)) (hide yes)))
\t\t(property "Description" "6-Position Bare ENIG/Hard Gold Trans Target Array (alias of PogoPin_Target_6Pin_Trans)" (at 0 0 0) (effects (font (size 1.27 1.27)) (hide yes)))
\t\t(property "ki_keywords" "pogo connector target array 6-pin mill-max 09xx enig hard-gold ptfe guard" (at 0 0 0) (effects (font (size 1.27 1.27)) (hide yes)))
\t\t(symbol "PogoPin_Target_6Pin_Array_0_1"
\t\t\t(rectangle (start -10.16 10.16) (end 10.16 -10.16) (stroke (width 0.254) (type default)) (fill (type background)))
\t\t)
\t\t(symbol "PogoPin_Target_6Pin_Array_1_1"
\t\t\t(pin passive line (at -15.24 6.35 0) (length 5.08)
\t\t\t\t(name "CE_GNDA" (effects (font (size 1.0 1.0))))
\t\t\t\t(number "1" (effects (font (size 1.0 1.0))))
\t\t\t)
\t\t\t(pin passive line (at -15.24 3.81 0) (length 5.08)
\t\t\t\t(name "RE_TRANS" (effects (font (size 1.0 1.0))))
\t\t\t\t(number "2" (effects (font (size 1.0 1.0))))
\t\t\t)
\t\t\t(pin passive line (at -15.24 1.27 0) (length 5.08)
\t\t\t\t(name "GUARD_WIDE" (effects (font (size 1.0 1.0))))
\t\t\t\t(number "3" (effects (font (size 1.0 1.0))))
\t\t\t)
\t\t\t(pin passive line (at -15.24 -1.27 0) (length 5.08)
\t\t\t\t(name "WS_CIS_WIDE" (effects (font (size 1.0 1.0))))
\t\t\t\t(number "4" (effects (font (size 1.0 1.0))))
\t\t\t)
\t\t\t(pin passive line (at -15.24 -3.81 0) (length 5.08)
\t\t\t\t(name "GUARD" (effects (font (size 1.0 1.0))))
\t\t\t\t(number "5" (effects (font (size 1.0 1.0))))
\t\t\t)
\t\t\t(pin passive line (at -15.24 -6.35 0) (length 5.08)
\t\t\t\t(name "WS_CIS" (effects (font (size 1.0 1.0))))
\t\t\t\t(number "6" (effects (font (size 1.0 1.0))))
\t\t\t)
\t\t)
\t)

\t(symbol "Electrode_Guard_Shield"
\t\t(pin_names (offset 1.016))
\t\t(exclude_from_sim no)
\t\t(in_bom yes)
\t\t(on_board yes)
\t\t(property "Reference" "J" (at 0 6.35 0) (effects (font (size 1.27 1.27))))
\t\t(property "Value" "Electrode_Guard_Shield" (at 0 -6.35 0) (effects (font (size 1.27 1.27))))
\t\t(property "Footprint" "footprints:Electrode_Guard_Shield" (at 0 0 0) (effects (font (size 1.27 1.27)) (hide yes)))
\t\t(property "Datasheet" "~" (at 0 0 0) (effects (font (size 1.27 1.27)) (hide yes)))
\t\t(property "Description" "Ag/AgCl Microfluidic Ribbon Electrode Pad with Concentric Guard Shield" (at 0 0 0) (effects (font (size 1.27 1.27)) (hide yes)))
\t\t(property "ki_keywords" "electrode ag/agcl guard ribbon" (at 0 0 0) (effects (font (size 1.27 1.27)) (hide yes)))
\t\t(symbol "Electrode_Guard_Shield_0_1"
\t\t\t(rectangle (start -7.62 5.08) (end 7.62 -5.08) (stroke (width 0.254) (type default)) (fill (type background)))
\t\t\t(circle (center 0 1.27) (radius 1.27) (stroke (width 0.1524) (type default)) (fill (type none)))
\t\t\t(circle (center 0 1.27) (radius 2.54) (stroke (width 0.1524) (type default)) (fill (type none)))
\t\t)
\t\t(symbol "Electrode_Guard_Shield_1_1"
\t\t\t(pin passive line (at -12.7 1.27 0) (length 5.08)
\t\t\t\t(name "ELECTRODE" (effects (font (size 1.0 1.0))))
\t\t\t\t(number "1" (effects (font (size 1.0 1.0))))
\t\t\t)
\t\t\t(pin passive line (at -12.7 -2.54 0) (length 5.08)
\t\t\t\t(name "GUARD" (effects (font (size 1.0 1.0))))
\t\t\t\t(number "2" (effects (font (size 1.0 1.0))))
\t\t\t)
\t\t)
\t)

\t(symbol "Nanopore_Wafer_Aperture"
\t\t(pin_names (offset 1.016))
\t\t(exclude_from_sim no)
\t\t(in_bom yes)
\t\t(on_board yes)
\t\t(property "Reference" "H" (at 0 8.89 0) (effects (font (size 1.27 1.27))))
\t\t(property "Value" "Nanopore_Wafer_Aperture" (at 0 -8.89 0) (effects (font (size 1.27 1.27))))
\t\t(property "Footprint" "footprints:Nanopore holder_recessed" (at 0 0 0) (effects (font (size 1.27 1.27)) (hide yes)))
\t\t(property "Datasheet" "~" (at 0 0 0) (effects (font (size 1.27 1.27)) (hide yes)))
\t\t(property "Description" "Central 6.20x6.20mm Diamond Aperture for 4x4mm Silicon Nanopore Wafer" (at 0 0 0) (effects (font (size 1.27 1.27)) (hide yes)))
\t\t(property "ki_keywords" "nanopore wafer aperture flowcell holder" (at 0 0 0) (effects (font (size 1.27 1.27)) (hide yes)))
\t\t(symbol "Nanopore_Wafer_Aperture_0_1"
\t\t\t(rectangle (start -7.62 7.62) (end 7.62 -7.62) (stroke (width 0.254) (type default)) (fill (type background)))
\t\t\t(polyline
\t\t\t\t(pts (xy 0 5.08) (xy 5.08 0) (xy 0 -5.08) (xy -5.08 0) (xy 0 5.08))
\t\t\t\t(stroke (width 0.2) (type default))
\t\t\t\t(fill (type outline))
\t\t\t)
\t\t\t(circle (center 0 0) (radius 0.762) (stroke (width 0.254) (type default)) (fill (type color) (color 0 240 255 1.0)))
\t\t)
\t\t(symbol "Nanopore_Wafer_Aperture_1_1"
\t\t\t(pin passive line (at 0 12.7 270) (length 5.08)
\t\t\t\t(name "CIS_WELL" (effects (font (size 1.0 1.0))))
\t\t\t\t(number "1" (effects (font (size 1.0 1.0))))
\t\t\t)
\t\t\t(pin passive line (at 0 -12.7 90) (length 5.08)
\t\t\t\t(name "TRANS_WELL" (effects (font (size 1.0 1.0))))
\t\t\t\t(number "2" (effects (font (size 1.0 1.0))))
\t\t\t)
\t\t)
\t)

\t(symbol "Weep_Moat_Sensor"
\t\t(pin_names (offset 1.016))
\t\t(exclude_from_sim no)
\t\t(in_bom yes)
\t\t(on_board yes)
\t\t(property "Reference" "W" (at 0 6.35 0) (effects (font (size 1.27 1.27))))
\t\t(property "Value" "Weep_Moat_Sensor" (at 0 -6.35 0) (effects (font (size 1.27 1.27))))
\t\t(property "Footprint" "" (at 0 0 0) (effects (font (size 1.27 1.27)) (hide yes)))
\t\t(property "Datasheet" "~" (at 0 0 0) (effects (font (size 1.27 1.27)) (hide yes)))
\t\t(property "Description" "Perimeter Moisture & Leak Detection Sensor Moat (r=11mm)" (at 0 0 0) (effects (font (size 1.27 1.27)) (hide yes)))
\t\t(property "ki_keywords" "weep moat leak sensor" (at 0 0 0) (effects (font (size 1.27 1.27)) (hide yes)))
\t\t(symbol "Weep_Moat_Sensor_0_1"
\t\t\t(rectangle (start -6.35 5.08) (end 6.35 -5.08) (stroke (width 0.254) (type default)) (fill (type background)))
\t\t\t(arc (start -3.81 0) (mid 0 3.81) (end 3.81 0) (stroke (width 0.2) (type default)) (fill (type none)))
\t\t\t(arc (start -3.81 0) (mid 0 -3.81) (end 3.81 0) (stroke (width 0.2) (type default)) (fill (type none)))
\t\t)
\t\t(symbol "Weep_Moat_Sensor_1_1"
\t\t\t(pin passive line (at -11.43 2.54 0) (length 5.08)
\t\t\t\t(name "SENSE" (effects (font (size 1.0 1.0))))
\t\t\t\t(number "1" (effects (font (size 1.0 1.0))))
\t\t\t)
\t\t\t(pin passive line (at -11.43 -2.54 0) (length 5.08)
\t\t\t\t(name "RETURN" (effects (font (size 1.0 1.0))))
\t\t\t\t(number "2" (effects (font (size 1.0 1.0))))
\t\t\t)
\t\t)
\t)

\t(symbol "Fluidic_Port_PassThrough"
\t\t(pin_names (offset 1.016))
\t\t(exclude_from_sim no)
\t\t(in_bom yes)
\t\t(on_board yes)
\t\t(property "Reference" "P" (at 0 5.08 0) (effects (font (size 1.27 1.27))))
\t\t(property "Value" "Fluidic_Port_PassThrough" (at 0 -5.08 0) (effects (font (size 1.27 1.27))))
\t\t(property "Footprint" "" (at 0 0 0) (effects (font (size 1.27 1.27)) (hide yes)))
\t\t(property "Datasheet" "~" (at 0 0 0) (effects (font (size 1.27 1.27)) (hide yes)))
\t\t(property "Description" "D=2.0mm Microfluidic Pass-Through Port (r=20mm)" (at 0 0 0) (effects (font (size 1.27 1.27)) (hide yes)))
\t\t(property "ki_keywords" "fluidic port pass-through" (at 0 0 0) (effects (font (size 1.27 1.27)) (hide yes)))
\t\t(symbol "Fluidic_Port_PassThrough_0_1"
\t\t\t(circle (center 0 0) (radius 3.81) (stroke (width 0.254) (type default)) (fill (type background)))
\t\t\t(circle (center 0 0) (radius 1.905) (stroke (width 0.1524) (type default)) (fill (type none)))
\t\t)
\t\t(symbol "Fluidic_Port_PassThrough_1_1"
\t\t\t(pin passive line (at 0 8.89 270) (length 5.08)
\t\t\t\t(name "PORT" (effects (font (size 1.0 1.0))))
\t\t\t\t(number "1" (effects (font (size 1.0 1.0))))
\t\t\t)
\t\t)
\t)
)
"""
    sym_file.write_text(content, encoding="utf-8")
    print(f"Generated symbol library: {sym_file}")

def update_sym_lib_table():
    table_path = Path("Interposer/sym-lib-table")
    content = """(sym_lib_table
  (version 7)
  (lib (name "Interposer")(type "KiCad")(uri "${KIPRJMOD}/symbols/Interposer.kicad_sym")(options "")(descr "MR1 Interposer Symbols"))
  (lib (name "MR1")(type "KiCad")(uri "${KIPRJMOD}/footprints/MR1.kicad_sym")(options "")(descr ""))
)
"""
    table_path.write_text(content, encoding="utf-8")
    print(f"Updated sym-lib-table: {table_path}")

def build_schematic():
    sch_path = Path("Interposer/Interposer.kicad_sch")
    
    # Read the generated symbol library to embed lib_symbols
    sym_content = Path("Interposer/symbols/Interposer.kicad_sym").read_text(encoding="utf-8")
    
    # Only prefix TOP-LEVEL symbol names in lib_symbols with "Interposer:" (lines starting with \t(symbol ")
    sym_embedded = re.sub(r'^\t\(symbol\s+"([^"]+)"', r'\t(symbol "Interposer:\1"', sym_content, flags=re.MULTILINE)
    lines = sym_embedded.splitlines()[5:-1]
    embedded_symbols = "\n".join(lines)

    sch = f"""(kicad_sch
\t(version 20260306)
\t(generator "eeschema")
\t(generator_version "10.0")
\t(uuid "{new_uuid()}")
\t(paper "A3")
\t(title_block
\t\t(title "MR1 - PTFE Microfluidic Interposer Board")
\t\t(date "2026-09-30")
\t\t(rev "1.1")
\t\t(company "MR1 Open Source Nanopore Project")
\t\t(comment 1 "Dedicated Feature-Associated Schematic Architecture")
\t\t(comment 2 "0.8mm Rogers RO4350B (er=3.48) / PTFE Substrate (er=2.1, tan_delta=0.0002, ENIG Finish)")
\t\t(comment 3 "Mill-Max High Contact Force Spring Pin Landing Interface (Guarded Cis/Trans)")
\t\t(comment 4 "Dual-Sided Ag/AgCl Ribbon Electrode Contacts & Moisture Leak Moat Detection")
\t)
\t(lib_symbols
{embedded_symbols}
\t)

\t(symbol
\t\t(lib_id "Interposer:PogoPin_Target_12Pin_Distributed")
\t\t(at 60.0 80.0 0)
\t\t(unit 1)
\t\t(exclude_from_sim no)
\t\t(in_bom yes)
\t\t(on_board yes)
\t\t(dnp no)
\t\t(fields_autoplaced yes)
\t\t(uuid "{new_uuid()}")
\t\t(property "Reference" "J_POGO1" (at 60.0 55.0 0) (effects (font (size 1.27 1.27))))
\t\t(property "Value" "PogoPin_Target_12Pin_Distributed" (at 60.0 57.54 0) (effects (font (size 1.27 1.27))))
\t\t(property "Footprint" "footprints:PogoPin_Target_12Pin_Distributed" (at 60.0 80.0 0) (hide yes) (effects (font (size 1.27 1.27))))
\t\t(property "Datasheet" "https://www.mill-max.com" (at 60.0 80.0 0) (hide yes) (effects (font (size 1.27 1.27))))
\t\t(property "Description" "12-Position Distributed Gold Pogo Pin Landing Array for Nanopore Interposer" (at 60.0 80.0 0) (hide yes) (effects (font (size 1.27 1.27))))
\t\t(pin "1" (uuid "{new_uuid()}"))
\t\t(pin "2" (uuid "{new_uuid()}"))
\t\t(pin "3" (uuid "{new_uuid()}"))
\t\t(pin "4" (uuid "{new_uuid()}"))
\t\t(pin "5" (uuid "{new_uuid()}"))
\t\t(pin "6" (uuid "{new_uuid()}"))
\t\t(pin "7" (uuid "{new_uuid()}"))
\t\t(pin "8" (uuid "{new_uuid()}"))
\t\t(pin "9" (uuid "{new_uuid()}"))
\t\t(pin "10" (uuid "{new_uuid()}"))
\t\t(pin "11" (uuid "{new_uuid()}"))
\t\t(pin "12" (uuid "{new_uuid()}"))
\t)

\t(symbol
\t\t(lib_id "Interposer:PogoPin_Target_6Pin_Trans")
\t\t(at 60.0 130.0 0)
\t\t(unit 1)
\t\t(exclude_from_sim no)
\t\t(in_bom yes)
\t\t(on_board yes)
\t\t(dnp no)
\t\t(fields_autoplaced yes)
\t\t(uuid "{new_uuid()}")
\t\t(property "Reference" "J_POGO2" (at 60.0 116.0 0) (effects (font (size 1.27 1.27))))
\t\t(property "Value" "PogoPin_Target_6Pin_Trans" (at 60.0 118.54 0) (effects (font (size 1.27 1.27))))
\t\t(property "Footprint" "footprints:PogoPin_Target_6Pin_Trans" (at 60.0 130.0 0) (hide yes) (effects (font (size 1.27 1.27))))
\t\t(property "Datasheet" "https://www.mill-max.com" (at 60.0 130.0 0) (hide yes) (effects (font (size 1.27 1.27))))
\t\t(property "Description" "6-Position Trans Gold Pogo Pin Landing Array" (at 60.0 130.0 0) (hide yes) (effects (font (size 1.27 1.27))))
\t\t(pin "1" (uuid "{new_uuid()}"))
\t\t(pin "2" (uuid "{new_uuid()}"))
\t\t(pin "3" (uuid "{new_uuid()}"))
\t\t(pin "4" (uuid "{new_uuid()}"))
\t\t(pin "5" (uuid "{new_uuid()}"))
\t\t(pin "6" (uuid "{new_uuid()}"))
\t)

\t(symbol
\t\t(lib_id "Interposer:Nanopore_Wafer_Aperture")
\t\t(at 170.0 80.0 0)
\t\t(unit 1)
\t\t(exclude_from_sim no)
\t\t(in_bom yes)
\t\t(on_board yes)
\t\t(dnp no)
\t\t(fields_autoplaced yes)
\t\t(uuid "{new_uuid()}")
\t\t(property "Reference" "H1" (at 170.0 68.0 0) (effects (font (size 1.27 1.27))))
\t\t(property "Value" "Nanopore_Wafer_Aperture" (at 170.0 70.54 0) (effects (font (size 1.27 1.27))))
\t\t(property "Footprint" "footprints:Nanopore holder_recessed" (at 170.0 80.0 0) (hide yes) (effects (font (size 1.27 1.27))))
\t\t(property "Datasheet" "~" (at 170.0 80.0 0) (hide yes) (effects (font (size 1.27 1.27))))
\t\t(property "Description" "Central 6.20x6.20mm Diamond Aperture for 4x4mm Silicon Nanopore Wafer" (at 170.0 80.0 0) (hide yes) (effects (font (size 1.27 1.27))))
\t\t(pin "1" (uuid "{new_uuid()}"))
\t\t(pin "2" (uuid "{new_uuid()}"))
\t)

\t(symbol
\t\t(lib_id "Interposer:Fluidic_Port_PassThrough")
\t\t(at 320.0 20.0 0)
\t\t(unit 1)
\t\t(exclude_from_sim no)
\t\t(in_bom yes)
\t\t(on_board yes)
\t\t(dnp no)
\t\t(fields_autoplaced yes)
\t\t(uuid "{new_uuid()}")
\t\t(property "Reference" "H2" (at 320.0 12.0 0) (effects (font (size 1.27 1.27))))
\t\t(property "Value" "FluidHole_H2" (at 320.0 14.54 0) (effects (font (size 1.27 1.27))))
\t\t(property "Footprint" "MountingHole:MountingHole_2.1mm" (at 320.0 20.0 0) (hide yes) (effects (font (size 1.27 1.27))))
\t\t(property "Datasheet" "~" (at 320.0 20.0 0) (hide yes) (effects (font (size 1.27 1.27))))
\t\t(property "Description" "D=2.1mm Mechanical Fluid Hole H2" (at 320.0 20.0 0) (hide yes) (effects (font (size 1.27 1.27))))
\t\t(pin "1" (uuid "{new_uuid()}"))
\t)

\t(symbol
\t\t(lib_id "Interposer:Fluidic_Port_PassThrough")
\t\t(at 320.0 30.0 0)
\t\t(unit 1)
\t\t(exclude_from_sim no)
\t\t(in_bom yes)
\t\t(on_board yes)
\t\t(dnp no)
\t\t(fields_autoplaced yes)
\t\t(uuid "{new_uuid()}")
\t\t(property "Reference" "H3" (at 320.0 22.0 0) (effects (font (size 1.27 1.27))))
\t\t(property "Value" "FluidHole_H3" (at 320.0 24.54 0) (effects (font (size 1.27 1.27))))
\t\t(property "Footprint" "MountingHole:MountingHole_2.1mm" (at 320.0 30.0 0) (hide yes) (effects (font (size 1.27 1.27))))
\t\t(property "Datasheet" "~" (at 320.0 30.0 0) (hide yes) (effects (font (size 1.27 1.27))))
\t\t(property "Description" "D=2.1mm Mechanical Fluid Hole H3" (at 320.0 30.0 0) (hide yes) (effects (font (size 1.27 1.27))))
\t\t(pin "1" (uuid "{new_uuid()}"))
\t)

\t(symbol
\t\t(lib_id "Interposer:Fluidic_Port_PassThrough")
\t\t(at 320.0 40.0 0)
\t\t(unit 1)
\t\t(exclude_from_sim no)
\t\t(in_bom yes)
\t\t(on_board yes)
\t\t(dnp no)
\t\t(fields_autoplaced yes)
\t\t(uuid "{new_uuid()}")
\t\t(property "Reference" "H4" (at 320.0 32.0 0) (effects (font (size 1.27 1.27))))
\t\t(property "Value" "FluidHole_H4" (at 320.0 34.54 0) (effects (font (size 1.27 1.27))))
\t\t(property "Footprint" "MountingHole:MountingHole_2.1mm" (at 320.0 40.0 0) (hide yes) (effects (font (size 1.27 1.27))))
\t\t(property "Datasheet" "~" (at 320.0 40.0 0) (hide yes) (effects (font (size 1.27 1.27))))
\t\t(property "Description" "D=2.1mm Mechanical Fluid Hole H4" (at 320.0 40.0 0) (hide yes) (effects (font (size 1.27 1.27))))
\t\t(pin "1" (uuid "{new_uuid()}"))
\t)

\t(symbol
\t\t(lib_id "Interposer:Electrode_Guard_Shield")
\t\t(at 250.0 50.0 0)
\t\t(unit 1)
\t\t(exclude_from_sim no)
\t\t(in_bom yes)
\t\t(on_board yes)
\t\t(dnp no)
\t\t(fields_autoplaced yes)
\t\t(uuid "{new_uuid()}")
\t\t(property "Reference" "J1" (at 250.0 41.0 0) (effects (font (size 1.27 1.27))))
\t\t(property "Value" "Cis_Electrode_In" (at 250.0 43.54 0) (effects (font (size 1.27 1.27))))
\t\t(property "Footprint" "footprints:Electrode_Guard_Shield" (at 250.0 50.0 0) (hide yes) (effects (font (size 1.27 1.27))))
\t\t(property "Datasheet" "~" (at 250.0 50.0 0) (hide yes) (effects (font (size 1.27 1.27))))
\t\t(property "Description" "Ag/AgCl Ribbon Electrode Pad (Cis In, r=12mm) with Driven Guard Ring" (at 250.0 50.0 0) (hide yes) (effects (font (size 1.27 1.27))))
\t\t(pin "1" (uuid "{new_uuid()}"))
\t\t(pin "2" (uuid "{new_uuid()}"))
\t)

\t(symbol
\t\t(lib_id "Interposer:Electrode_Guard_Shield")
\t\t(at 250.0 75.0 0)
\t\t(unit 1)
\t\t(exclude_from_sim no)
\t\t(in_bom yes)
\t\t(on_board yes)
\t\t(dnp no)
\t\t(fields_autoplaced yes)
\t\t(uuid "{new_uuid()}")
\t\t(property "Reference" "J2" (at 250.0 66.0 0) (effects (font (size 1.27 1.27))))
\t\t(property "Value" "Cis_Electrode_Out" (at 250.0 68.54 0) (effects (font (size 1.27 1.27))))
\t\t(property "Footprint" "footprints:Electrode_Guard_Shield" (at 250.0 75.0 0) (hide yes) (effects (font (size 1.27 1.27))))
\t\t(property "Datasheet" "~" (at 250.0 75.0 0) (hide yes) (effects (font (size 1.27 1.27))))
\t\t(property "Description" "Ag/AgCl Ribbon Electrode Pad (Cis Out, r=17mm) with Driven Guard Ring" (at 250.0 75.0 0) (hide yes) (effects (font (size 1.27 1.27))))
\t\t(pin "1" (uuid "{new_uuid()}"))
\t\t(pin "2" (uuid "{new_uuid()}"))
\t)

\t(symbol
\t\t(lib_id "Interposer:Electrode_Guard_Shield")
\t\t(at 250.0 110.0 0)
\t\t(unit 1)
\t\t(exclude_from_sim no)
\t\t(in_bom yes)
\t\t(on_board yes)
\t\t(dnp no)
\t\t(fields_autoplaced yes)
\t\t(uuid "{new_uuid()}")
\t\t(property "Reference" "J10" (at 250.0 101.0 0) (effects (font (size 1.27 1.27))))
\t\t(property "Value" "Trans_Electrode_Out" (at 250.0 103.54 0) (effects (font (size 1.27 1.27))))
\t\t(property "Footprint" "footprints:Electrode_Guard_Shield" (at 250.0 110.0 0) (hide yes) (effects (font (size 1.27 1.27))))
\t\t(property "Datasheet" "~" (at 250.0 110.0 0) (hide yes) (effects (font (size 1.27 1.27))))
\t\t(property "Description" "Ag/AgCl Ribbon Electrode Pad (Trans Out, r=17mm) with Driven Guard Ring" (at 250.0 110.0 0) (hide yes) (effects (font (size 1.27 1.27))))
\t\t(pin "1" (uuid "{new_uuid()}"))
\t\t(pin "2" (uuid "{new_uuid()}"))
\t)

\t(symbol
\t\t(lib_id "Interposer:Electrode_Guard_Shield")
\t\t(at 250.0 135.0 0)
\t\t(unit 1)
\t\t(exclude_from_sim no)
\t\t(in_bom yes)
\t\t(on_board yes)
\t\t(dnp no)
\t\t(fields_autoplaced yes)
\t\t(uuid "{new_uuid()}")
\t\t(property "Reference" "J11" (at 250.0 126.0 0) (effects (font (size 1.27 1.27))))
\t\t(property "Value" "Trans_Electrode_In" (at 250.0 128.54 0) (effects (font (size 1.27 1.27))))
\t\t(property "Footprint" "footprints:Electrode_Guard_Shield" (at 250.0 135.0 0) (hide yes) (effects (font (size 1.27 1.27))))
\t\t(property "Datasheet" "~" (at 250.0 135.0 0) (hide yes) (effects (font (size 1.27 1.27))))
\t\t(property "Description" "Ag/AgCl Ribbon Electrode Pad (Trans In, r=12mm) with Driven Guard Ring" (at 250.0 135.0 0) (hide yes) (effects (font (size 1.27 1.27))))
\t\t(pin "1" (uuid "{new_uuid()}"))
\t\t(pin "2" (uuid "{new_uuid()}"))
\t)

\t(symbol
\t\t(lib_id "Interposer:Weep_Moat_Sensor")
\t\t(at 170.0 130.0 0)
\t\t(unit 1)
\t\t(exclude_from_sim no)
\t\t(in_bom yes)
\t\t(on_board yes)
\t\t(dnp no)
\t\t(fields_autoplaced yes)
\t\t(uuid "{new_uuid()}")
\t\t(property "Reference" "W1" (at 170.0 121.0 0) (effects (font (size 1.27 1.27))))
\t\t(property "Value" "Weep_Moat_Sensor" (at 170.0 123.54 0) (effects (font (size 1.27 1.27))))
\t\t(property "Footprint" "" (at 170.0 130.0 0) (hide yes) (effects (font (size 1.27 1.27))))
\t\t(property "Datasheet" "~" (at 170.0 130.0 0) (hide yes) (effects (font (size 1.27 1.27))))
\t\t(property "Description" "Perimeter Moisture & Leak Detection Sensor Moat (r=11mm)" (at 170.0 130.0 0) (hide yes) (effects (font (size 1.27 1.27))))
\t\t(pin "1" (uuid "{new_uuid()}"))
\t\t(pin "2" (uuid "{new_uuid()}"))
\t)

\t(symbol
\t\t(lib_id "Interposer:Fluidic_Port_PassThrough")
\t\t(at 320.0 45.0 0)
\t\t(unit 1)
\t\t(exclude_from_sim no)
\t\t(in_bom yes)
\t\t(on_board yes)
\t\t(dnp no)
\t\t(fields_autoplaced yes)
\t\t(uuid "{new_uuid()}")
\t\t(property "Reference" "P1" (at 320.0 37.0 0) (effects (font (size 1.27 1.27))))
\t\t(property "Value" "Port_Cis_In_30deg" (at 320.0 39.54 0) (effects (font (size 1.27 1.27))))
\t\t(property "Footprint" "" (at 320.0 45.0 0) (hide yes) (effects (font (size 1.27 1.27))))
\t\t(property "Datasheet" "~" (at 320.0 45.0 0) (hide yes) (effects (font (size 1.27 1.27))))
\t\t(property "Description" "D=2.0mm Microfluidic Pass-Through Port (Cis Inlet, 30 deg, r=20mm)" (at 320.0 45.0 0) (hide yes) (effects (font (size 1.27 1.27))))
\t\t(pin "1" (uuid "{new_uuid()}"))
\t)

\t(symbol
\t\t(lib_id "Interposer:Fluidic_Port_PassThrough")
\t\t(at 320.0 70.0 0)
\t\t(unit 1)
\t\t(exclude_from_sim no)
\t\t(in_bom yes)
\t\t(on_board yes)
\t\t(dnp no)
\t\t(fields_autoplaced yes)
\t\t(uuid "{new_uuid()}")
\t\t(property "Reference" "P2" (at 320.0 62.0 0) (effects (font (size 1.27 1.27))))
\t\t(property "Value" "Port_Cis_Out_330deg" (at 320.0 64.54 0) (effects (font (size 1.27 1.27))))
\t\t(property "Footprint" "" (at 320.0 70.0 0) (hide yes) (effects (font (size 1.27 1.27))))
\t\t(property "Datasheet" "~" (at 320.0 70.0 0) (hide yes) (effects (font (size 1.27 1.27))))
\t\t(property "Description" "D=2.0mm Microfluidic Pass-Through Port (Cis Outlet, 330 deg, r=20mm)" (at 320.0 70.0 0) (hide yes) (effects (font (size 1.27 1.27))))
\t\t(pin "1" (uuid "{new_uuid()}"))
\t)

\t(symbol
\t\t(lib_id "Interposer:Fluidic_Port_PassThrough")
\t\t(at 320.0 105.0 0)
\t\t(unit 1)
\t\t(exclude_from_sim no)
\t\t(in_bom yes)
\t\t(on_board yes)
\t\t(dnp no)
\t\t(fields_autoplaced yes)
\t\t(uuid "{new_uuid()}")
\t\t(property "Reference" "P3" (at 320.0 97.0 0) (effects (font (size 1.27 1.27))))
\t\t(property "Value" "Port_Trans_In_210deg" (at 320.0 99.54 0) (effects (font (size 1.27 1.27))))
\t\t(property "Footprint" "" (at 320.0 105.0 0) (hide yes) (effects (font (size 1.27 1.27))))
\t\t(property "Datasheet" "~" (at 320.0 105.0 0) (hide yes) (effects (font (size 1.27 1.27))))
\t\t(property "Description" "D=2.0mm Microfluidic Pass-Through Port (Trans Inlet, 210 deg, r=20mm)" (at 320.0 105.0 0) (hide yes) (effects (font (size 1.27 1.27))))
\t\t(pin "1" (uuid "{new_uuid()}"))
\t)

\t(symbol
\t\t(lib_id "Interposer:Fluidic_Port_PassThrough")
\t\t(at 320.0 130.0 0)
\t\t(unit 1)
\t\t(exclude_from_sim no)
\t\t(in_bom yes)
\t\t(on_board yes)
\t\t(dnp no)
\t\t(fields_autoplaced yes)
\t\t(uuid "{new_uuid()}")
\t\t(property "Reference" "P4" (at 320.0 122.0 0) (effects (font (size 1.27 1.27))))
\t\t(property "Value" "Port_Trans_Out_150deg" (at 320.0 124.54 0) (effects (font (size 1.27 1.27))))
\t\t(property "Footprint" "" (at 320.0 130.0 0) (hide yes) (effects (font (size 1.27 1.27))))
\t\t(property "Datasheet" "~" (at 320.0 130.0 0) (hide yes) (effects (font (size 1.27 1.27))))
\t\t(property "Description" "D=2.0mm Microfluidic Pass-Through Port (Trans Outlet, 150 deg, r=20mm)" (at 320.0 130.0 0) (hide yes) (effects (font (size 1.27 1.27))))
\t\t(pin "1" (uuid "{new_uuid()}"))
\t)

\t(label ">PORE_AMP" (at 44.76 86.35 180) (effects (font (size 1.27 1.27))))
\t(label "GUARD" (at 44.76 83.81 180) (effects (font (size 1.27 1.27))))
\t(label "GNDA" (at 44.76 81.27 180) (effects (font (size 1.27 1.27))))
\t(label "WEEP_SENSE" (at 44.76 78.73 180) (effects (font (size 1.27 1.27))))
\t(label "GUARD_TRANS" (at 44.76 76.19 180) (effects (font (size 1.27 1.27))))
\t(label "Vbias" (at 44.76 73.65 180) (effects (font (size 1.27 1.27))))

\t(label ">PORE_AMP" (at 170.0 67.3 270) (effects (font (size 1.27 1.27))))
\t(label "Vbias" (at 170.0 92.7 90) (effects (font (size 1.27 1.27))))

\t(label ">PORE_AMP" (at 237.3 51.27 180) (effects (font (size 1.27 1.27))))
\t(label "GUARD" (at 237.3 47.46 180) (effects (font (size 1.27 1.27))))
\t(label ">PORE_AMP" (at 237.3 76.27 180) (effects (font (size 1.27 1.27))))
\t(label "GUARD" (at 237.3 72.46 180) (effects (font (size 1.27 1.27))))

\t(label "Vbias" (at 237.3 111.27 180) (effects (font (size 1.27 1.27))))
\t(label "GUARD_TRANS" (at 237.3 107.46 180) (effects (font (size 1.27 1.27))))
\t(label "Vbias" (at 237.3 136.27 180) (effects (font (size 1.27 1.27))))
\t(label "GUARD_TRANS" (at 237.3 132.46 180) (effects (font (size 1.27 1.27))))

\t(label "WEEP_SENSE" (at 158.57 132.54 180) (effects (font (size 1.27 1.27))))
\t(label "GNDA" (at 158.57 127.46 180) (effects (font (size 1.27 1.27))))

\t(label "FLUID_CIS_IN" (at 320.0 39.92 90) (effects (font (size 1.27 1.27))))
\t(label "FLUID_CIS_OUT" (at 320.0 64.92 90) (effects (font (size 1.27 1.27))))
\t(label "FLUID_TRANS_IN" (at 320.0 99.92 90) (effects (font (size 1.27 1.27))))
\t(label "FLUID_TRANS_OUT" (at 320.0 124.92 90) (effects (font (size 1.27 1.27))))
)
"""
    sch_path.write_text(sch, encoding="utf-8")
    print(f"Generated schematic: {sch_path}")

if __name__ == "__main__":
    generate_symbol_library()
    update_sym_lib_table()
    build_schematic()
