EpicQuestBio/MR1/(commit log)

2025-12-23 Add Sentinel Nanopore Reader Rev 11 SCAD file
    - Create `sentinel_nanopore_reader.scad` with the provided Rev 11 design.
    - Optimize housing generation by replacing expensive `minkowski` sum with `linear_extrude` + `offset`.
    - Fix threading incompatibility between Housing and Torque Cap by unifying on BOSL2 `threaded_rod` with a 20mm pitch.
    [sentinel_nanopore_reader.scad]
2025-12-23 Refactor Sentinel Nanopore Reader to use BOSL2 attachments
    - Update `Housing_3D` to use `cuboid` and `cyl` with `attach`, `position`, `diff`, and `tag` for cleaner geometry definition and positioning.
    - Update `Cartridge_Stack_3D` to use recursive `attach(TOP)` for stacking plates and gaskets, removing manual Z-offset calculations.
    - Update `Torque_Cap_Inner` to use `cyl` and `attach` for the main body and ratchet teeth.
    - Standardize thread pitch to 20mm across Housing and Cap to ensure mechanical compatibility.
    - Remove unused legacy `ScrewThread` module.
    [sentinel_nanopore_reader.scad]
2025-12-23 Add mounting feet with M3 insert holes to housing
    - Add 4x cylindrical feet (10mm diameter, 5mm height) to the bottom corners of the housing.
    - Add 4.2mm diameter, 8mm deep holes to the feet for M3 heat-set inserts.
    - Utilize BOSL2 attachment system for robust positioning.
    [sentinel_nanopore_reader.scad]
2025-12-23 Add feet with M3 inserts and square Interposer to housing
    - Add 4x mounting feet to the housing bottom with M3 insert holes (d=4.2mm, h=8mm).
    - Implement `Interposer` module for a square disposable card.
    - Update `Plate_2_Channel` to accept the square Interposer in its pocket.
    - Refactor `Housing_3D` and `Torque_Cap_Inner` to use BOSL2 attachments and primitives.
    - Ensure Housing internal mounts are correctly preserved.
    - Standardize thread pitch to 20mm for compatibility.
    [sentinel_nanopore_reader.scad]
2025-12-23 Redesign housing as split Case/Lid, add feet/interposer
    - Split `Housing_3D` into `Housing_Case` (bottom bucket) and `Housing_Lid` (top plate) to improve 3D printability and allow for a sealed chamber.
    - Add 4x mounting feet to `Housing_Case` with M3 heat-set insert holes.
    - Integrate square `Interposer` module and update `Plate_2_Channel` pocket.
    - Refactor Housing and Cap to use BOSL2 attachments and primitives.
    - Restore internal mounts for Pump and PCB on the Case floor.
    - Standardize thread pitch to 20mm for Torque-Lock mechanism.
    - Add export targets for `Housing_Case_STL` and `Housing_Lid_STL`.
    [sentinel_nanopore_reader.scad]
2025-12-23 Redesign housing, add PCB/Pogo support, split case
    - Split enclosure into `Housing_Case` and `Housing_Lid` for printability and sealing.
    - Add mounting feet to Case with M3 insert holes (d=4.2mm).
    - Mount PCB to underside of Lid with 1mm standoffs.
    - Add Interposer module and update `Plate_2_Channel` pocket.
    - Orient Interposer pads downwards and add pogo pin access holes through Lid and Base Plate.
    - Refactor geometry to use BOSL2 attachments.
    - Standardize thread pitch to 20mm.
    [sentinel_nanopore_reader.scad]
2025-12-23 Finalize Sentinel Nanopore Reader: Split Housing, Interposer, PCB DXF
    - Redesign housing as split Case/Lid for printability and sealing.
    - Mount PCB to Lid underside (1mm standoffs) with pogo pin access.
    - Integrate square Interposer module and update stack.
    - Implement `PCB_DXF` export mode with 2D projection.
    - Refactor to use BOSL2 attachments.
    - Fix thread pitch mismatch (unified to 20mm).
    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
    [sentinel_nanopore_reader.scad]
2025-12-23 Refine gasket sealing and fix lid geometry
    - Update `Gasket_Main` to improve sealing by restricting the central fluid cavity to the chip area and adding individual penetration holes for pogo pins.
    - Fix `Housing_Lid` neck bore logic to preserve the interface shelf and prevent the stack from falling through.
    - Enable `Explode_Factor` for the Housing Lid in assembly view.
    - Finalize the split Housing design with sealed chamber and pogo pin access.
    [sentinel_nanopore_reader.scad]
2025-12-23 Add support for 1/4 inch NPT compression fittings to Housing_Lid and introduce Bottom_Pusher_Plate
    - Modified `Housing_Lid` to replace the central cutout with a solid shelf.
    - Added 4x bosses on the underside of `Housing_Lid` with 1/4" NPT threads (approx).
    - Created `Bottom_Pusher_Plate` module (TPU) with O-ring seats for sealing.
    - Updated cartridge stack (`Plate_1`, `Plate_2`, `Plate_3`, `Gasket`) to support 4 fluid ports (Bottom Flush & Top Flush).
    - Updated port radius to 20mm and angles to ±30°/150°/210° to fit larger fittings.
    - Added `Bottom_Pusher_Plate_STL` to output options.
    [sentinel_nanopore_reader.scad]
2025-12-23 Update sentinel_nanopore_reader.scad
    minor typos
    [sentinel_nanopore_reader.scad]
2025-12-24 lots of ajdustment
    [sentinel_nanopore_reader.scad]
2025-12-24 Integrate 12V peristaltic pumps and external fluid ports
    - Added `Peristaltic_Pump_12V` module modeling Diitao-style 12V dosing pumps.
    - Updated `Housing_Case` to replace NEMA17 mount with dual sockets for the new pumps.
    - Added 4x 1/4" NPT threaded ports to `Housing_Case` exterior walls for buffer/sample/waste connections.
    - Implemented `Sealed_Top_Mode` in `Plate_3_Top` to allow for a closed fluid system without pipette access.
    - Updated assembly visualization to show pump placement and tubing routing.
    [sentinel_nanopore_reader.scad]
2025-12-24 Refactor pogo pin holes to use function call
    Removed inline definition of pogo pin penetration holes and replaced with a function call.
    [sentinel_nanopore_reader.scad]
2025-12-24 Refactor into modular Pump and Reader units
    - Split monolithic housing into `Housing_Pump_Case/Lid` (Bottom) and `Housing_Reader_Case/Lid` (Top).
    - Implemented modular stacking with male/female interlock features.
    - Pump Module:
    - Supports 2x 12V Diitao Peristaltic Pumps on a swappable plate.
    - Side-exit 1/4" NPT threaded fluid ports (Left In, Right Out).
    - Back panel cutouts for DIN 5 (MIDI) and Barrel Jack.
    - Reader Module:
    - Reduced height base for stack/PCB only.
    - Thickened Lid with horizontal side-exit fluid ports.
    - Back panel cutouts for DIN 5 (MIDI) and Barrel Jack.
    - Added `Sealed_Top_Mode` to `Plate_3_Top`.
    - Updated assembly visualization with tubing loops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
    [sentinel_nanopore_reader.scad]
2025-12-25 feat: add TODO.md and fix pogo pin gasket path
    - Created TODO.md with tasks identified from code comments.
    - Fixed pogo pin path in `sentinel_nanopore_reader.scad` by enabling pogo holes for Gasket 1 (below interposer) and disabling them for Gasket 2.
    - Simplified Interposer rotation logic in `sentinel_nanopore_reader.scad` to use `rotate([0, 180, 0])` and removed verbose comments.
    - Marked completed items in TODO.md.
    [sentinel_nanopore_reader.scad]
2025-12-25 Correct BOSL2 attach coordinates for ports and connectors
    Fixed floating components and failing boolean operations by:
    1. Removing incorrect Z-axis offsets (`pump_h/2`, `lid_thick/2`) in `attach()` blocks that caused ports to detach from walls.
    2. Removing incorrect rotations (`rotate([0,90,0])`, `rotate([90,0,0])`) to ensure ports and cutouts align with the surface normal.
    3. Standardizing side port translations.
    This resolves issues with "ghost holes" (red cylinders) failing to cut the housing and fluid ports floating in mid-air.
    [sentinel_nanopore_reader.scad]
2025-12-26 Refactor Housing_Lid_Reader to protect internal features from bucket subtraction
    Restructures the Housing_Lid_Reader module to use a `union()` of the shell (with its subtractive features like the internal bucket and pogo holes) and the additive internal features (PCB mounts and corner posts). This prevents the `diff("remove")` operation on the bucket from unintentionally deleting the standoffs and mounting posts that reside within its volume. Also corrects the Z-positioning of the corner mounting holes to be flush with the lid body.
    [sentinel_nanopore_reader.scad]
2025-12-29 Refine fluid routing in Housing_Lid_Reader
    - Replaced vertical pass-through fluid ports with internal routing channels connecting side ports to the central manifold.
    - Updated `Housing_Lid_Reader` to include a 10mm thick solid ceiling for the channels.
    - Parametrically routed channels to avoid pogo pin and vertical shaft collisions.
    - Updated external tubing visualization to match new port locations.
    - Marked TODO item as complete.
    [sentinel_nanopore_reader.scad]
2025-12-30 Implement Hexagonal Cartridge Stack with Kelvin Sensing Carrier
    - Added hexagonal geometry constants and modules: `Plate_1_Base_Hex`, `Carrier_Frame_Hex`, `Plate_3_Top_Hex`, `Gasket_Hex`.
    - Implemented `PCB_Kelvin_Insert` with 5-pin linear layout and annular ground ring.
    - Updated `Housing_Lid_Reader` to feature a hexagonal self-indexing socket and 5-pin pogo pin routing.
    - Corrected pogo pin access to be Top-Down (Lid -> Top Plate -> Gasket -> PCB).
    - Updated `Cartridge_Stack_3D` assembly to use new hexagonal components.
    - Updated export modes for manufacturing.
    [sentinel_nanopore_reader.scad]
2025-12-30 Implement Hexagonal Cartridge Stack with Potted Kelvin Carrier
    - Refactored cartridge stack components to Hexagonal geometry (60mm diameter).
    - Implemented `PCB_Kelvin_Insert` with central potting puck, mesh, and silver ribbon electrodes.
    - Updated `Carrier_Frame_Hex` to house the rectangular PCB insert.
    - Updated `Housing_Lid_Reader` with hexagonal socket for self-indexing and 5-pin linear pogo layout.
    - Added `O_Ring_Inner` modules for sealing the potting puck.
    - Corrected assembly logic for Top-Down pogo pin access.
    - Updated exports for all new components.
    [sentinel_nanopore_reader.scad]
2026-01-01 Implement Low Dead Volume Gasket geometry
    Replaced the open-cavity Gasket_Hex with a new Gasket_Low_Dead_Volume module.
    This new module implements a "race track" slot channel connecting the inlet/outlet ports (at R=20mm) directly to the central chip area, minimizing dead space and ensuring flow-through flushing.
    Updated Plate_1_Base_Hex and Plate_3_Top_Hex to remove engraved channels, relying on the gasket for fluid routing.
    Updated Cartridge_Stack_3D to use the new gaskets for Top and Bottom layers.
    [sentinel_nanopore_reader.scad]
2026-01-01 Refactor: Integrate Rev 19 Rigid Active Cartridge into Hexagonal Stack
    - Replaced `PCB_Kelvin_Insert` with `PCB_Rigid_Active` (0.8mm FR4, OpAmp geometry).
    - Updated `Carrier_Frame_Hex` to 2.6mm thickness (was 4mm) with a through-hole pocket for the new PCB.
    - Updated `Cartridge_Stack_3D` assembly to use the new carrier thickness and PCB module.
    - Extended `Pressure_Puck_3D` by 1.4mm to compensate for the reduced stack height, ensuring the Torque Cap clamps correctly.
    - Added global configuration variables (`pcb_thick`, `carrier_thick`, `opamp_h`, `Show_Components`).
    - Updated `Output_Mode` references implicitly (by replacing logic inside the stack module).
    [sentinel_nanopore_reader.scad]
2026-01-01 Merge branch 'main' of git@github.com:LokiMetaSmith/daemon-pore.git
    added kicad files
    # Conflicts:
    # sentinel_nanopore_reader.scad
    [Ignition.kicad_sch, Insturmentation.kicad_sch, MR1.kicad_pcb, MR1.kicad_sch, Microcontroller.kicad_sch, Power.kicad_sch]
2026-01-01 minor update, lots of little changes,
    [sentinel_nanopore_reader.scad]
2026-01-01 Define plate_thick_pp and stack_z in Cartridge_Stack_3D
    These variables were undefined, causing compilation warnings and errors in OpenSCAD.
    Assigned `plate_thick_pp = 3` (matching Bottom_Pusher_Plate height) and `stack_z = -3`
    (offsetting the stack base).
    [sentinel_nanopore_reader.scad]
2026-01-01 Fix Bottom_Pusher_Plate O-rings and refactor code.
    - Updated `Bottom_Pusher_Plate` to include integrated O-ring generation (visual).
    - Defined clear dimensions for port O-rings (d_maj=8, cs=1.5).
    - Added `show_orings` parameter to control visibility, defaulting to `Show_O_Rings`.
    - Disabled O-rings for STL export of the plate.
    - Removed deprecated/broken manual O-ring placement in `Cartridge_Stack_3D`.
    [sentinel_nanopore_reader.scad]
2026-01-01 Fix visibility of O-Rings in Bottom_Pusher_Plate
    Refactor `Bottom_Pusher_Plate` to separate the visual O-Ring generation from the main differenced body.
    This ensures that the O-Rings (additive) are not subtracted by the O-Ring seats (subtractive) which occupy the same volume.
    - Wrap `diff("remove")` block and O-Ring block in a `union()`.
    - Replicate positioning logic for O-Rings using explicit translations.
    [sentinel_nanopore_reader.scad]
2026-01-08 Add KiCad specific patterns to .gitignore
2026-01-08 Implement Single-Sided PCBA with Trans Loop and Sloped Roof
    - Updated `PCB_Rigid_Active` to replace pogo pin pads with 4 bottom-side solder pads (Trans/Cis).
    - Modified `Gasket_Low_Dead_Volume` (Bottom) to include isolated openings for the Chip (Center) and Trans Loop (Y=-10).
    - Replaced `Plate_1_Base_Hex` with `Plate_1_Base_Hex_3D` to implement the 3D Trans fluid routing:
    - Inlet -> Up Via -> Pad Contact -> Down Via -> Center.
    - Implemented "Sloped Roof" channel from Center to Outlet using a rising floor geometry (Z-profile rises towards exit) to clear bubbles.
    - Removed Pogo Pin holes from all stack modules.
    [sentinel_nanopore_reader.scad]
2026-01-09 Refactor cartridge to Split PCB design (Round Carrier + Hex Amp)
    - Replaces single hex PCB with a 20mm Round Nanopore Carrier nested in a Hexagonal Amplifier Board.
    - Adds tabs to the Amplifier Board protruding into the Carrier for sense probe connection.
    - Implements a vertical Cable Slot (5x12mm) running through the entire stack (Plate 1, Gaskets, Reader Lid) for JST cable routing, replacing pogo pins.
    - Updates Top Gasket and Plate 3 to have large cutouts for Amplifier components.
    - Adds DIN 5 and USB-C panel mount ports to Reader Module housing.
    - Updates Pump Module housing with DIN 5, USB-C, and Barrel Jack ports.
    - Updates PCB_2D projection for manufacturing.
    [sentinel_nanopore_reader.scad]
2026-01-09 Refactor Sentinel Nanopore Reader OpenSCAD code into modular files
    This change breaks down the monolithic `sentinel_nanopore_reader.scad` file into smaller, more manageable modules:
    - `constants.scad`: Global variables and BOSL2 includes.
    - `modules/common.scad`: Shared utility modules.
    - `modules/cartridge.scad`: Cartridge stack components.
    - `modules/housing_pump.scad`: Pump module housing.
    - `modules/housing_reader.scad`: Reader module housing.
    - `modules/torque_cap.scad`: Torque cap components.
    The main file now includes these modules to assemble the final model.
    [cartridge.scad, common.scad, constants.scad, housing_pump.scad, housing_reader.scad, sentinel_nanopore_reader.scad, torque_cap.scad]
2026-01-15 Refactor cartridge stack and cap for modularity and robustness
    - Centralize stack dimensions and thread parameters in `constants.scad`.
    - Implement dynamic calculation of `total_stack_height` and `neck_h` to ensure the cap always fits the stack.
    - Update `Cartridge_Stack_3D` in `modules/cartridge.scad` to use explicit, cumulative Z-stacking based on component thicknesses.
    - Change Torque Cap thread pitch to 4mm for better printability.
    - Update `Housing_Lid_Reader` side ports to use 1/4" NPT threads.
    - Ensure the stack sits flush on the Reader Lid surface.
    [cartridge.scad, constants.scad, housing_reader.scad, torque_cap.scad]
2026-01-15 Refactor cartridge stack and cap for modularity and robustness
    - Update `Cartridge_Stack_3D` in `modules/cartridge.scad` to use BOSL2 attachment chains for robust relative positioning.
    - Fix child propagation in stack modules to ensure full assembly rendering.
    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
    [cartridge.scad]
2026-01-15 Fix BOSL2 attachment chain error in Cartridge Stack
    Refactored Cartridge_Stack_3D to use dedicated modules for Gasket and PCB layers that correctly implement BOSL2 parent geometry propagation.
    - Updated Gasket_Low_Dead_Volume_3D to include children() to allow subsequent attachments.
    - Created PCB_Active_Stack_3D to provide a robust attachment context (using a phantom cylinder) for the PCB/Carrier layer, replacing the error-prone inline attachable block.
    - Ensures all layers in the stack provide valid $parent_geom for attach(TOP) operations.
    [cartridge.scad]
2026-01-15 Fix Cartridge Stack colors and attachments
    Refactored `PCB_Active_Stack_3D` and `Gasket_Low_Dead_Volume_3D` to use the BOSL2 `attachable` wrapper correctly.
    - `PCB_Active_Stack_3D`: Uses `attachable` to define a phantom attachment geometry while rendering only the internal PCB components. This prevents a solid cylinder from obscuring the components and restoring their colors.
    - `Gasket_Low_Dead_Volume_3D`: Moves the `children()` call outside the internal `diff` block, placing it as a direct child of `attachable`. This ensures robust attachment propagation and prevents unnecessary re-rendering of the stack within the `diff` scope.
    - Restores proper color visibility for the Cartridge Stack ass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
    [cartridge.scad]
2026-01-16 Add pump housing handle and fix reader/pump alignment
    - Add integral coffee mug handle to Housing_Pump_Case front face.
    - Replace Pump Lid male interlocks with female dimples to prevent collision.
    - Replace Reader Case female recesses with threaded sensor feet to align with new dimples.
    - Ensure feet length (2.8mm) fits within dimple depth (3.0mm) for proper resting.
    [housing_pump.scad, housing_reader.scad]
2026-01-17 Fix undefined `cap_h` warning in Torque Cap modules
    - Moved `cap_h` definition to `constants.scad` to make it globally accessible.
    - Removed local `cap_h` definition from `Torque_Cap_Inner` in `modules/torque_cap.scad` to avoid redundancy.
    - This resolves warnings where `Torque_Cap_Outer` was trying to use `cap_h` without it being defined.
    [constants.scad, torque_cap.scad]
2026-01-17 Make cap_h dynamic based on thread height
    - Updated `constants.scad`:
    - Removed static `cap_h = 30;` definition.
    - Added `cap_h = neck_h + 5;` after `neck_h` definition.
    - This ensures the cap height scales automatically with the neck height (thread height), as requested.
    [constants.scad]
2026-01-18 Update PCB position to be on top of the lid and remove mounting holes
    [cartridge.scad, housing_reader.scad]
2026-01-18 Fix Torque Cap alignment and height
    - Updated `Torque_Cap_Outer` to use dynamic `cap_h` for shell height and component positioning.
    - Aligned spring arms (ribs) to the center of the cap height (`cap_h / 2`) and set their height to `cap_h`.
    - Fixed `Torque_Cap_Inner` ratchet teeth alignment by changing anchor to `BOTTOM`.
    [torque_cap.scad]
2026-01-18 Bump recessed feet outwards in Pump Lid and Reader Case
    Updated the position of the alignment feet (Reader) and dimples (Pump Lid)
    to be 2.5mm closer to the corners (from offset 15mm to 12.5mm).
    This improves visibility and clearance with internal pumps.
    Introduced `feet_inset` constant in `constants.scad` for shared configuration.
    [constants.scad, housing_pump.scad, housing_reader.scad]
2026-01-18 Split Reader Module Lid ports to 2-Left/2-Right and align to Pump Case
    [housing_reader.scad]
2026-01-18 Fix floating PCB standoffs in Housing_Lid_Reader
    - Moved standoffs from rim level (-lid_thick) to ceiling level (-ceiling_thick).
    - Removed rotation to ensure correct downward orientation from ceiling.
    - Fixed screw hole attachment to properly cut into the standoff from the bottom.
    [housing_reader.scad]
2026-01-18 Duplicate connectivity ports from Pump Case to Reader Lid
    Duplicates the MIDI, USB-C, and Barrel Jack cutouts from the Pump Case Back Wall to the Housing Lid Reader Right Side.
    - Duplicated the `attach` block.
    - Changed `attach(BACK)` to `attach(RIGHT)`.
    - Removed `rotate([90,0,0])` from shapes to align correctly with the Right face normal (X-axis).
    - Zeroed Z-translations to center the ports on the face.
    - Verified `wall` variable availability.
    [housing_reader.scad]
2026-01-18 Move Reader Lid connectivity ports to Back face and deepen them
    - Modified `Housing_Lid_Reader` in `modules/housing_reader.scad` to attach connectivity ports (DIN, USB, Barrel) to the `BACK` face (positive Y) instead of `RIGHT`.
    - Increased the depth of these cutouts to `wall*10` to ensure they penetrate the internal bucket wall.
    - Updated `tests/render_test.js` to correctly load `constants.scad` and the `modules` directory for WASM-based testing.
    - Verified syntax validity through partial test execution.
    [housing_reader.scad]
2026-01-18 feat: Add retention lip and adjust height for Torque Cap
    - Introduced `cap_top_thick` (5mm), `cap_retention_h` (2mm), and `cap_inner_h` (calculated) to `constants.scad`.
    - Updated `Torque_Cap_Inner`:
    - Adjusted height to `cap_inner_h` to prevent collision with the outer cap lid.
    - Added a retention flange (`d=neck_od + 7`) at the bottom.
    - Raised ratchet teeth to start above the retention flange (`z=cap_retention_h`) and end at the top of the cap (`h=cap_inner_h - cap_retention_h`).
    - Updated `Torque_Cap_Outer`:
    - Added a retention lip at the bottom opening (`d=neck_od + 6`) to trap the inner cap.
    - Adjusted internal clearance to accommodate the new geometry.
    [constants.scad, torque_cap.scad]
2026-01-18 Fix visibility of cartridge stack components by correcting attachment scope in Plate 1
    The BOSL2 attachment chain was broken at `Plate_1_Base_Hex_3D` because the `children()` call was inadvertently placed inside a `tag("remove")` block. This caused all subsequent attached components (Gaskets, PCB, Top Plate) to be treated as subtractive geometry, rendering them invisible.
    This commit moves the `children()` call outside the `tag("remove")` block, ensuring that the attached components are correctly rendered as additive geometry. This fixes the missing gaskets, nanopore carrier, and active PCB in the assembly view.
    [cartridge.scad]
2026-01-18 Refactor PCB_Active_Stack_3D to remove union wrapper
    Replaced the explicit union() around Nanopore_Carrier and PCB_Rigid_Active with a helper module PCB_Active_Stack_Parts. This allows the two boards to exist as separate objects in the OpenSCAD tree while satisfying the BOSL2 attachable() requirement for exactly two children (geometry and attachments). Verified with focused render test.
    [cartridge.scad]
2026-01-18 Rotate and position Pump Module ports for correct wall penetration
    Rotated the DIN 5, USB-C, and Barrel Jack ports on the Housing_Pump_Case back wall to align with the wall normal (removing the previous 90-degree rotation). Updated their translations to center them on the wall thickness, ensuring they correctly penetrate the housing rather than floating outside.
    [housing_pump.scad]
2026-01-18 Fix Torque Cap teeth Z-position and Outer Cap detent clearance
    - Fixed Z-position of teeth to start above the retention flange (`cap_retention_h`).
    - Corrected radial position and orientation of teeth to prevent embedding in the thread wall.
    - Adjusted Spring Arms to start 1mm above the retention lip to prevent collision.
    - Added a `tag("remove")` cutout slot around the arms to ensure they can flex.
    - Maintained correct radial engagement with inner teeth.
    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
    [torque_cap.scad]
2026-01-18 Fix missing colors in cartridge stack components
    Refactored `Bottom_Pusher_Plate` to use `attachable()` explicitly, isolating geometry color from attachment children.
    Moved `color("Red")` inside `Gasket_Low_Dead_Volume_3D` to scope it correctly to the gasket geometry.
    Added explicit `color("White", 0.4)` to `Plate_1_Base_Hex_3D` and `Plate_3_Top_Hex`.
    [cartridge.scad, repro_colors.scad]
2026-01-18 Fix Pump Module port penetration depth
    Increased the cut depth for DIN, USB-C, and Barrel Jack ports on the Housing_Pump_Case from wall*3 to wall*10. This ensures the cutouts fully penetrate the thick wall of the housing, resolving the issue where ports were only partially cutting or floating. Oriented perpendicular to the wall.
    [housing_pump.scad]
2026-01-18 Update Reader and Pump housing with thinner profile, reinforced walls, and O-ring sealing.
    - Reduced `reader_h` to 28mm and `pump_h` to 65mm.
    - Increased `wall` thickness to 5mm to accommodate internal screw holes.
    - Added self-indexing lips (2.5mm deep) to both lids for better alignment.
    - Implemented O-ring groove in lids and knife-edge seal on cases (radius 0.3mm).
    - Relocated screw holes to corners and adjusted seal path to `base_w - 8` to prevent interference.
    - Fixed BOSL2 `tube()` usage by replacing with `difference()` of cuboids.
    [constants.scad, housing_pump.scad, housing_reader.scad, test_render.scad, test_verify.scad]
2026-01-18 Update silicone gasket dimensions for squish compensation
    - Modified `Gasket_Low_Dead_Volume` in `modules/cartridge.scad` to use 1.2mm channels, 2.0mm ports, and 6.5mm chamber.
    - Implemented 'Dogbone' geometry for both Top and Bottom layers.
    - Added 0.5mm anti-tear fillets to all internal corners.
    [cartridge.scad]
2026-01-18 Fix stack color inheritance and add PCB fluid pass-throughs
    - Refactor `Plate_1_Base_Hex_3D` and `Plate_3_Top_Hex` in `modules/cartridge.scad` to use the `attachable` wrapper pattern. This ensures `children()` are processed outside the `color()` scope, resolving the issue where the entire stack inherited the white/transparent color of the plates ("ghost stack").
    - Add fluid port pass-through cylinders to `PCB_Rigid_Active` in `modules/cartridge.scad` to allow fluid flow through the stack, aligning with `Plate_1` and `Gasket` ports. This fixes the "wrong plate" issue where the PCB was acting as a solid blocker.
    - Verified visual stack correctness and fluid path continuity.
    [cartridge.scad]
2026-01-18 Restore gasket verification tests
    - Restored `tests/test_gasket_plan.scad` for visual verification.
    - Restored `tests/verify_gasket_integration.js` for targeted DXF rendering checks.
    [test_gasket_plan.scad]
2026-01-21 feat: Add new critical component views and testing infrastructure
    - Added new Output Modes: Gasket_Top, Gasket_Bottom, PCB_Amplifier, PCB_Nanopore_Carrier, PCB_Main_Reader.
    - Defined new modules `PCB_Amplifier_2D`, `PCB_Nanopore_Carrier_2D`, `PCB_Main_Reader_2D` to support exports.
    - Fixed `PCB_Main_Reader` to be rectangular (80x60mm) instead of hexagonal.
    - Implemented "Golden Master" visual regression framework infrastructure (size-based).
    - Added `tests/generate_golden.js` to create baseline artifacts.
    - Added `tests/verify_outputs.js` to verify regression.
    - Updated `tests/render_test.js` to integrate verification.
    [cartridge.scad, constants.scad, housing_reader.scad, sentinel_nanopore_reader.scad]
2026-01-29 Add script to export all components
    Added `scripts/export_all.js` to render all defined Output_Modes from the SCAD file.
    Updated `package.json` with an `export` script.
    Updated `README.md` with usage instructions.
    Fixed redundant `projection()` calls in `sentinel_nanopore_reader.scad` to ensure compatibility with `openscad-wasm`.
    Generated files are saved to `exports/` which is now gitignored.
    [sentinel_nanopore_reader.scad]
2026-01-29 Fix export script Windows compatibility and VFS paths
    Updated `scripts/export_all.js` to force forward slashes for Virtual File System paths, resolving `Can't open include file` errors on Windows.
    The script now correctly mounts `BOSL2` and `modules` into the WASM instance regardless of the host OS separator.
    Also confirmed redundant `projection()` calls were removed from `sentinel_nanopore_reader.scad` in the previous step.
2026-01-29 Fix export script Windows compatibility and VFS paths
    Corrected `Housing_Pump_Case` geometry to fix CGAL assertion failure.
    Added `Cable_Slot_2D` to fix mixing 2D/3D object warnings.
    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
    [cartridge.scad, common.scad, housing_pump.scad]
2026-01-30 Fix Torque Cap inner geometry: correct teeth rotation and robust retention lip
    [torque_cap.scad]
2026-01-31 Improve Torque Cap with ribbing, rounded edges, reduced thread count, and improved fingers.
    - Updated `cap_thread_pitch` in `constants.scad` to 8mm for ~3 turns.
    - Refactored `Torque_Cap_Outer` in `modules/torque_cap.scad`:
    - Added vertical ribbing (knurling).
    - Rounded top edges using BOSL2 `cyl(rounding2=5)`.
    - Replaced spring arms with cantilever fingers attached to the top bridge.
    - Widened and vertically limited slot cutouts to ensure fingers are not floating and retention ring is intact.
    [constants.scad, torque_cap.scad]
2026-01-31 Fix Torque Cap ribs/ceiling and Main PCB position
    - Remove ribs from finger slots in Torque Cap to prevent interference.
    - Add ceiling to Torque Cap by limiting internal clearance cut height.
    - Move Main Reader PCB to internal position (underside of lid) to fix visual protrusion.
    [housing_reader.scad, torque_cap.scad]
2026-01-31 Fix invisible data and fluid ports in Reader Housing
    - Modify `Housing_Case_Reader` connectivity ports (MIDI, USB-C) to remove incorrect `rotate([90,0,0])` and Z-offset, ensuring they cut through the back wall.
    - Increase cut depth of `Housing_Case_Reader` connectivity ports to `wall*10` for consistency.
    - Increase cut depth of `Housing_Lid_Reader` side fluid ports (`threaded_rod`) from 15mm to 30mm to ensure full penetration through the housing wall and internal structures.
    [housing_reader.scad]
2026-01-31 Move housing screw holes to base_w/2 to fix corner breakout.
    [housing_pump.scad, housing_reader.scad]
2026-01-31 Update Housing_Pump_Case handle to D-shape for improved ergonomics
    [housing_pump.scad]
2026-01-31 Rotate pump ports to horizontal alignment and fix blue tube routing
    - Modified `modules/housing_pump.scad`: Changed port generation loop to use `x_pos` (horizontal) instead of `y_pos` (vertical) on Left/Right faces, aligning them at Y=+/-20mm.
    - Modified `sentinel_nanopore_reader.scad`: Updated the "DeepSkyBlue" external tubing visualization to route around the back of the device, preventing clipping through the housing case.
    - Verified changes by compilation and code review.
    [housing_pump.scad, sentinel_nanopore_reader.scad]
2026-01-31 Fix Torque Cap spikes and update fluid tubing routing
    - Updated `constants.scad` to reduce `cap_inner_h` (increased clearance from 1mm to 3mm) to prevent inner cap ratchet teeth from clipping through the outer cap.
    - Updated `sentinel_nanopore_reader.scad` to route the blue visual tubing from Pump Right to Reader Right, matching the logical port configuration and fixing the wrap-around artifact.
    - Removed the arbitrary `-2mm` Z-offset for `Torque_Cap_Outer` in `modules/housing_reader.scad` to align the cap assembly correctly.
    [constants.scad, housing_reader.scad, sentinel_nanopore_reader.scad]
2026-01-31 Refine PCB geometry and mounting to clear housing ports
    - Move PCB mounting standoffs and holes outwards (5mm -> 2mm offset) to maximize available board area.
    - Add cutouts to `PCB_Main_Reader_2D` on the back edge to prevent interference with DIN 5, USB-C, and Barrel Jack panel mount connectors.
    - Verify changes by exporting `PCB_Main_Reader_DXF`.
    [housing_reader.scad, verify_pcb_clearance.scad]
2026-01-31 Fix torque cap triangle protrusion by increasing inner cap clearance.
    Increased the `cap_inner_h` subtraction offset from 3mm to 5mm in `constants.scad`. This ensures that the inner cap (including ratchet teeth and threading) is 2mm shorter, providing sufficient clearance below the outer cap ceiling to prevent the torque triangles from protruding through the top surface. The relative alignment of teeth and threading is preserved as both use the same height variable.
    [constants.scad]
2026-02-01 Refine Plate 3 cutout to strictly conform to PCB component layout
    Replaces the generic convex hull cutout in `Plate_3_Top_Hex` with a precise union of hulls targeting the Top OpAmp and Bottom Component Cluster (JST, OpAmp 2, Filters). This ensures the cutout "hugs" the components as requested, providing better structural coverage while maintaining necessary clearance.
    Calculated component bounds from `PCB_Rigid_Active` and applied ~1mm clearance.
    [cartridge.scad]
2026-02-01 Update PCB stack visualization and components
    - Modify `PCB_Active_Stack_Parts` to explode the Nanopore Carrier away from the PCB when `Explode_Factor` is used.
    - Update `PCB_Rigid_Active` component placement:
    - Center OpAmp near carrier.
    - Move passive components to connector side (-Y).
    - Ensure all top components sit flush on the PCB surface (`pcb_thin`).
    - Adjust JST connector to sit on top of the PCB.
    - Replace old contact pads with 4 new pads aligned to the liquid pathway (-30 deg):
    - 2 Gold pads on top surface.
    - 2 Silver pads on bottom surface.
    [cartridge.scad]
2026-02-01 Replace additive handle tabs with subtractive finger grip cutouts on Pressure Puck and align them across all stack layers.
    - Modified `Pressure_Puck_3D` to remove the additive cylinders and add subtractive cutouts.
    - Defined `Finger_Grip_Cutout` (3D) and `Finger_Grip_Cutout_2D` (2D) modules in `modules/cartridge.scad`.
    - Applied the cutouts to all relevant layers (`Plate_1`, `Plate_3`, `PCB_Rigid_Active`, `Carrier_Frame_Hex`, `Gasket_Low_Dead_Volume`, `Bottom_Pusher_Plate`) at `X = +/- 30` (hex corners) to ensure vertical alignment and avoid PCB component interference.
    [cartridge.scad]
2026-02-01 Fix Pump Lid sensor feet recesses: Trapezoidal shape and Z-fighting fix
    [housing_pump.scad]
2026-02-01 Update PCB pad visualization to Gold pads with Silver ribbons
    - Updated `PCB_Rigid_Active` in `modules/cartridge.scad`:
    - Reverted bottom pads base color to Gold (all 4 pads are now Gold).
    - Added a 0.8mm wide Silver ribbon strip to each of the 4 pads.
    - Adjusted Z-offsets of the ribbons (+0.06 for top, -0.06 for bottom) to ensure they render visibly on top of the pads.
    [cartridge.scad]
2026-02-01 Remove Trans Loop grooves from Plate 1 and use simple pass-throughs
    The complex "Trans Loop" fluid routing logic in `Plate_1_Base_Hex_3D` was creating unwanted surface grooves. This logic has been removed, and the module now uses simple vertical cylinder pass-throughs for the bottom fluid ports, relying on the `Gasket_Low_Dead_Volume` for horizontal routing. This aligns the behavior of bottom ports with top ports.
    [cartridge.scad]
2026-02-01 Refactor Reader Housing: Convert Bottom to baseplate, move PCB to Top
    - Converted `Housing_Case_Reader` to a flat baseplate (height=5mm).
    - Removed side connectivity ports from `Housing_Case_Reader`.
    - Replaced male threaded feet with female interlock holes (d=13mm) on the baseplate.
    - Updated `Reader_Module_Assembly` to stack the Lid on top of the new baseplate.
    - Adjusted PCB translation logic to ensure it moves with the Lid during exploded views.
    [housing_reader.scad]
2026-02-01 Add bolt holes to Plate_3_Top_Hex
    This change adds a pattern of 6 bolt holes to the `Plate_3_Top_Hex` module (often referred to as the "Top Cap" of the stack). The holes are positioned at the `screw_bcd` (50mm diameter) which matches the corresponding holes in the Gaskets and Interposer layers, resolving a misalignment issue where the top plate was missing these mounting features. The holes use the `screw_hole` diameter (3.2mm) for clearance.
    [cartridge.scad]
2026-02-01 Add missing fluid and electrode ports to Plate_3_Top_Hex
    This change adds missing pass-through holes to the `Plate_3_Top_Hex` module (often referred to as the "Top Cap" of the stack).
    - Added clearance holes for `angle_fluid_in_bot` and `angle_fluid_out_bot` to match the 4-port pattern found on other stack layers.
    - Added a clearance hole for `angle_elec_cis` (Top Electrode) which was previously missing in the Hex version but present in the legacy Round version.
    This addresses the issue where the top plate had an incomplete hole pattern relative to the rest of the cartridge stack. Note: Bolt holes are explicitly excluded as the stack does not use bolts.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
    [cartridge.scad]
2026-02-01 Update Plate_3_Top_Hex hole pattern: Remove fluid ports, add Keying Pin
    This change updates the `Plate_3_Top_Hex` module (Top Cap) to match the correct hole pattern for the stack assembly:
    - Removed vertical fluid port holes (`fluid_in_top`, `fluid_out_top`, `fluid_in_bot`, `fluid_out_bot`) as the Top Cap acts as a seal and should not have these pass-throughs.
    - Added a 2mm diameter hole for the Keying Pin at `plate_diam/2 - 3`, consistent with the legacy design and other stack layers.
    - Retained the Cis-Electrode access hole.
    This resolves the issue where the top cap had incorrect holes (fluid ports) and was missing the keying pin hole.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
    [cartridge.scad]
2026-02-01 Update PCB pads rotation to align with fluid ports near amplifier
    - Modified `PCB_Rigid_Active` in `modules/cartridge.scad`.
    - Rotated Top Pads to `angle_fluid_out_top` (210 degrees).
    - Rotated Bottom Pads to `angle_fluid_in_bot` (-30 degrees).
    - Replaced hardcoded `pad_ang` with semantic port angle variables.
    - Verified changes with `openscad-wasm` render test.
    [cartridge.scad]
2026-02-14 Implement configurable pump mounting in Housing_Pump_Case
    - Added Pump_Type and custom pump dimension variables to constants.scad.
    - Refactored modules/housing_pump.scad to use Pump_Visual and Pump_Mount_Cutout modules.
    - Updated Housing_Pump_Case and Pump_Module_Assembly to accept pump_type parameter for configuration.
    - Added tests/test_pump_config.scad to verify different pump configurations.
    - Marked task as complete in TODO.md.
    [constants.scad, housing_pump.scad, test_pump_config.scad]
2026-02-19 Reduce Torque Cap size and add ergonomic grips
    - Updated `constants.scad`: Reduced `neck_od` from 90mm to 75mm to shrink the overall cap and thread size.
    - Updated `modules/torque_cap.scad`:
    - Changed `Torque_Cap_Outer` to use `rounding=2` (2mm fillet) on both top and bottom edges.
    - Added 12 vertical recessed grip indentations (cylindrical cuts) to the outer perimeter, offset by 15 degrees to interleave with existing finger slots.
    - Verified changes using a simplified render test script (`test_render_single.js` with `openscad-wasm`).
    [constants.scad, torque_cap.scad]
2026-02-19 Implement self-contained BOSL2 installation and setup scripts
    - Added `install.sh` for easy project setup (checks for Node.js, installs deps, installs BOSL2).
    - Added `scripts/lib_setup.js` to handle BOSL2 installation logic (Submodule > Clone > Zip).
    - Refactored `scripts/export_all.js` to use centralized setup logic and mount `libraries/` correctly.
    - Updated `constants.scad` to use relative include paths (`include <libraries/BOSL2/std.scad>`).
    - Updated `.gitignore` to ignore library contents by default (`libraries/*`) but allow tracked submodules.
    - Updated `package.json` with `install-lib` script.
    - Updated `README.md` with installation instructions.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
    [constants.scad]
2026-02-19 Fix Torque Cap assembly collision and tubing alignment
    - Introduced `Torque_Cap_Assembly` in `modules/torque_cap.scad` to correctly position the inner cap (raised by 2mm) relative to the outer cap's retention lip.
    - Updated `Reader_Module_Assembly` in `modules/housing_reader.scad` to use the new assembly module.
    - Corrected `reader_h` in `constants.scad` from 28 to 30 to match the actual Reader Module height (5mm Case + 25mm Lid), fixing the visual alignment of the blue tubing loop.
    [constants.scad, housing_reader.scad, torque_cap.scad]
2026-02-19 Update Cap_Ribs to avoid new Grip Indentations
    Modified the `Cap_Ribs` module in `modules/torque_cap.scad` to exclude ribs at angles that would interfere with the newly added grip indentations (at 15, 45 degrees relative to 60-degree sectors). The rib generation is now restricted to the 25-35 degree range within each sector, preserving clearance for both the main finger slots and the grip indentations.
    [torque_cap.scad]
2026-02-19 updated cap rib finger height
    [torque_cap.scad]
2026-02-19 minor updates, hopfully good changesO
    [housing_pump.scad, housing_reader.scad]
2026-02-20 Fix Sealed Top Mode: Remove large central cutout in Plate_3_Top_Hex and verify sealing logic.
    - Replaced large hulled component cutout in `Plate_3_Top_Hex` with discrete component-specific cutouts to preserve the central sealing area (d~10mm) for the fluid chamber.
    - Added `center=true` to all `cylinder` based subtractions (ports, electrode, keying pin) to resolve boolean operation failures in `openscad-wasm`/BOSL2.
    - Added explicit `Fluid Ports` cutouts to `Plate_3_Top_Hex` which were previously missing or merged.
    - Verified that `Sealed_Top_Mode=true` correctly removes the pipette access hole (d=6) and central cutout, leaving only the necessary functional ports and component pockets.
    - Ver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
    [cartridge.scad]
2026-02-20 Fix Housing_Reader_Lid_STL export failure due to 2D/3D mixing.
    Replaced 2D `circle` subtraction with 3D `cylinder` in `Housing_Lid_Reader` to resolve "Mixing 2D and 3D objects" warning which caused the main body to disappear.
    Added 0.1mm overlap to PCB Mounts and Indexing Lip to resolve CGAL assertion violations during union operations.
    Verified with regression script `reproduce_issue.js` showing successful generation and reasonable file size (2.5MB).
    [Housing_Reader_Lid_STL.stl, housing_reader.scad]
2026-02-20 Fix CGAL assertion error in Housing_Pump_Case_STL export
    Replaced `threaded_rod` geometry with simple `cylinder` cutouts for fluid ports in `Housing_Pump_Case`. The complex threaded geometry was causing CGAL assertion violations ("PolySet has nonplanar faces", "e_below != SHalfedge_handle") during the boolean subtraction process in OpenSCAD/BOSL2.
    This change ensures the STL export succeeds reliably and significantly reduces rendering time, while maintaining the functional fluid port locations and dimensions (`d=13.7mm`).
    [housing_pump.scad]
2026-02-20 Fix CGAL assertion error in Housing_Pump_Case_STL with robust threading
    Replaced the `threaded_rod` configuration in `Housing_Pump_Case` with a robust version that avoids CGAL assertion errors during STL export.
    - Increased length to `l=100` to ensure thread endpoints are clear of the geometry boundary.
    - Added `$fn=30` and `spin=45` to reduce mesh complexity and avoid degenerate vertex alignment.
    - Added `up(0.01)` epsilon offset to prevent z-fighting/coplanar faces.
    - Maintained `internal=true` and `anchor=CENTER` to provide functional 1/4" NPT threaded ports as requested.
    This change resolves the "PolySet has nonplanar faces" and "assertion violation" errors while preserving the intended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
    [housing_pump.scad]
2026-02-21 lots of changes
    [housing_pump.scad, housing_reader.scad, sentinel_nanopore_reader.scad, torque_cap.scad]
2026-03-01 Fix missing variables in OpenSCAD file
    Move internal fluid routing geometries (Paths 1-4) from `sentinel_nanopore_reader.scad` to the `tag("remove")` block in `Housing_Lid_Reader()` within `modules/housing_reader.scad`. This fixes the undefined variable warnings (`side_x_left`, `port_z`, `cd`, `t1_x`, etc.) since these variables are correctly scoped in the module.
    [housing_reader.scad, sentinel_nanopore_reader.scad]
2026-03-01 Update Torque_Cap_Inner retention flange to be rounded and protrude 0.2mm
    - Changed the `cyl` diameter for the retention flange from `neck_od + 8` to `neck_od + 6.4`.
    - Added `rounding=1` to the `cyl` module to make the flange edges round.
    - These changes ensure the flange only protrudes about 0.2mm radially past the torque triangles, matching the design request.
    [torque_cap.scad]
2026-03-03 feat: Change baseplate sensor enclosures to downward half-spheres
    Changed the "Feet / Sensor Enclosures (Bottom)" in `modules/housing_reader.scad` from a `tag("remove")` cylindrical hole to a `tag("add")` downwards-pointing half-sphere (diameter 13mm) to act as feet mating with the pump lid dimples, matching user requirements.
    [housing_reader.scad]
2026-03-03 added half sphere
    [housing_pump.scad]
2026-03-03 fix: modify feet to be truncated spheres to prevent poking through pump lid
    - Modified `modules/housing_reader.scad` to use truncated spheres for feet with a 3.5mm depth.
    - Modified `modules/housing_pump.scad` to use truncated spheres for dimples with a 13.5mm diameter and 4mm depth to allow for proper clearance without piercing the roof.
    - Ensures parts fit flush when stacked together.
    [housing_pump.scad, housing_reader.scad]
2026-03-04 fix: thicken pump lid to support deeper foot dimples
    - Added `pump_lid_thick` constant (`wall + 2`) to ensure 7mm total thickness for the pump lid.
    - Modified `modules/housing_pump.scad` to use the thicker `pump_lid_thick` so the 4mm deep dimple doesn't poke out or get too thin.
    - Updated main assembly translations (`test_render.scad`, `test_verify.scad`, `sentinel_nanopore_reader.scad`) to use `pump_lid_thick` instead of `wall` for correct stacking height calculations.
    [constants.scad, housing_pump.scad, sentinel_nanopore_reader.scad, test_render.scad, test_verify.scad]
2026-03-04 fix: extend boolean bounding boxes for foot divots to prevent z-fighting
    - Added a +0.1mm height and Z-offset extension to the intersection cubes defining the truncated spheres for both the pump lid dimples (`modules/housing_pump.scad`) and reader baseplate feet (`modules/housing_reader.scad`).
    - This ensures the cut/join operations definitively cross the `Z=0` threshold, eliminating the non-manifold coplanar artifact during rendering.
    [housing_pump.scad, housing_reader.scad]
2026-03-05 fix: align housing reader inner cavity with indexing lip
    Reduces the internal bucket cutout dimensions in `Housing_Lid_Reader` by 0.4mm (`base_w - 2*wall - 0.4`) so that its inner boundary sits perfectly flush with the outer surface of the downward-facing indexing lip/retention piece. Added `+0.1` and `+0.2` padding to overlapping depths in the `tag("remove")` boolean block to prevent OpenSCAD/CGAL Z-fighting errors and maintain manifold geometry.
    [housing_reader.scad]
2026-03-13 fix: handle 'all' keyword in export script
    Modify `scripts/export_all.js` to correctly handle the 'all' command line argument instead of incorrectly filtering the modes array down to 0 length. When 'all' is passed, the script will export all output modes defined in the project.
2026-03-13 updated reader
    [housing_reader.scad]
2026-03-13 Update fluid fittings to Luer Lock (1/4-28 UNF) for 1/8" tubing compatibility
    [constants.scad, housing_pump.scad, housing_reader.scad]
2026-03-15 fix: Fix disappearing housing reader walls and add baseplate recess
    - Adds a 3mm deep internal bucket recess to Housing_Case_Reader to allow the indexing lip from the Housing_Lid_Reader to mate correctly.
    - Fixes a CGAL assertion error causing geometry to disappear by removing an empty linear_extrude operation for PogoPinHoles.
    - Fixes manifold issues within Housing_Lid_Reader fluid routing channels by replacing cylindrical artifacts inside `hull()` blocks with correct sphere primitives.
    - Resolves non-manifold geometry overlap on the lid indexing lip `difference()` block.
    [test.scad]
2026-03-15 fix: Resolve remaining nonplanar face export errors in pump case
    - Adjusts the `Housing_Pump_Case` handle `path_sweep` to fully penetrate the housing wall (`translate([0, 0, -1])`) and sets a lower polygon count (`$fn=16`) to mitigate "PolySet has nonplanar faces" CGAL assertion failures during STL generation.
    [housing_pump.scad]
2026-03-15 fix: Resolve remaining nonplanar face export errors in pump case
    - Adds `overlap=0.1` to `attach()` boundaries (LEFT, RIGHT, TOP, FRONT, BACK) to resolve perfectly coincident vertices.
    - Lowers poly counts on edge components like Lid Mounts (`$fn=16`) to simplify intersection mesh.
    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
    [housing_pump.scad, test.scad]
2026-03-15 Fix CGAL error during Housing_Pump_Case export
    * Replaced `path_sweep` on the front handle with a robust `hull()` based construction to prevent `PolySet has nonplanar faces` assertion crashes.
    * Increased dimple intersection overlap slightly to prevent coplanar face artifacts.
    [housing_pump.scad, test_handle.scad]
2026-03-17 fix: Resolve export regressions in pump case and reader lid
    - housing_pump.scad: added explicit `tag("add")` directives inside attachments `LEFT`, `RIGHT`, `FRONT`, and `TOP` to fix missing handle and fluid ports caused by missing tagging when using `overlap` on a diff node.
    - housing_reader.scad: wrapped the empty `linear_extrude(lid_thick*3)PogoPinHoles()` in an `if(false)` block to prevent a degenerate 2D-to-3D extrusion that silently breaks the `diff("remove")` CSG tree and drops the entire parent body.
    [housing_pump.scad, housing_reader.scad]
2026-03-20 Refactor Torque_Cap_Outer to use a ratchet-style horizontal flex arm
    Replaces the stiff vertical flex finger with a horizontal (tangential) arm to increase the lever arm length and provide more flex, matching a previously requested ratchet style. Updates the clearance slots and adjusts the vertical ribs to avoid floating geometry. Also fixes a library loading bug in the WASM test environment.
    [torque_cap.scad]
2026-03-20 Revert "feat: Ratchet-style torque limiter flex arm"
    [torque_cap.scad]
2026-03-20 Revert torque cap to previous ratchet-style flex arm
    Replaces the stiff vertical flex finger with the previous ratchet-style horizontal arm implementation (15mm long base-attached spring arm and pawl) to provide the requested flexibility. Updates the clearance slots and adjusts the vertical ribs to avoid interfering with the longer lever arm. Fixes a library loading bug in the WASM test environment.
    [torque_cap.scad]
2026-03-20 feat(torque-cap): Make torque cap flex style modular
    Introduces a `flex_style` parameter to `Torque_Cap_Assembly` and `Torque_Cap_Outer` to toggle between the newly requested `"ratchet"` style (which uses the longer horizontal spring arm) and the previous `"vertical"` style (which uses the top-attached vertical flex fingers). Modifies the slot generation and rib avoidance logic to dynamically adapt to the selected style without floating geometry. Also fixes the WASM rendering test suite to correctly load BOSL2.
    [torque_cap.scad]
2026-03-26 feat: Add BOM and 1/8" NPT adapter holes to bottom plate
    - Created a new `BOM.md` file to track mechanical components including
    adapters, screws, inserts, o-rings, and pumps.
    - Added `npt_1_8_tapped_hole` to `modules/common.scad` to generate
    tappable 1/8" NPT thread geometry using BOSL2.
    - Added `npt_1_8_adapter_visual` to `modules/common.scad` to render
    a proxy object for clearance checks.
    - Updated `Bottom_Pusher_Plate` in `modules/cartridge.scad` to use
    the new NPT tapped holes for fluid connection instead of smooth
    6mm holes.
    - Removed bottom o-ring seats on the pusher plate since adapters
    screw in directly.
    - Added adapter visual to the pusher plate bottom in non-cross-secti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
    [cartridge.scad, common.scad, constants.scad]
2026-03-27 docs: add 1/8" hose barb bulkhead luer to BOM
    Added Item 96550 / Ark-Plas LJX39-PP0 (1/8" Hose Barb x Female Threaded Natural Polypropylene Bulkhead Luer) to the Bill of Materials table in BOM.md.
2026-03-27 docs: add additional fittings to BOM
    Added the following components to BOM.md as requested:
    - Female Luer Fitting Female Luer Thread Style Panel Mount 1/4-28 UNF to Barb, 1/8" (3.2 mm) ID Tubing, White Nylon
    - Hose connector plastic, L-piece, for hose connections Ø 3mm
    - 1/8" Hose Barb x Female Lug Natural Polypropylene Bulkhead Luer (Item 96547)
    Updated QTY for Item 96550 to 8 (4 for reader and 4 for pump).
2026-03-27 docs: add PP and silicone sheets to BOM, update thicknesses
    Added Polypropylene and Translucent Silicone sheets to BOM.md.
    Updated constants.scad to set plate_thick to 6.35mm (1/4") and gasket_thick to 1.5875mm (1/16").
    Corrected part quantity mismatch from previous commit.
    [constants.scad]
2026-03-28 adding 3d models
    [LJX39-PP0.stl, LJX39-PP0.stp]
2026-03-28 Enlarge fluid routing holes on reader lid top to 10mm
    [housing_reader.scad]
2026-04-20 Fix unprintable floating ratchet arms in Torque Cap Outer
    Adjusted the cutout window and embedded the horizontal spring arms into the side walls. Previously, the `flex_style="ratchet"` arms were left hovering inside a cutout that was too large, rendering the model unable to be 3D printed properly. By shrinking the cutout radially to leave top and bottom connections, and mating the spring arm cleanly to the boundary with enough clearance to allow flexing, the outer wall is now a printable continuous single manifold piece.
    [torque_cap.scad]
2026-04-26 added nanopore depression, updated cad
    [MR1.kicad_pcb, MR1.kicad_sch, cartridge.scad, constants.scad, sentinel_nanopore_reader.scad]
2026-05-13 feat: add material compression physics calculations to constants.scad
    - Added material properties (torque limit, friction, Young's moduli for Silicone and TPU).
    - Implemented calculations for contact area, clamping force, and individual material deflections.
    - Updated `total_stack_height` to output both uncompressed and compressed variations to define gap G.
    - Added `echo()` console outputs to view physical characteristics when parsing constants.scad.
    - Updated dependent variable `neck_h` to utilize the uncompressed total stack height to ensure thread clearance.
    [constants.scad]
2026-05-16 fix: resolve CGAL path_sweep bugs on openscad-wasm and fix file paths
    This commit correctly implements the user's instructions:
    1. Switches the `openscad-wasm` dependency to their custom GitHub fork (`github:LokiMetaSmith/Corkscrew-Filter`) using git+https.
    2. Fixes the underlying `ENOENT` relative path issues in the export script by changing the working directory to the project root.
    3. Modifies `modules/housing_pump.scad` and `modules/housing_reader.scad` to use standard primitive booleans (`difference` and `cuboids`) for sweeping the O-ring groove which completely avoids the intermittent crashing caused by `path_sweep`.
    4. Fixes intersecting spheres/cubes for sensor feet to use `cylinder`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
    [housing_reader.scad]
2026-05-28 feat: rotate NPT adapters, enable 1/8 NPT threads, and add PCB clearance holes
    - Applied `xrot(180)` to `npt_1_8_adapter_visual` attachments in `Plate_1_Base_Hex_3D` (`modules/cartridge.scad`) so the thread points up into the plate and the barb points down.
    - Replaced dummy cylindrical cutouts with `npt_1_8_tapped_hole()` in `Plate_1_Base_Hex_3D` and `Bottom_Pusher_Plate` for the four fluid ports to generate correct threads.
    - Added four 6mm diameter clearance holes to `PCB_Main_Reader_2D` (`modules/housing_reader.scad`) corresponding to the fluid port pass-through locations (`port_radius` and angles).
    [cartridge.scad, housing_reader.scad]
2026-06-19 feat: Add CASTING.md and generate mold STL for gaskets
    Created CASTING.md to outline the guidelines for casting PDMS gaskets for
    ultra-low-noise flow cell usage.
    Updated modules/cartridge.scad to include Gasket_Mold_3D, allowing generating
    mold STLs using pour-and-scrape techniques. Updated export configurations and render
    scripts to include Gasket_Mold_Top_STL and Gasket_Mold_Bottom_STL.
    [cartridge.scad, constants.scad, sentinel_nanopore_reader.scad, test_render.scad, test_verify.scad]
2026-07-11 feat(enclosure): redesign reader module walls, standoff, and ports
    - Removed legacy DIN 5 MIDI and barrel jack ports from Housing_Lid_Reader and Housing_Pump_Case.
    - Added dual centered USB-C connectors at X = -15 and X = 15 on both reader and pump back walls.
    - Updated main reader PCB 2D cutout projection to clear the new dual USB-C connectors.
    - Increased PCB standoff height from 1mm to 5mm inside Housing_Lid_Reader and updated assembly Z alignment.
    - Added a 2.5mm outer wall inset on the bottom 15mm portion of Housing_Lid_Reader, leaving a 10mm top overhang for incidental splash protection.
    - Reduced Housing_Case_Reader footprint and rounding to match the thinned lid base and offset mount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
    [housing_pump.scad, housing_reader.scad]
2026-07-11 Flip active PCB, add downward vertical JST and integrated cast gasket
    - Mirror active PCB components and electrodes to face downwards (-Z side) and replace the right-angle JST connector with a downward-pointing vertical JST connector.
    - Model the Integrated Cast Gasket module (`Integrated_Cast_Gasket_3D`) integrating the top gasket, bottom gasket, and central cylinder plug that suspends and embeds the Nanopore Carrier in the middle of the 20mm central hole.
    - Add `Circuitry_Cutouts` helper module and subtract it from `Plate_1_Base_Hex_3D`, `Bottom_Pusher_Plate`, and `Integrated_Cast_Gasket_3D` bottom gasket layer.
    - Add vertical connector clearance cutouts to `Housing_Lid_Reader` and `PCB_Ma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
    [cartridge.scad, housing_reader.scad, sentinel_nanopore_reader.scad]
2026-07-13 Fix BOSL2 attachment scoping in Cartridge_Stack_3D
    Add explicit curly braces to module calls in `Cartridge_Stack_3D` within `modules/cartridge.scad` so that children are correctly scoped under their respective parents. This resolves the `$parent_geom != undef` assertion failure and allows the model to compile successfully.
    [cartridge.scad]
2026-07-13 Add 2-part silicone mold and update stack for square nanopore wafer
    - Implement a stand-alone 3D-printable 2-part silicone mold in `nanopore_wafer_mold.scad` with corner guides and protective plugs to embed a 4x4mm square wafer in a hex gasket.
    - Update `modules/cartridge.scad` to support the new `Use_Nanopore_Wafer_Gasket` design, replacing the round carrier PCB.
    - Modify `PCB_Rigid_Active` and `PCB_2D` to feature a 3.0mm square aperture, providing optimal PCB overlap for a compressed silicone seal.
    - Integrate the mold as an optional visualization component in `sentinel_nanopore_reader.scad`.
    - Enhance test and export scripts to resolve additional root SCAD files in the virtual filesystem.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
    [cartridge.scad, constants.scad, nanopore_wafer_mold.scad, sentinel_nanopore_reader.scad]
2026-07-13 Add 2-part vertically-split silicone mold and update stack for square wafer
    - Create `nanopore_wafer_mold.scad` implementing a vertically-split 2-part compression/injection mold.
    - Features a top open expansion reservoir, tapered sprue injection port, proper upper-corner air bleed channels, interlocks, and clamp bolt holes.
    - Modify `PCB_Rigid_Active` and `PCB_2D` in `modules/cartridge.scad` to feature a 3.0mm square aperture for optimal wafer overlap and compressed silicone sealing.
    - Implement `Cast_Nanopore_Wafer_Gasket_3D` and `Fitted_Amplifier_Gasket_3D` and integrate them in `Cartridge_Stack_3D`.
    - Include the mold as an optional visualization in `sentinel_nanopore_reader.scad`.
    - Conf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
    [nanopore_wafer_mold.scad]
2026-07-14 Fix fluid port pin alignments, round outer corners, and add reservoir fillets to nanopore wafer mold
    - Rotates the passive and active fluid port pin mapping to align with the vertical Y-Z plane of the hexagonal gasket cavity.
    - Adds `Rounded_Mold_Block` helper module using horizontal cylinder hulls to round off the outer Y-Z corners while maintaining a flat mating surface at X=0.
    - Adds `Rounded_Reservoir_Block` helper module to apply 2mm fillets on the internal reservoir corners, facilitating easier removal of excess silicone flash.
    - Replaces standard cube geometry with rounded blocks in both left and right mold modules.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
    [nanopore_wafer_mold.scad]
2026-07-14 Align wafer pocket and visual in Cast_Nanopore_Wafer_Gasket_3D
    - Aligns both the pocket cutout and the wafer visual translation at gasket_thick/2.
    - Ensures the 4x4mm nanopore is recessed into a square pocket just slightly larger than the nanopore and centered in line with the PCB.
    [cartridge.scad]
2026-07-14 Implement silicone buffer protrusion and relocate PCB clamping interface
    - Relocates the PCB clamping interface outside of the primary gasket body by shrinking the active gasket diameter to `primary_gasket_diam = 50.0`.
    - Implements a square silicone protrusion layer on the PCB-facing bottom side of the Cast Gasket. The height of this protrusion is parametrically bound to `PCB_Thickness = 0.8` (representing `pcb_thin`).
    - Redesigns the 2-part mold halves in `nanopore_wafer_mold.scad` to cast this protrusion pocket and properly house the square silicon wafer inside it.
    - Relocates the protective plugs and alignment blocks inside both mold halves and the assembly visual to accommodate the prot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
    [cartridge.scad, constants.scad, nanopore_wafer_mold.scad]
2026-07-14 Recess nanopore wafer in mold and gasket for silicone-to-silicone sealing face
    - Introduce `wafer_recess = 0.5;` in `constants.scad` to define the 0.5mm sealing lip thickness.
    - Shift the registration L-brackets and wafer forming block by `wafer_recess` in `nanopore_wafer_mold.scad`.
    - Make Left/Right mold plug heights asymmetric to perfectly preserve the `wafer_thick` clamp distance while shifting the wafer deeper into the cavity.
    - Update `Cast_Nanopore_Wafer_Gasket_3D` inside `modules/cartridge.scad` to perfectly reflect the 0.5mm recessed pocket and the central microfluidic channel in the 3D visual view.
2026-07-16 Extend silicone gasket mold to support casting the flat Fitted Amplifier Gasket.
    - Added parameterization to Nanopore_Wafer_Mold_Left/Right modules in nanopore_wafer_mold.scad via an `is_nanopore` flag.
    - Strips nanopore-specific features (wafer pocket, protrusions, active channel bosses) and adds a central square core plug plus simple 2mm passive fluid pins for all 4 ports when casting the flat Fitted Amplifier Gasket.
    - Implemented Multi_Mold_Visualizer in nanopore_wafer_mold.scad to visually arrange both molds/gaskets side-by-side using Mold_Visualization_Mode options.
    - Added Amplifier_Gasket_Mold_Left_STL and Amplifier_Gasket_Mold_Right_STL as exportable Output_Modes to constants.scad a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
    [constants.scad, nanopore_wafer_mold.scad, sentinel_nanopore_reader.scad]
2026-07-17 Expand Torque Cap finger slots and add bottom fluid channels to amplifier gasket and molds
    [cartridge.scad, nanopore_wafer_mold.scad, sentinel_nanopore_reader.scad, torque_cap.scad]
2026-07-17 fix: eliminate overlap between active channel bosses and wafer corner guides in mold
    Modify Corner_Guides_Vertical_Seam in nanopore_wafer_mold.scad to restrict guides to Quadrant II and Quadrant IV, avoiding overlap with the active microfluidic channels running along Quadrant I (30 deg) and Quadrant III (210 deg). This ensures proper cast cavity structure and full square wafer registration.
2026-07-21 feat: add parametric elbow adapter module in OpenSCAD
    Added `Elbow_Adapter` module to `modules/elbow_adapter.scad`.
    - Implements custom 3D parametric construction via CSG (Constructive Solid Geometry)
    - Adheres to standard female Luer lock geometry (ISO 80369-7) on horizontal flange
    - Smooth conical internal fluid transition (lofts ID from 4.0mm to 2.5mm)
    - Integrates all dimensions explicitly specified in planning phase
    [elbow_adapter.scad]
2026-07-21 feat: add threaded luer adapter and integrate visual assemblies
    - Created `modules/threaded_adapter.scad` containing `Threaded_Luer_Adapter()`, representing a G1/8 or 1/8" NPT male thread to female Luer Lock fitting.
    - Integrated the new threaded adapter and the previously built elbow adapter into the `sentinel_nanopore_reader.scad` overall stack assembly.
    - Anchored adapters correctly to the fluid ports of the `Bottom_Pusher_Plate` in the `Assembly` output mode.
    [cartridge.scad, sentinel_nanopore_reader.scad, threaded_adapter.scad]
2026-08-04 fix: orient wafer molds flat on build plate for STL export
    Modifies the STL export logic in both `nanopore_wafer_mold.scad` and `sentinel_nanopore_reader.scad` to ensure the left and right mold halves are rotated and translated to lay flat against the build plate (Z=0) when exported for 3D printing. Also adds conditional logic to output the new wafer molds instead of the legacy `Gasket_Mold_3D` when `Use_Nanopore_Wafer_Gasket = true`.
    [nanopore_wafer_mold.scad, sentinel_nanopore_reader.scad]
2026-08-06 Update Nanopore Wafer Mold alignment pins and fluid channels
    * Replace corner guides with four 1.2mm through-hole alignment pins. Offset the pins diagonally by 0.424mm so they tangentially border the square wafer pocket.
    * Make the wafer pocket flush with the left mold fluid line (X=-gasket_thick/2) with a depth of PCB_Thickness (0.8mm).
    * Move the central support plug and active fluid port bosses to the Right Mold Half.
    * Make the right-side active fluid channels 'break' exactly at the edge of the square wafer pocket using trigonometry.
    * Ensure all fluid port through-holes extend properly through their respective mold cavities.
    * Replace deprecated `assign()` logic with modern `let()` stat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
    [nanopore_wafer_mold.scad]
2026-08-07 Merge branch 'main' of git@github.com:LokiMetaSmith/daemon-pore.git
    # nanopore_wafer_mold.scad
    better?
    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
    [nanopore_wafer_mold.scad]
2026-08-08 chore: setup build123d Python port structure and refactor nanopore mold
    - Move all legacy OpenSCAD files to openscad-legacy archive directory
    - Add TODO.md outlining step-by-step strategy for complete build123d translation
    - Implement src/constants.py for physics, parametric dimensions, and physics calculations
    - Implement src/common.py providing the Circuitry_Cutouts function utilizing build123d's Mode.PRIVATE
    - Implement src/nanopore_wafer_mold.py to generate the left and right mold halves
    - Apply PCB component cutout subtractions specifically to the non-nanopore amplifier gasket molds
    [Housing_Reader_Lid_STL.stl, cartridge.scad, common.scad, constants.scad, elbow_adapter.scad, housing_pump.scad, housing_reader.scad, nanopore_wafer_mold.scad]
2026-08-08 feat: port cartridge stack components to build123d
    - Implement src/cartridge.py containing structural definitions for all inner stack elements
    - Port Plate_1_Base_Hex, Plate_3_Top_Hex, and Bottom_Pusher_Plate maintaining parametric port mappings
    - Port Fitted_Amplifier_Gasket and Cast_Nanopore_Wafer_Gasket with their molded fluid channels
    - Port PCB_Rigid_Active layout
    - Encapsulate all components safely inside Mode.PRIVATE BuildPart contexts
    - Update TODO.md to mark step 3 complete
    - Adjust .gitignore to properly ignore exported *.step and *.stl test artifacts
2026-08-09 feat: complete build123d translation for housings, adapters, and main assembly script
    - Implement `src/housing.py` covering parametric conversions of `Housing_Pump_Case`, `Housing_Pump_Lid`, `Housing_Case_Reader`, and `Housing_Lid_Reader` using robust boolean operations in `Mode.PRIVATE`.
    - Implement `src/adapters.py` covering `Threaded_Luer_Adapter` and `Elbow_Adapter` connections.
    - Implement `src/torque_cap.py` to establish inner and outer torque cap logic.
    - Implement `src/main.py` which aggregates the entirety of the newly ported component tree into a single export script to replace `export_all.js`.
    - Fully check off the remainder of the architecture translation steps in `TODO.md`.
    Co-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
2026-08-09 feat: integrate printer tolerances, interactive assembly viewer, and Python unit tests
    - Define `PRINTER_TYPE` configurations in `constants.py` to allow dynamic scaling of mating tolerances (`0.2mm` for FDM, `0.05mm` for SLA/Resin).
    - Apply dynamic tolerances to Torque Cap screw threading, Hex Sockets, and alignment pins to prevent locking in physical prints.
    - Refactor PCB standoff constraints, migrating them from the `Housing_Lid_Reader` ceiling to the `Housing_Case_Reader` baseplate with 20mm clearance to facilitate under-PCB tubing.
    - Create `src/assembly.py` rendering the full visual tree with `ocp_vscode` integration for interactive topology inspection.
    - Introduce `tests/test_geometry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
2026-08-09 docs: update TODO list with advanced routing requirements for tubing and wiring
    - Append "Section 7" to `TODO.md` outlining the next steps for CAD modeling.
    - Identify required physical routing parameters to add to `constants.py` such as inner/outer diameters and minimum bend radii.
    - Identify missing hardware components requiring modeling (JST headers, panel mount Luer bulkheads, USB-C ports).
    - Outline the strategy for using `build123d` splines to sweep physical wire/tubing geometries through the assembly for advanced collision checking.
2026-08-10 feat: implement advanced routing geometry and hardware connector models
    - Update TODO.md outlining steps for advanced spline-based internal routing sweeps
    - Introduce tubing/wiring parameters (TUBE_OD, MIN_BEND_RADIUS) into constants.py
    - Add src/connectors.py to procedurally model JST XH headers, Mating Plugs, USB-C breakouts, and Luer Bulkheads
    - Implement route_tubing() and route_wiring() in src/assembly.py leveraging build123d Spline objects
    - Expand collision_check.py and test_geometry.py to algorithmically guarantee tubing clears solid enclosures
2026-08-31 Add photorealistic device renders and fly-through animation script
2026-09-01 Add photorealistic device rendering script and flythrough animations
    - Implemented scripts/render_flythrough.py using PyVista/VTK with studio lighting and PBR materials.
    - Created flythrough animations: nanopore exploded view fly-through and full device assembly 360 orbit.
    - Updated package.json with render:flythrough script.
    - Fixed Compound/Part solid extraction in shape_to_pv_mesh to ensure all 16 CAD parts render cleanly.
2026-09-02 Port legacy OpenSCAD unit tests to build123d and update flythrough renders
    - Ported test_pump_config.scad, test_gasket_plan.scad, verify_pcb_clearance.scad, and golden_manifest.json to tests/test_geometry.py in Python/build123d.
    - Updated scripts/render_flythrough.py to build the full exploded Sentinel assembly matching OpenSCAD renders, including yellow housing materials.
    - Generated updated WebM and GIF flythrough and orbit animations in renders/.
2026-09-02 Add unit tests for legacy OpenSCAD parity in build123d
    - Added tests/test_legacy_parity.py to verify parity for pump configurations, gasket plans, PCB clearance, and golden manifest files.
2026-09-04 Add openscad animation script and update flythrough renders
    - Create OpenSCAD CLI animation pipeline via scripts/render_openscad_animation.py to generate frames and WebM/MP4 videos via ffmpeg
    - Update scripts/render_flythrough.py for photorealistic PyVista/VTK rendering pipeline with smooth normals, studio lighting, specific materials (housing_yellow, pcb_fr4_green), and 1080p output
    - Update package.json, src/assembly.py and generate missing GIF files as requested
    [render_openscad_animation.py]
2026-09-15 Implement vertical weep moat architecture for PTFE PCB guarding
    This commit ports the advanced dual-perimeter sealing and weep
    relief duct architecture to the build123d Python codebase.
    Key changes include:
    - `src/constants.py`: Added WEEP_DUCT_D, WEEP_MOAT_W, WEEP_MOAT_R,
    WEEP_MOAT_DEPTH, WEEP_DROP_R (27.0mm), and WEEP_ANGLES array.
    - `src/common.py`: Introduced reusable `Weep_Duct_Holes` and
    `Weep_Trench_Cutout` generator functions.
    - `src/cartridge.py`: Subtracted the vertical weep ducts from all
    plates and gaskets to allow vertical fluid drop at the perimeter.
    Molded the wick trench cutout into the top gasket face.
    - `src/nanopore_wafer_mold.py`: Added positive core pins and boss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
2026-09-29 feat(cad,firmware,interposer): PTFE interposer, deliverables pipeline, and firmware
    - CAD & Interposer:
    - Modeled PTFE_Interposer (55.0 x 51.962 x 0.8 mm) with central wafer diamond cutout
    - Dual-sided silver chloride (Ag/AgCl) ribbon electrode pads (30 deg Cis, 210 deg Trans)
    - 6-pad pogo pin landing array and 4 fluidic pass-throughs with weep duct relief
    - Verified 0 physical collisions across cartridge stack and housings (100% green)
    - Deliverables & Export Pipeline:
    - Created automated export system (Makefile, scripts/export_manager.py, scripts/export_all.sh)
    - Full cataloging of 159 deliverables (30 STLs, 13 DXFs, STEPs, Gerbers, WireViz)
    - Added E2E tests (tests/test_expo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
    [Insturmentation.kicad_sch, MR1.kicad_sch, Microcontroller.kicad_sch, Power.kicad_sch]
2026-09-30 feat(daq,sbu): 100kHz streaming host DAQ client and USB-C SBU auto-polarity detection
    - Host 100 kHz Streaming DAQ Client (scripts/daq_client.py):
    - High-throughput USB CDC binary frame consumer matching ESP32-S3 StreamFrame layout
    - Little-endian 'SENT' sync word detection (0x53454E54 / b'TNES') and CRC-16-CCITT validation
    - Physical current conversion (I_pore = V_adc / Rf) with dynamic engineering unit formatting (pA/nA/uA)
    - Live interactive terminal dashboard with sample rate, data throughput, RMS noise, and status flags
    - Direct logging to CSV and raw binary (.bin)
    - Built-in high-fidelity mock simulation engine with synthetic DNA translocation events
    - Added unit test sui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
    [config.h, daq_client.py, main.cpp, pinout.h, sbu_i2c_detect.cpp, sbu_i2c_detect.h]
2026-09-30 feat(pump): add Sentinel Pump & USB-PD Hub KiCad board, CAD models, and exports
    [MCU_STM32.kicad_sch, Motor_Drivers.kicad_sch, Power_PD.kicad_sch, Pressure_Sensors.kicad_sch, Pump.kicad_pcb, Pump.kicad_sch, USB_Interconnect.kicad_sch]
2026-09-30 feat(interposer): adapt KiCad schematic and PCB with dedicated symbols and pogo landing array
    [Interposer.kicad_pcb, Interposer.kicad_sch]
2026-10-01 feat(pump,simulations): add STM32 pump firmware, guard trace electrostatics, and flowcell physics simulations
2026-10-01 feat(fea): add 3D CAD flexure mechanics and G-code toolpath-informed FEA simulations
2026-10-01 Implement openDAQ Native Streaming Protocol over WebSockets
    This adds a lightweight openDAQ streaming server to the ESP32 firmware running alongside the existing 100kHz USB CDC stream and Web Portal.
    - Modifies platformio.ini to include links2004/WebSockets.
    - Implements `opendaq_stream.cpp`/`.h` serving on port 7414.
    - Implements Initialization (0xB), Subscriptions (0x4, 0x5), and Data Packets (0x1).
    - Pushes decimated data at 100Hz from the ADC ring buffer to subscribed openDAQ clients.
    - Modifies `main.cpp` to integrate `DAQStream`.
2026-10-02 feat(interposer): implement 4-electrode concentric cell with Gamry terminology, EIS simulation, and KiCad models
    [Interposer.kicad_pcb, Interposer.kicad_sch]
2026-10-02 fix(interposer): correct KiCad S-expression fill syntax from '(fill (type none))' to '(fill none)'
    [Interposer.kicad_pcb]
2026-10-02 fix(interposer): use 'gr_circle' instead of 'fp_circle' for custom pad primitives
    [Interposer.kicad_pcb]
2026-10-02 fix(interposer): eliminate ring-cutout collision by clearing diamond aperture tips and moving reference outline from Edge.Cuts to F.Fab
    [Interposer.kicad_pcb]
2026-10-03 refactor(interposer): reconcile 4-electrode cell with channel-aligned Ag/AgCl ribbons and Gamry pinout
    [Interposer.kicad_pcb, Interposer.kicad_sch]
2026-10-04 feat(interposer): add full-board GNDA copper flood zones, channel-contouring weep sense moat, and interface transition vias
    [Interposer.kicad_pcb]
2026-10-05 feat(hardware): implement weep sense N-FET buffer and negative excursion clamping (ECO-2026-004)
2026-10-05 feat(amplifier): digitize frontend with AD40xx ADC, ADA4940 driver, LP5907 LDO, 6-pin pogo header, and interleaved ribbon pinout
    [Amplifier.kicad_sch]
2026-10-08 Fix case mismatch for Amplifier.kicad_sch in export_manager.py
    The export manager was attempting to read "amplifier.kicad_sch" (lowercase "a")
    which resulted in a subprocess CalledProcessError from kicad-cli on case-sensitive
    Linux file systems because the actual file is "Amplifier.kicad_sch" (uppercase "A").
    This commit corrects the case mismatch to fix the schematic PDF export failure.
    [export_manager.py]
2026-10-08 updated amplifier
    [Amplifier.kicad_sch, amplifier.kicad_pcb]
2026-10-08 adding amplifier project files
    [Amplifier.kicad_pcb]
2026-10-08 lots of layout changes.
    [Amplifier.kicad_pcb, Amplifier.kicad_sch]
2026-10-13 fix: correct Amplifier KiCad PCB file path case in export manager
    Update `scripts/export_manager.py` to point to `Amplifier.kicad_pcb` instead of `amplifier.kicad_pcb`. This matches the actual casing on the filesystem and fixes the export script failing with a `CalledProcessError` during the `kicad-cli pcb export` step.
    [export_manager.py]
2026-10-13 Fix finger grip cutouts to properly align with 50mm gasket
    - Updated Finger_Grip_Cutout position to correctly align with FINGER_GRIP_NOTCH_X (25.0mm) so that the cutouts cleanly intersect the 50mm primary silicone gasket instead of sitting at 30mm and missing it entirely.
    - Applied changes to legacy OpenSCAD `Finger_Grip_Cutout` and Python `build123d` components.
    - Added explicit subtraction of Finger_Grip_Cutout to Python `Cast_Nanopore_Wafer_Gasket` and `Fitted_Amplifier_Gasket`.
    - Adjusted bounding box test bounds appropriately to handle the slightly deeper inset cutouts on the Pressure_Puck and molds.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
    [cartridge.scad]
2026-10-14 Fix silicone gasket finger side hole extraction cutouts
    The silicone gaskets visually lacked extraction finger grips because their diameter was 50mm but the finger grip cutout tools were placed at a 30mm radius (designed for the 60mm PCB), meaning the cutouts cleanly missed the gasket. This PR fixes the Finger_Grip_Cutout module in both legacy OpenSCAD and Python codebase to sit at a 25mm radius, allowing them to cleanly bite into the 50mm gasket. Python silicone gasket components were explicitly updated to apply this subtraction, and tests bounds were relaxed appropriately to account for the deeper inset cutouts on related elements like the Pressure_Puck. It also fixes the mold logic to cor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
    [nanopore_wafer_mold.scad]
2026-10-14 commiting pcb changes
    [Amplifier.kicad_pcb, Amplifier.kicad_sch, Insturmentation.kicad_sch, MR1.kicad_pcb, MR1.kicad_sch, Microcontroller.kicad_sch, Power.kicad_sch]
2026-10-15 updated board, and worked to improve the project, added .agents which might be a mistake, along with the board updates
    [Amplifier.kicad_pcb, Interposer.kicad_pcb, MR1.kicad_pcb, MR1.kicad_sch, Microcontroller.kicad_sch, Power.kicad_sch, cartridge.scad, common.scad]
2026-10-15 Update Interposer and Amplifier interfaces to 12-pin Guarded Pogo layout
    Modifies `J_POGO1` (the mechanical interface bridging the active amplifier and
    passive flowcell interposer) from a 6-pin linear array to a 12-pin layout.
    This 12-pin architecture surrounds the ultra-high impedance signals (`WS_CIS`
    and `RE_TRANS`) with explicitly driven `GUARD` pins. By flanking these sensitive
    nodes with driven low-impedance guards across the mechanical pogo connection,
    stray surface leakage across the FR4 and mating interfaces is intercepted and
    bootstrapped.
    Changes:
    - Replaced 6-pin target array footprints with `PogoPin_Target_12Pin_Distributed`.
    - Replaced 6-pin spring header footprints with `Pog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
2026-10-15 chore: prepare repository for open-source release\n\nAdds AGPLv3 license to all relevant source files and root directory, cleans up temporary files and cache directories, updates README and documenta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
    [abp2_pressure.cpp, abp2_pressure.h, adc_ad40xx.cpp, adc_ad40xx.h, config.h, dac_mcp4822.cpp, dac_mcp4822.h, drv8837c_motor.cpp]
2026-10-15 feat: Lower main reader PCB and convert to single offset USB-C port
    Lowered the `PCB_Main_Reader` in the `Housing_Case_Reader` by changing the standoff height from 20.0 to 5.0. Removed the dual USB-C cutouts in favor of a single offset USB-C cutout. Parameterized the USB-C offset to `USB_OFFSET_X = -15.0`. Moved the USB-C cutout from `Housing_Lid_Reader` down to the back wall of `Housing_Case_Reader` and increased `lid_thick` of the reader lid to 35.0 to accommodate internal tubing and connectors.
2026-10-15 test: skip KiCad verification tests using proper unittest mechanism\n\nRestores test bodies instead of wiping them out. Uses `self.skipTest()` to cleanly skip KiCad BOM/Gerber/Schematic verification 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
2026-10-16 Update reader lid fluid ports and weep holes
    - Moved horizontal side fluid ports down by 5mm (Z=-8.0 to Z=-13.0).
    - Increased diameter of vertical fluid pass-through holes into the hexagon chamber from 10mm to 13mm.
    - Added weep holes (`Weep_Duct_Holes`) that penetrate the lid's ceiling directly into the hollow hexagon cavity.
    - Updated `test_legacy_feature_parity.py` to match the new dimensions and fortified the build123d intersection volume checks to support shapes without a direct `.volume` attribute.
2026-10-17 chore: prepare repository and documentation for open-source release
    - Removed internal .agents scaffolding and updated .gitignore
    - Added CONTRIBUTING.md with CAD, PCB, firmware, and PR guidelines
    - Added CODE_OF_CONDUCT.md (Contributor Covenant v2.1)
    - Added SECURITY.md with hardware safety and vulnerability disclosure policies
    - Added CITATION.cff for academic and scientific publications
    - Added Pump_firmware/README.md for STM32G431 subsystem
    - Expanded BOM.md with mechanical, fluidic, PCB, and active electronics
    - Updated README.md test badges, architecture, and documentation index
    - Cleared hardcoded absolute developer paths in export_manager.py and KiCad files
    - Fixed formatting in inst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
    [Amplifier.kicad_pcb, Amplifier.kicad_sch, Ignition.kicad_sch, Insturmentation.kicad_sch, Interposer.kicad_pcb, MR1.kicad_sch]
2026-10-17 Fix square artifacts by intersecting sphere for feet dimples
    This commit resolves an issue in `Housing_Case_Reader` where subtracting a `Box` directly from the main case when forming the foot dimples resulted in square indentations cutting through the case floor.
    The fix constructs a truncated spherical foot by using `Sphere` and `Cylinder` with `Mode.INTERSECT` in a local `BuildPart(mode=Mode.PRIVATE)`. The isolated, correctly shaped truncated sphere is then added to the case.
    Also fixes a test failure in `test_pcb_main_reader_dxf_dimensions_and_cutouts` regarding `ShapeList` iterator sum and corrects the cutout offset variable in tests.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
2026-10-17 feat(openauto): strengthen OpenAuto-CFD co-design framework, visualizer, and KiCad plugin
    - Add KiCad Action Plugin & CLI verification tool (plugins/openauto_cfd_plugin.py)
    for Edge.Cuts continuity, dimension bounds, and net alignment.
    - Synchronize openauto.project.json and atlas.project.json manifests.
    - Author master documentation (docs/OPENAUTO_CFD.md) detailing microfluidic
    multiphysics, Stokes flow, membrane safety, 3D visualizer, and KiCad plugin.
    - Add OpenAuto-CFD unit test suite (tests/test_openauto_cfd.py) to run_tests.py
    bringing total test count to 100 passing tests (0 collisions).
    - Add npm scripts (openauto:validate, openauto:sync, openauto:install-plugin,
    visualize) a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
2026-10-17 Fix amplifier mold cutouts and dynamically extract 12-pin pogo layout
    [build_interposer_kicad.py]
2026-10-18 refactor: Rename Daemon Pore/Sentinel to MR1 across codebase
    - Replaced "Daemon Pore", "Sentinel", and related variations with "MR1" in files.
    - Renamed files matching "sentinel" or "daemon-pore" to "mr1".
    - Ensured file references, includes, makefiles, and render scripts are correctly pointed to the new names.
    - Retained case formatting consistency (`MR1` for PascalCase/UPPER_CASE/Prose, `mr1` for snake_case/filenames).
    [Interposer.kicad_sch, MCU_STM32.kicad_sch, Motor_Drivers.kicad_sch, Power_PD.kicad_sch, Pressure_Sensors.kicad_sch, Pump.kicad_pcb, Pump.kicad_sch, USB_Interconnect.kicad_sch]
2026-10-18 fix: align MR1 terminology and restore baseline pogo hole geometry
    - Update MR1 references across OpenAuto-CFD documentation and README.
    - Ensure baseline pogo pin landing holes are always present in PogoPinHoles.
    - Restore required interface components check in test_interposer_kicad.py.
2026-10-19 fix(housing): bring in feet dimples on Housing_Case_Reader
    Correct location transform calculation for feet dimples on
    Housing_Case_Reader so they are placed at (±42.5, ±42.5) on
    the bottom surface instead of being offset far outside the case body.
2026-10-19 Fix Housing_Case_Reader floating lip and raise height to 15mm
2026-10-19 Fix Housing_Lid_Reader thread depth and outer diameter
    Update Housing_Lid_Reader external thread dimensions to have
    outer width (major OD) of 74.5mm and thread depth of 4.75mm with pitch
    of 8.0mm, matching the legacy BOSL2 ISO metric thread profile. Update
    Torque_Cap_Inner internal thread geometry and THREAD_DEPTH constant
    for mating compatibility.
2026-10-19 fix(interposer): add missing H2-H4 holes and 12-pin pogo target array
    [Interposer.kicad_pcb, Interposer.kicad_sch]
2026-10-20 Fix thread profile generation with tapers and shaft overlap
    Implement generate_helical_thread in src/common.py with trapezoidal
    profile, conical top and bottom lead-in/lead-out tapers, and radial
    core shaft overlap. Update Housing_Lid_Reader, Torque_Cap_Inner, and
    Threaded_Luer_Adapter to use the new thread generator and add unit
    tests in tests/test_thread_profile.py.
2026-10-20 Fix Housing_Pump_Lid center hole and floating lip
    Remove the central pass-through hole from Housing_Pump_Lid in src/housing.py and adjust the bottom indexing lip position so it fuses continuously into a single solid with the lid body. Verified parity with openscad-legacy code.
    [housing_pump.scad]
2026-10-21 Fix microfluidic tubing routing and model overlaps
    - Removed subtractive tubing conduit cuts from Housing_Lid_Reader
    - Adjusted tubing spline routes for all 5 fluid lines to avoid model overlaps and satisfy bend radii limits
2026-10-21 docs: document PCB board status and add Gerber release artifact policy
2026-10-21 fix: Reconcile MR1 board stackup, BOM, interposer, and pore guidelines
    [Interposer.kicad_pcb]
2026-10-22 Configure 2-Layer PTFE Substrate, 3D Guarding & Rigid Anvil
    [Amplifier.kicad_pcb]
2026-10-22 feat: enhance flythrough lighting studio and smooth deliberate animation pacing
    [Interposer.kicad_pcb]
2026-10-22 feat: photorealistic reverse explosion flythrough and multi-scale nanopore renderer
    [Interposer.kicad_pcb]
2026-10-22 Ensure PlatformIO is auto-installed into venv in install.sh
    Updated install.sh and export_manager.py to properly detect and automatically install PlatformIO into the local .venv virtual environment if missing.
    [export_manager.py]
2026-10-22 feat: Add Path 2 wideband TIA channel for 200nm pores
2026-10-23 Add formal verification proof suite using Z3 SMT solver
    Convert empirical tests and add formal proofs across firmware protocol,
    physics/analog front-end, and geometric CAD invariants in
    tests/test_formal_proofs.py. Integrated into run_tests.py.
2026-10-23 Expand formal verification suite with SMT and property-based proofs
    Add formal SMT proofs and property-based fuzz tests across microfluidics,
    electrokinetics, pump firmware ESTOP interlocks, and Hypothesis property
    equivalence testing in tests/test_formal_proofs.py. All 114 tests pass.
2026-10-23 Add comprehensive SMT formal proofs and property-based verification
    Added formal mathematical SMT proofs and property-based fuzz tests across
    firmware protocol, physics, CAD invariants, microfluidics, electrokinetics,
    pump ESTOP interlocks, DAQ protocol, and state machines in
    tests/test_formal_proofs.py. All 118 test cases pass cleanly.
2026-10-25 lots of refinements.
    [Amplifier.kicad_pcb, Amplifier.kicad_sch, Ignition.kicad_sch, Insturmentation.kicad_sch, MR1.kicad_pcb, MR1.kicad_sch, Microcontroller.kicad_sch, Power.kicad_sch]
2026-10-26 Add topology optimization bridge for torque cap living hinge
    Integrates dl4to topology optimization setup for Torque_Cap_Outer cantilever
    flexure ratchet spring arms, updates pyproject.toml with optional simulation extras,
    applies optimized living hinge arm thickness and root fillet radius to src/torque_cap.py,
    and adds unit tests in tests/test_topology_optimization.py.
2026-10-27 there's issues with the constrictic iterposer mating pad showing up
    [Amplifier.kicad_pcb, Amplifier.kicad_sch]
2026-10-27 added opamp_signal_conditioning and more refined repo
    [Amplifier.kicad_sch, Ignition.kicad_sch, Insturmentation.kicad_sch, MR1.kicad_sch, Microcontroller.kicad_sch, Power.kicad_sch, Pump.kicad_sch]
2026-10-28 adding new symbols
    [Amplifier.kicad_pcb, Amplifier.kicad_sch, Interposer.kicad_pcb, Interposer.kicad_sch]
2026-10-28 Fix syntax errors in KiCad 6-pin pogo target footprints
    Remove invalid (zone_connect 0) tokens from pad definitions in
    generate_footprint.py and update affected .kicad_mod files across
    Amplifier and Interposer footprint directories to conform to KiCad 8
    S-expression footprint specifications.
    [generate_footprint.py]
2026-10-29 updated schematic slightly
    [Amplifier.kicad_sch]
2026-10-29 Add ADC readout route switch (ROUTE_SEL) control across firmware, protocols, and host scripts
    [Interposer.kicad_pcb]
2026-10-29 Tune torque cap flexure arms (tongs) for pogo pin and seal compression
    Adjust Torque_Cap_Outer 6 cantilever flexure arms in src/torque_cap.py
    from a stiff 4.0 mm block to a compliant living hinge thickness of 1.8 mm
    (tuned for 4 perimeter passes of 0.45 mm nozzle PETG) with 2.5 mm root
    fillets and optimized pawl tip engagement. This prevents over-tightening
    against the inner threaded insert while delivering the required clamping
    force for 12 pogo pins (~9.6 N) and silicone gasket compression.
    Document the physical relation in src/constants.py and verify via
    simulations/flexure_living_hinge_fea.py and tests/test_geometry.py.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
    [Interposer.kicad_pcb]
2026-10-29 feat: implement distributed 2x6 pogo pin map ($36mm span) across Bank A and Bank B
    [Interposer.kicad_pcb, Interposer.kicad_sch]
2026-10-29 feat: implement distributed 2x6 pogo pin map ($36mm span) across Bank A and Bank B and resolve merge conflicts
    [Amplifier.kicad_sch, Interposer.kicad_pcb, Interposer.kicad_sch]
2026-11-02 feat(stack): migrate to inverted 12-pin coax pogo stack with one-shot rebuild
    - Establish src/stack_spec.py as single source of truth for 12-pin coax pogo array, fluidic X-channels, layer datums, and spacer budgets
    - Refactor scripts/generate_footprint.py with modular coax footprints (Pad 1 = signal, Pad 2 = outer guard/ground ring) and KiCad 8+ placement extraction
    - Place all 12 pogo pins on F.Cu of inverted amplifier board with mating pads on PTFE interposer
    - Add src/spacers.py with Delrin stock blocks, 0.030" hydrophobic PP shim (capillary depression anti-wicking), and >=3.0mm 3D printed adjustable spacer
    - Assemble inverted cartridge stack in src/assembly.py, achieving 0 CAD collisions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
    [Amplifier.kicad_sch, Interposer.kicad_sch, amplifier.kicad_pcb, mr1_nanopore_reader.scad, repro_colors.scad, test_gasket_plan.scad, test_pump_config.scad, verify_pcb_clearance.scad]
2026-11-02 ci(all): add GitHub Actions workflow, assembly SOP, and crossed X-channel CFD simulation
    - Add .github/workflows/ci.yml with test-and-verify and platformio firmware jobs
    - Create docs/ASSEMBLY_SOP.md detailing layer layup, torque cap calibration, and pre-flight electrical testing
    - Add calculate_crossed_x_flowcell_cfd in simulations/fluidic_dynamics_nanopore.py and test in test_physics_and_simulations.py
    - Verified 3D CAD streaming via ocp_viewer on port 3939
    - All 170 tests passing with 0 collisions and 241 indexed manifest deliverables
2026-11-02 feat(all): complete physical routing, DRC/ERC verification, pump PCB, and release packaging
    [Interposer.kicad_pcb, Pump.kicad_pcb]
2026-11-03 added new tests etc.
    [Amplifier.kicad_pcb, Amplifier.kicad_sch, Ignition.kicad_sch, Insturmentation.kicad_sch, Interposer.kicad_pcb, MR1.kicad_pcb, MR1.kicad_sch, Microcontroller.kicad_sch]
2026-11-03 getting very close to a workable amplifier layout
    [Amplifier.kicad_pcb, Amplifier.kicad_sch]
2026-11-04 Review signal-viewer, add e2e & unit tests, align with API
    - Enhanced MockSerialPort in daq_client.py to synthesize multi-scale
    nanopore translocation events (2 to 50 samples) and realistic 1/f noise.
    - Upgraded websocket_bridge.py with 10 Hz telemetry JSON broadcasting
    per DAQ_STREAMING_SPEC.md and client bidirectional control dispatch
    (set_bias, emergency_stop, set_pump).
    - Expanded signal.js and app.js with dual binary/JSON message decoding,
    missing-sample gap handling, UI telemetry status badges, and pore bias/ESTOP controls.
    - Extended signal-viewer unit test suite (10 tests) covering pyramid
    downsampling, multi-scale transients, and packet drop handling.
    - Implemented single-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
    [bundle_signal_viewer.py, daq_client.py]
