EpicQuestBio/MR1/(notices)

Notices in the files:
datasheets/LJX39-PP0.stp:
author */ ('License CC BY-ND 4.0'),
